ben5049/Keyboard/README.md

# Keyboard

## V3

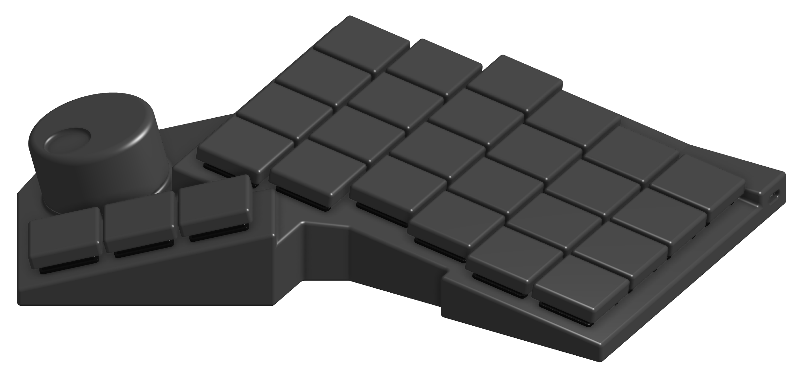
[picture p1: Documentation/Images/keyboard-v3-right.png]
right


Features:
- Wireless
    - 900mAh battery
    - Bluetooth (nRF52)
    - ZMK
- 4 Port USB hub
- BLDC Knob for haptic feedback
- Kailh Choc V1 switches

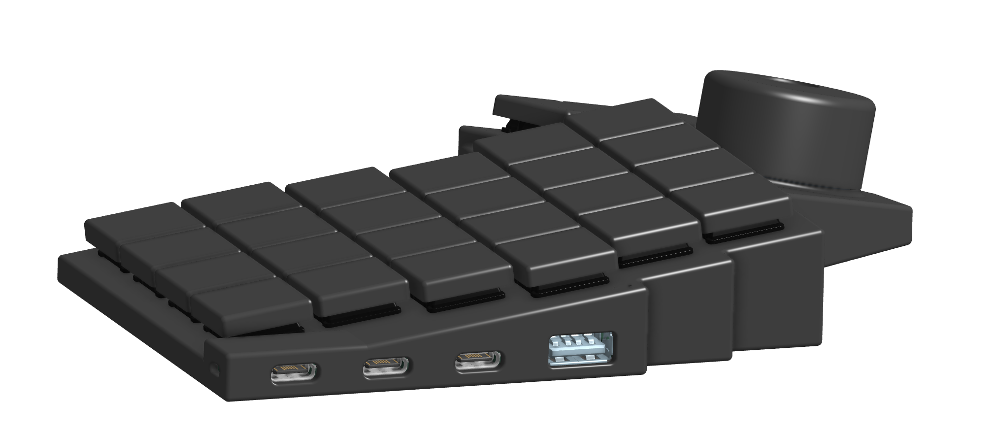
[picture p2: Documentation/Images/keyboard-v3-usb-ports.png]
usb
