ben5049/Keyboard/Documentation/Images/back.png

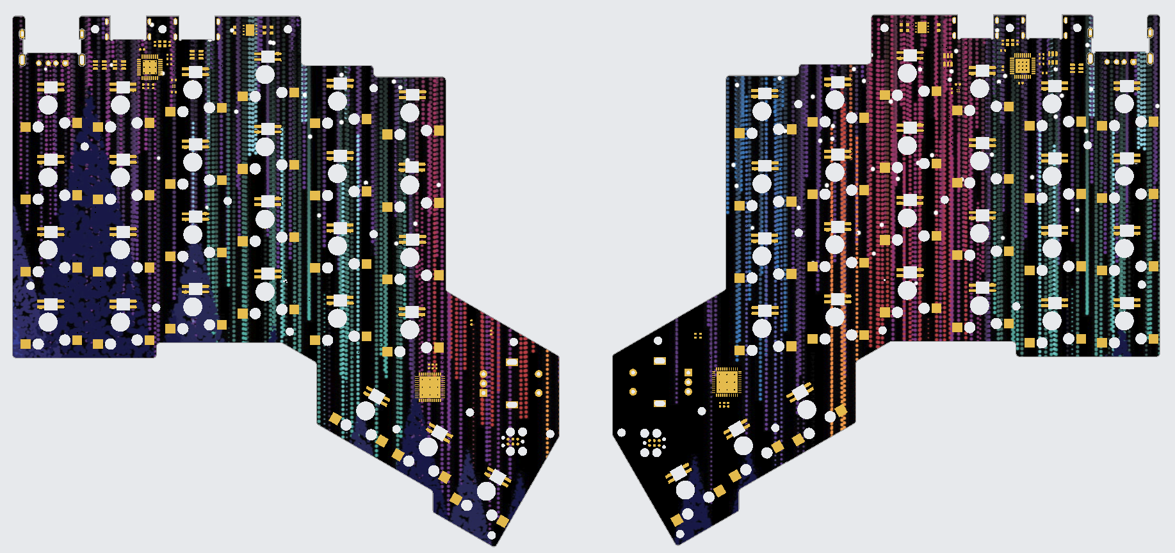
Documentation/Images/back.png
