ben5049/Keyboard/Documentation/Images/left.png

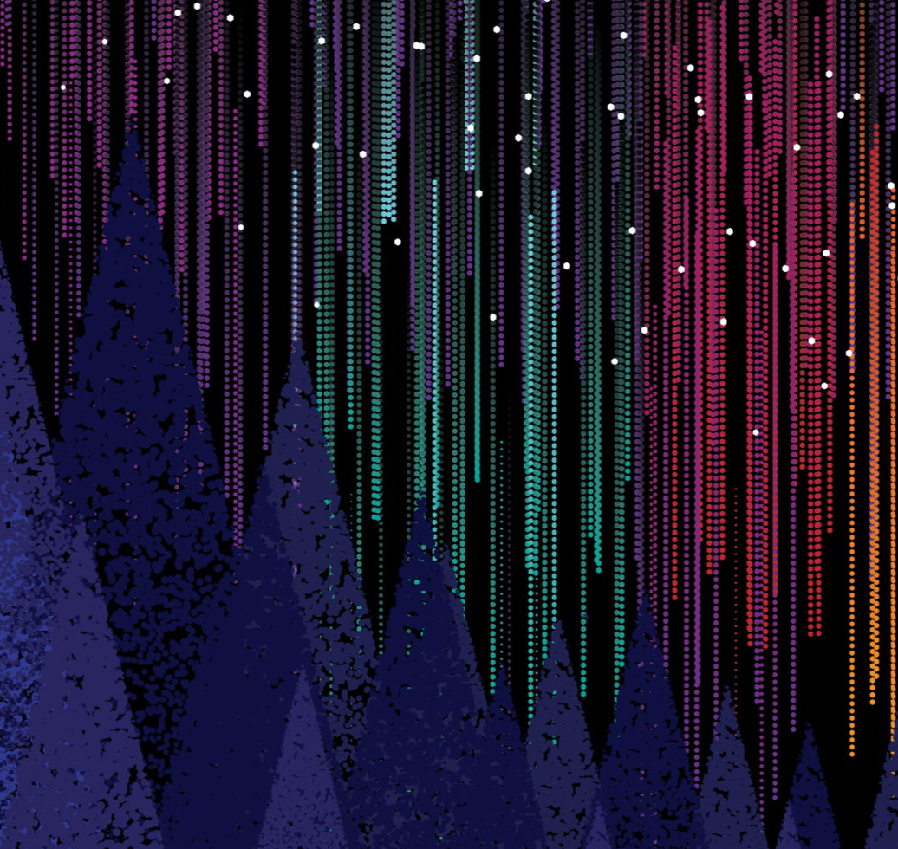
Documentation/Images/left.png
