ben5049/Keyboard/Documentation/Images/Low profile gateron hot swap socket.png

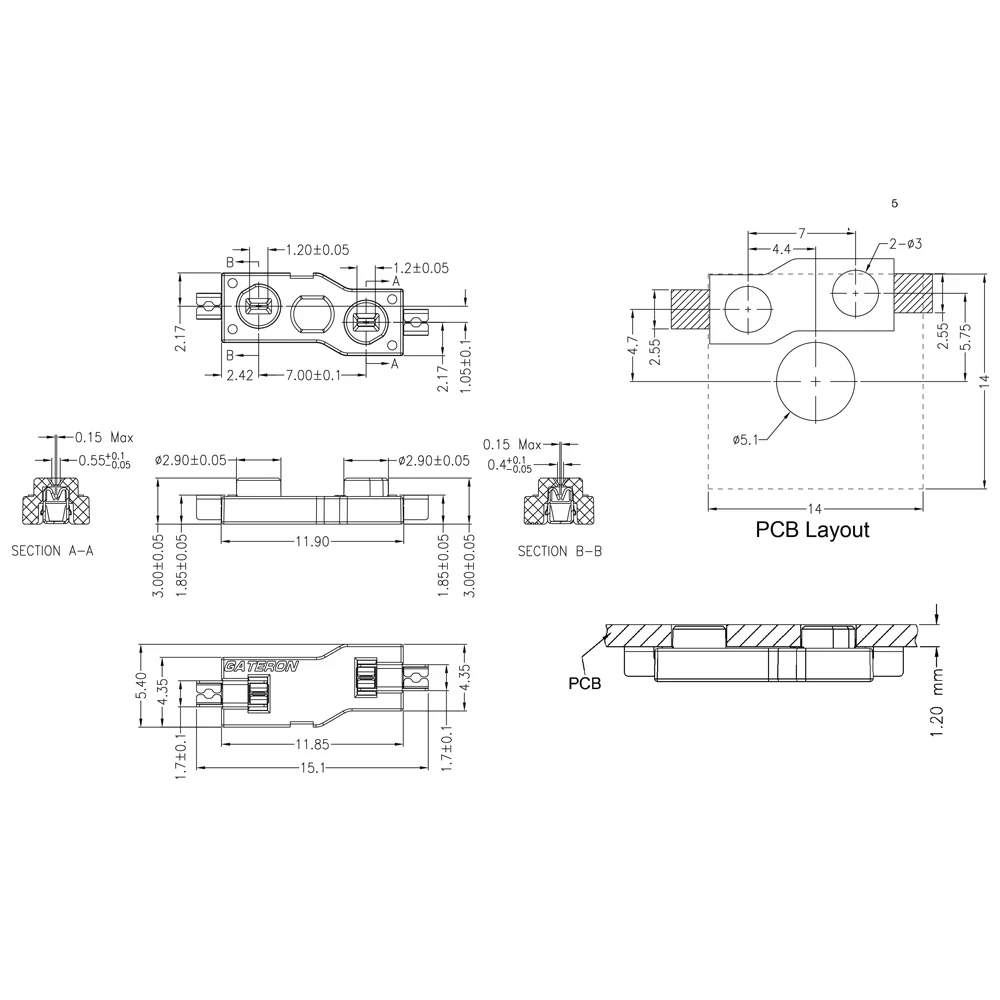
Documentation/Images/Low profile gateron hot swap socket.png
