ben5049/Keyboard/Documentation/Images/right.png

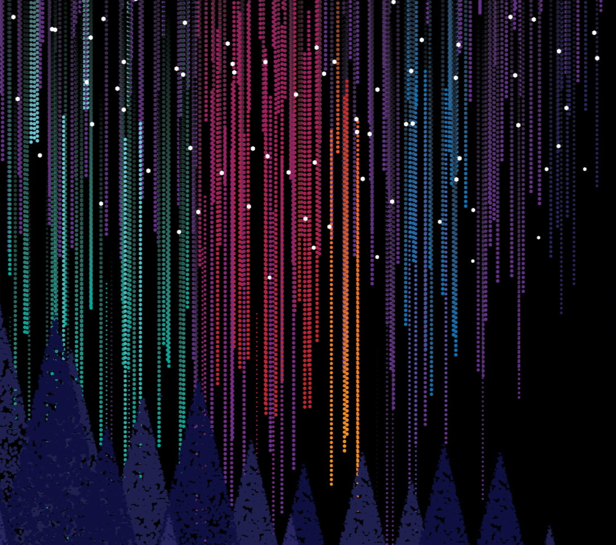
Documentation/Images/right.png
