ben5049/Keyboard/Documentation/Images/wallpaperflare.com_wallpaper.png

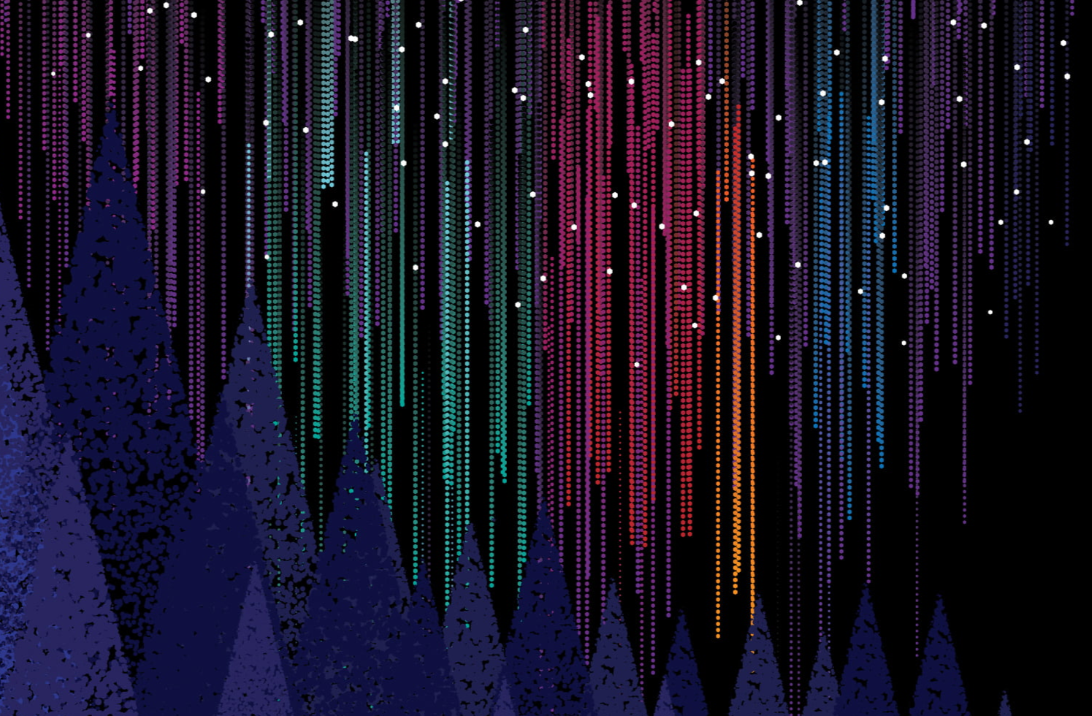
Documentation/Images/wallpaperflare.com_wallpaper.png
