ben5049/Keyboard/Documentation/Images/WIP render.png

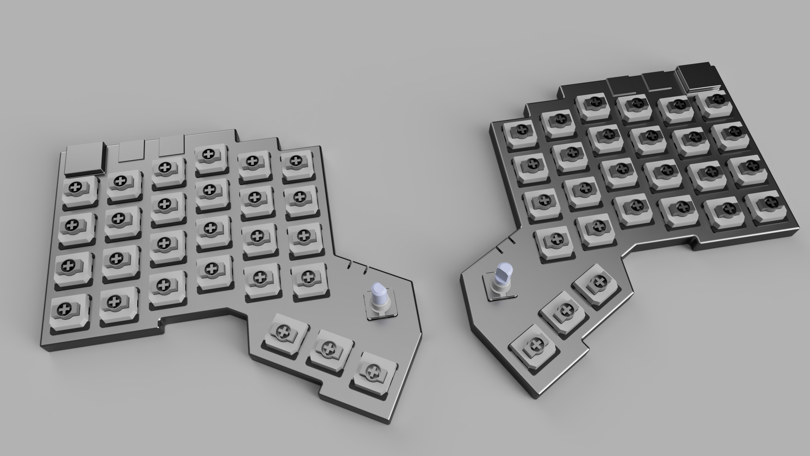
Documentation/Images/WIP render.png
