ben5049/Keyboard/Documentation/BOM.xlsx

Sheet: Overall
 | Unit cost | Quantity bought | Quantity needed | Shipping | Total cost | Single unit cost | Link
Left board | 3.71 | 5 | 1 | 29.61 | 48.16 | 9.63 | https://jlcpcb.com/user-center/orderDetails/?batchNum=W202405140523158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
Right board | 5.04 | 5 | 1 | 29.94 | 55.12 | 11.02 | https://jlcpcb.com/user-center/orderDetails/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,3
Knob | 3.90 | 2 | 2 | 2.99 | 10.79 | 10.79 | https://thepihut.com/products/solid-machined-metal-knob-1-diameter
Cable | 15.92 | 1 | 1 | 12.79 | 28.71 | 28.71 | https://www.bhphotovideo.com/c/product/1734345-REG/kondor_blue_kb_usbc_cra_bk_coiled_usb_c_right_angle.html
Switches | 0.28 | 110 | 54 | 4.76 | 35.76 | 17.55 | https://www.keychron.uk/products/low-profile-gateron-mechanical-switch-set?variant=43373223706794
Keycaps | 27.61 | 1 | 1 | 0.00 | 27.61 | 27.61 | https://www.amazon.co.uk/Womier-Keyboard-Switches-Mechanical-Backlight/dp/B0BVYV67QS
Hot-swap sockets | 0.08 | 70 | 54 | 3.82 | 9.65 | 7.44
Electronic components |  |  |  |  | 66.03 | 51.82
 |  |  |  |  | 0.00
 |  |  |  |  | 0.00
 |  |  |  |  | 0.00
 |  |  |  |  | 0.00
 |  |  |  |  | 281.8288 | 164.59

Sheet: Electronics
 |  | Unit cost | Quantity bought | Quantity needed | Total cost | Single unit cost | Link
SK6812-E | Neopixel | 0.24 | 60 | 54 | 14.16 | 12.74 | https://www.mouser.co.uk/ProductDetail/Adafruit/4960?qs=pBJMDPsKWf1Q%252BqeEoLnQjA%3D%3D
GSB12J21C1EU | USB A | 0.61 | 3 | 2 | 1.82 | 1.22 | https://www.mouser.co.uk/ProductDetail/Amphenol-Commercial-Products/GSB12J21C1EU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
USB4510-03-1-A | USB C | 0.64 | 5 | 4 | 3.20 | 2.56 | https://www.mouser.co.uk/ProductDetail/GCT/USB4510-03-1-A?qs=7D1LtPJG0i3iod3O3OZ7LA%3D%3D
USBLC6-4SC6 | ESD Protection | 0.31 | 7 | 6 | 2.18 | 1.87 | https://www.mouser.co.uk/ProductDetail/STMicroelectronics/USBLC6-4SC6?qs=k9dH%2Fx4GHJCNdehb8zInZg%3D%3D
M24256X-FCU6T/VF | EEPROM | 0.42 | 3 | 2 | 1.25 | 0.83 | https://www.mouser.co.uk/ProductDetail/STMicroelectronics/M24256X-FCU6T-VF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
LM1117LD-3.3_NOPB | Regulator | 1.20 | 3 | 2 | 3.60 | 2.40 | https://www.mouser.co.uk/ProductDetail/Texas-Instruments/LM1117LD-3.3-NOPB?qs=X1J7HmVL2ZGwq0CPAkvTtg%3D%3D
STM32G0C1CEU6 | MCU | 4.88 | 2 | 2 | 9.76 | 9.76 | https://www.mouser.co.uk/ProductDetail/STMicroelectronics/STM32G0C1CEU6?qs=CiayqK2gdcIQOTKCTdXSKw%3D%3D
USB2533-1080AEN | USB Hub | 3.56 | 2 | 2 | 7.12 | 7.12 | https://www.mouser.co.uk/ProductDetail/Microchip-Technology/USB2533-1080AEN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
CX2016SA24000D0HLLG3 | USB Crystal | 0.26 | 3 | 2 | 0.77 | 0.51 | https://www.mouser.co.uk/ProductDetail/KYOCERA-AVX/CX2016SA24000D0HLLG3?qs=Imq1NPwxi75jFZJ74DHKZA%3D%3D
CRGP0402F12K | 12k Resistor | 0.01 | 100 | 2 | 1.50 | 0.03 | https://www.mouser.co.uk/ProductDetail/TE-Connectivity-Holsworthy/CRGP0402F12K
MCASU105SCG100DFNA01 | 10pF Capacitor | 0.01 | 100 | 4 | 1.50 | 0.06 | https://www.mouser.co.uk/ProductDetail/TAIYO-YUDEN/MCASU105SCG100DFNA01
RIC11-31S15K7-TH | Encoder Long | 2.04 | 2 | 0 | 4.08 | 0.00 | https://www.mouser.co.uk/ProductDetail/CUI-Devices/RIC11-31S15K7-TH?qs=HoCaDK9Nz5dozMKAx6eaHw%3D%3D
RIC11-31S10K2-GSMT | Encoder Short | 2.04 | 2 | 2 | 4.08 | 4.08 | https://www.mouser.co.uk/ProductDetail/CUI-Devices/RIC11-31S15K7-TH?qs=HoCaDK9Nz5dozMKAx6eaHw%3D%3D
 |  |  |  | Total | 55.02 | 43.19
 |  |  |  | With VAT | 66.03 | 51.82
