ben5049/Keyboard/CAD/keyboard-v3/debug-cover.step

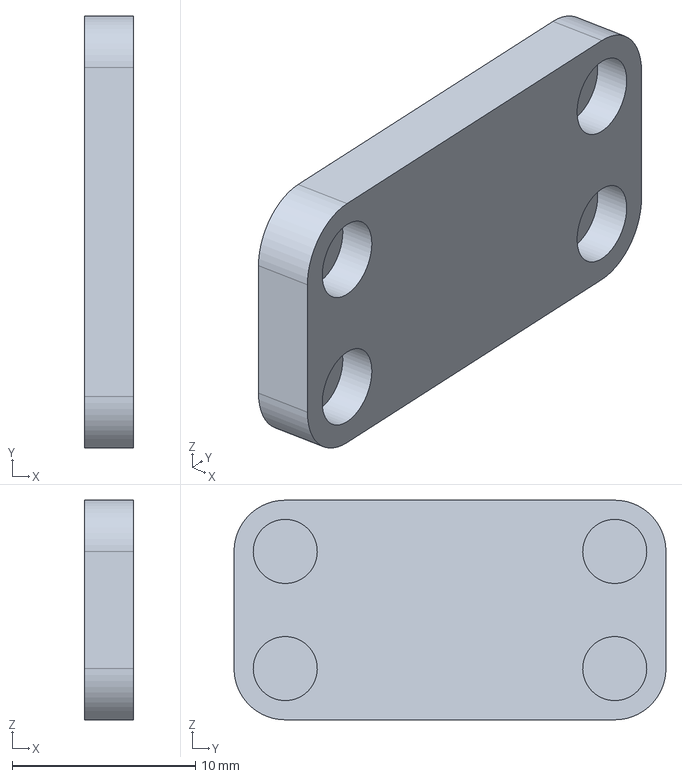
[picture p9: CAD file, 2026-03-02]
CAD/keyboard-v3/debug-cover.step
2.70 x 23.6 x 12.0 mm
