ben5049/Keyboard/PCBs/keyboard-v3/debug-breakout/debug-breakout.step

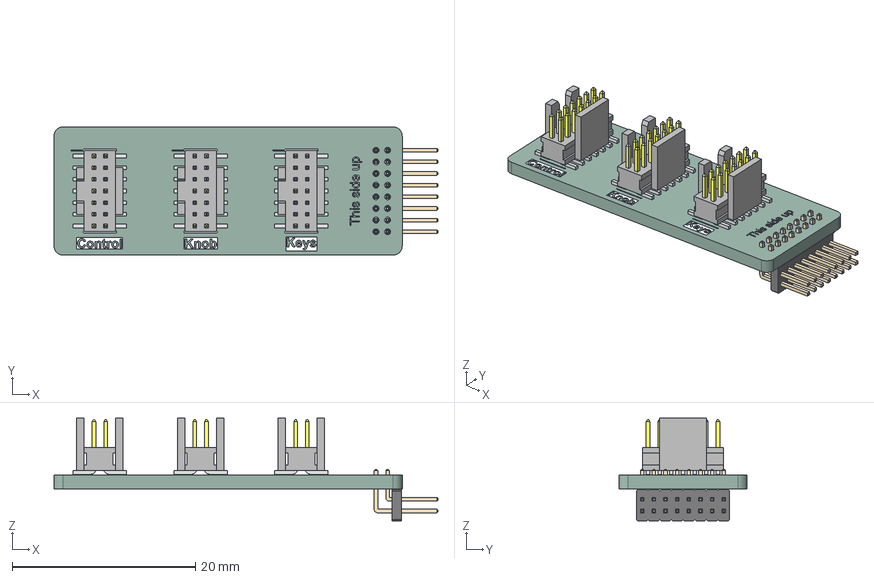
[picture p10: CAD file, 2026-03-02]
PCBs/keyboard-v3/debug-breakout/debug-breakout.step
41.9 x 14.0 x 11.2 mm
FTSH-107-01-L-DV-K_pins2 x 3
FTSH-107-01-L-DV-K_pins1 x 3
FTSH-107-01-L-DV-K_body x 3
PinHeader_2x08_P1.27mm_Horizontal
debug-breakout_silkscreen x 2
debug-breakout_PCB
