ben5049/Keyboard/PCBs/keyboard-v3/drawings/key-fpc-outline.dxf

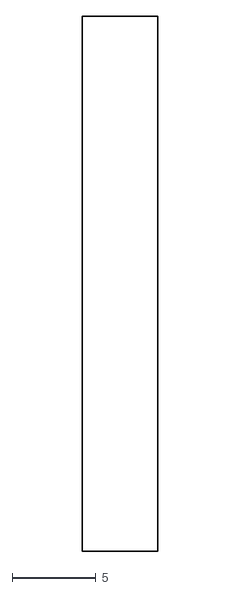
[picture p11: CAD file, 2026-02-13]
PCBs/keyboard-v3/drawings/key-fpc-outline.dxf
4.50 x 32.0
