ben5049/Keyboard/PCBs/keyboard-v3/left-control-board/left-control-board.step

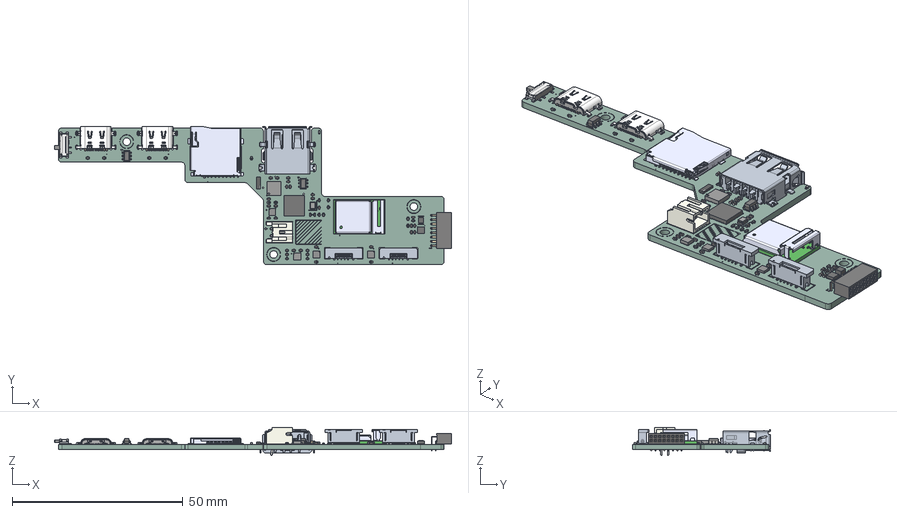
[picture p12: CAD file, 2026-03-02]
PCBs/keyboard-v3/left-control-board/left-control-board.step
116.2 x 40.5 x 8.25 mm
C_0402_1005Metric x 29
PinSocket_2x08_P1.27mm_Horizontal
R_0402_1005Metric x 19
L_Wurth_WE-MAPI_1610
LED_0402_1005Metric
PIN1_AREA
ThermalPin x 2
PinsArrayLR x 2
EMIF06-MSD02N16
Crystal_SMD_2016-4Pin_2.0x1.6mm
NCP380HMU05AATBG x 3
NINA-B302-00B
USB4510 x 2
MSD-1-A
BODY-SON
PIN1-ID
SOT-23-6 x 2
GSB12J21C1EU
PCM12SMTBR
PinsArrayTB
JST_PH_S2B-PH-K_1x02_P2.00mm_Horizontal
left-control-board_silkscreen x 2
left-control-board_PCB
