ben5049/Keyboard/PCBs/keyboard-v3/left-key-board/left-key-board.step

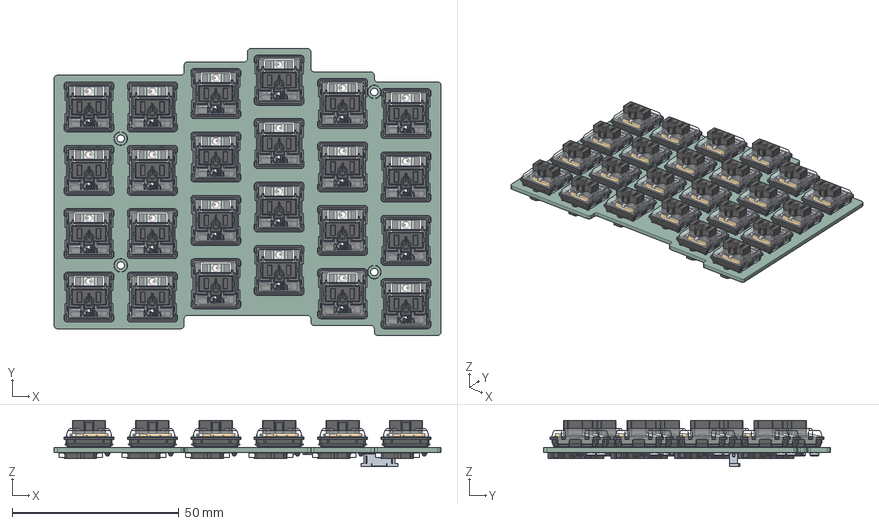
[picture p13: CAD file, 2026-03-02]
PCBs/keyboard-v3/left-key-board/left-key-board.step
116.0 x 86.0 x 13.9 mm
bottom_stabilizer x 24
contact x 24
pin1 x 24
pin2 x 24
top_stabilizer x 24
stabilizer x 24
stem_stabilizer x 24
shrunken_spring x 24
choc_body x 24
contact_a1 x 24
contact_a2 x 24
contact_b x 24
contact_a003 x 24
contact_a004 x 24
contact_b001 x 24
C_0402_1005Metric x 13
R_0402_1005Metric x 5
sk6812mini-e x 24
Pins
ThermalPin
PinsArrayLR
PinsArrayTB
left-key-board_silkscreen x 2
left-key-board_PCB
