ben5049/Keyboard/PCBs/keyboard-v3/left-knob-board/left-knob-board.step

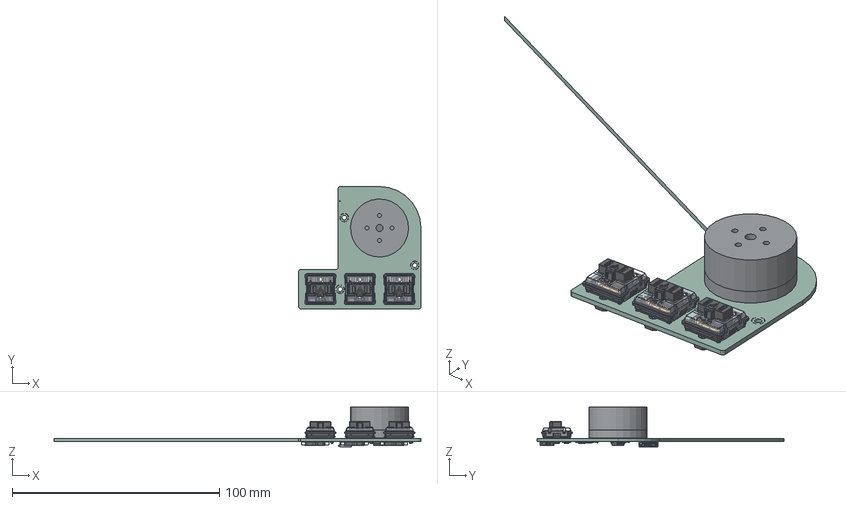
[picture p14: CAD file, 2026-03-02]
PCBs/keyboard-v3/left-knob-board/left-knob-board.step
177.0 x 119.0 x 19.2 mm
bottom_stabilizer x 3
contact x 3
pin1 x 3
pin2 x 3
top_stabilizer x 3
stabilizer x 3
stem_stabilizer x 3
shrunken_spring x 3
choc_body x 3
contact_a1 x 3
contact_a2 x 3
contact_b x 3
contact_a003 x 3
contact_a004 x 3
contact_b001 x 3
Rotor
Stator
C_0402_1005Metric x 12
R_0402_1005Metric x 8
ThermalPin x 2
PinsArrayLR x 2
PinsArrayTB x 2
F31L_L
F31L_R
sk6812mini-e x 3
Pins x 3
C_0603_1608Metric
SOIC-8_3.9x4.9mm_P1.27mm
left-knob-board_silkscreen x 2
left-knob-board_PCB
