ben5049/Keyboard/PCBs/keyboard-v3/right-control-board/right-control-board.step

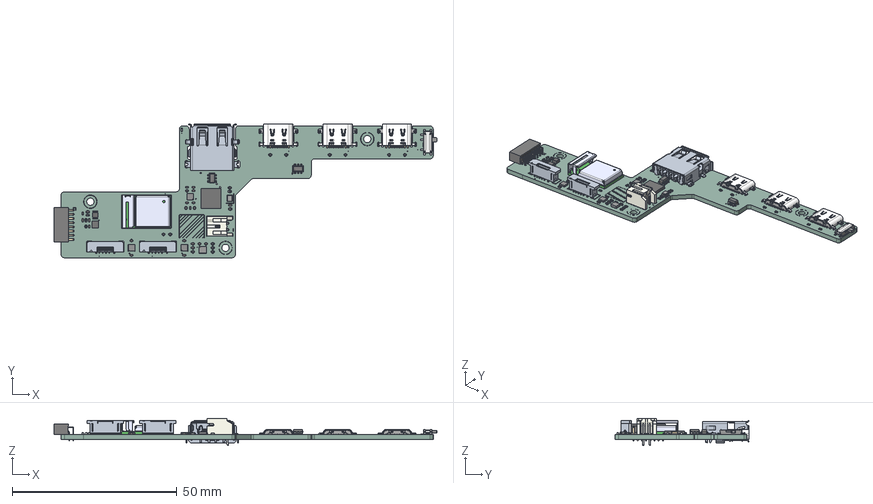
[picture p15: CAD file, 2026-03-02]
PCBs/keyboard-v3/right-control-board/right-control-board.step
116.1 x 40.5 x 8.25 mm
C_0402_1005Metric x 20
PinSocket_2x08_P1.27mm_Horizontal
R_0402_1005Metric x 21
L_Wurth_WE-MAPI_1610
USB4510 x 3
LED_0402_1005Metric
PIN1_AREA
ThermalPin
PinsArrayLR
Crystal_SMD_2016-4Pin_2.0x1.6mm
NCP380HMU05AATBG x 3
NINA-B302-00B
BODY-SON
PIN1-ID
SOT-23-6 x 2
GSB12J21C1EU
PCM12SMTBR
JST_PH_S2B-PH-K_1x02_P2.00mm_Horizontal
right-control-board_silkscreen x 2
right-control-board_PCB
