ben5049/Keyboard/PCBs/keyboard-v3/right-key-board/right-key-board.step

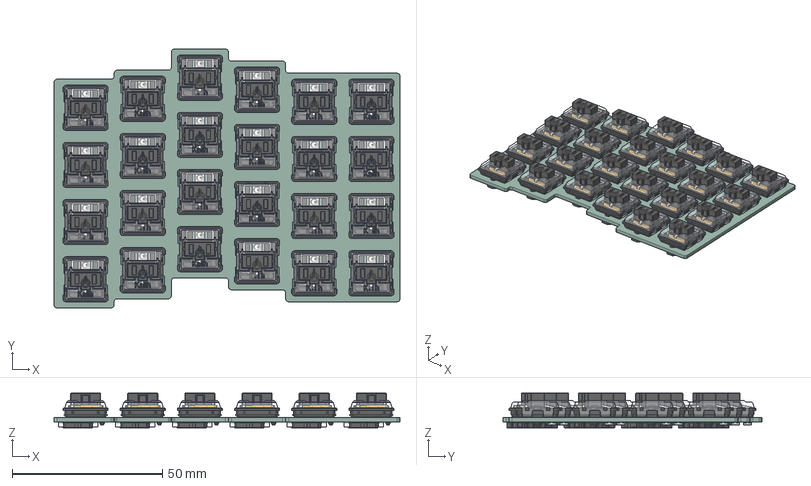
[picture p16: CAD file, 2026-02-08]
PCBs/keyboard-v3/right-key-board/right-key-board.step
115.0 x 86.0 x 11.5 mm
bottom_stabilizer x 24
contact x 24
pin1 x 24
pin2 x 24
top_stabilizer x 24
stabilizer x 24
stem_stabilizer x 24
shrunken_spring x 24
choc_body x 24
contact_a1 x 24
contact_a2 x 24
contact_b x 24
contact_a003 x 24
contact_a004 x 24
contact_b001 x 24
sk6812mini-e x 24
right-key-board_PCB
