ben5049/Keyboard/CAD/keyboard-v3/knob.step

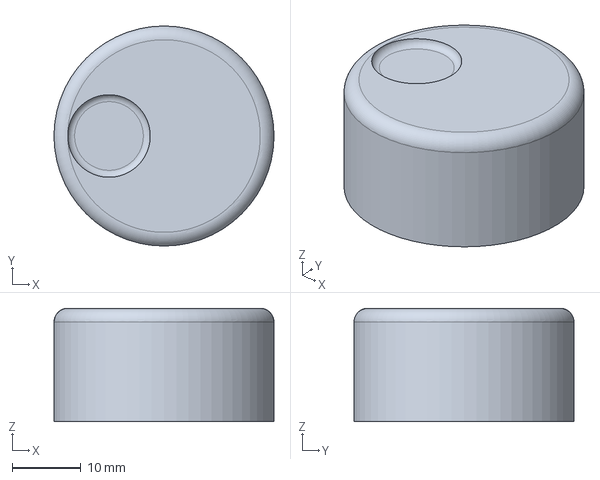
[picture p18: CAD file, 2026-03-02]
CAD/keyboard-v3/knob.step
32.0 x 32.0 x 16.5 mm
