ben5049/Keyboard/PCBs/keyboard-v3/drawings/knob-fpc-mask.dxf

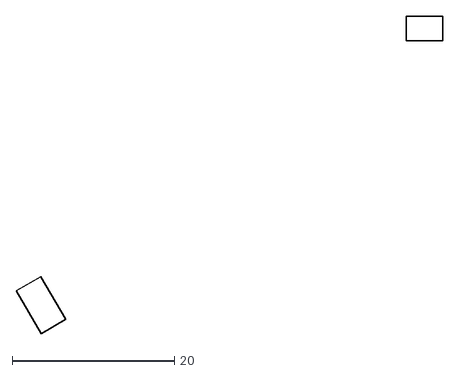
[picture p19: CAD file, 2026-02-13]
PCBs/keyboard-v3/drawings/knob-fpc-mask.dxf
52.5 x 39.1
