ben5049/Keyboard/CAD/keyboard-v3/left-base.step

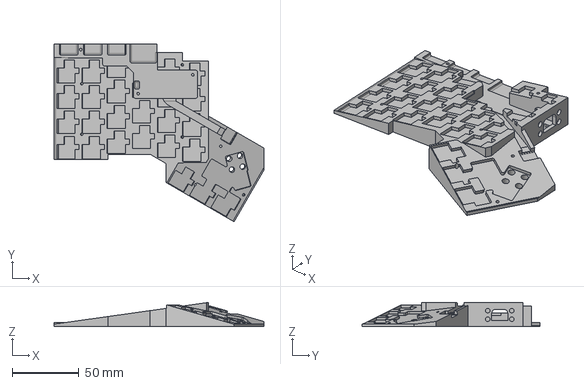
[picture p20: CAD file, 2026-03-02]
CAD/keyboard-v3/left-base.step
157.3 x 133.0 x 18.1 mm
