ben5049/Keyboard/PCBs/keyboard-v3/drawings/knob-fpc-stiffener.dxf

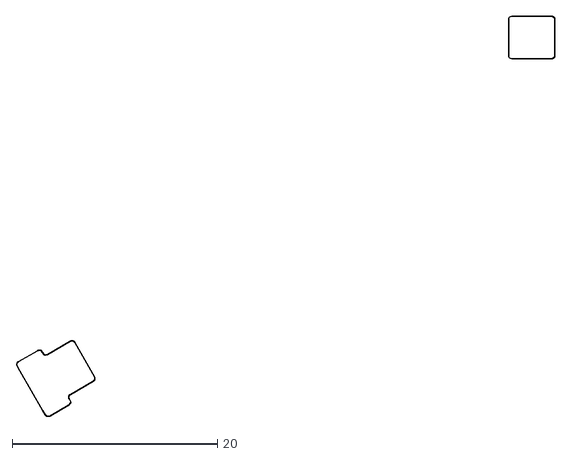
[picture p21: CAD file, 2026-02-13]
PCBs/keyboard-v3/drawings/knob-fpc-stiffener.dxf
52.5 x 39.0
