ben5049/Keyboard/PCBs/keyboard-v3/drawings/knob-fpc-traces.dxf

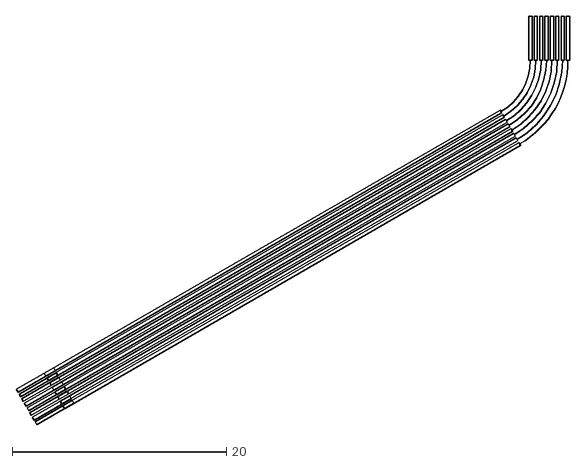
[picture p22: CAD file, 2026-02-13]
PCBs/keyboard-v3/drawings/knob-fpc-traces.dxf
51.6 x 38.1
