ben5049/Keyboard/CAD/keyboard-v3/left-case.step

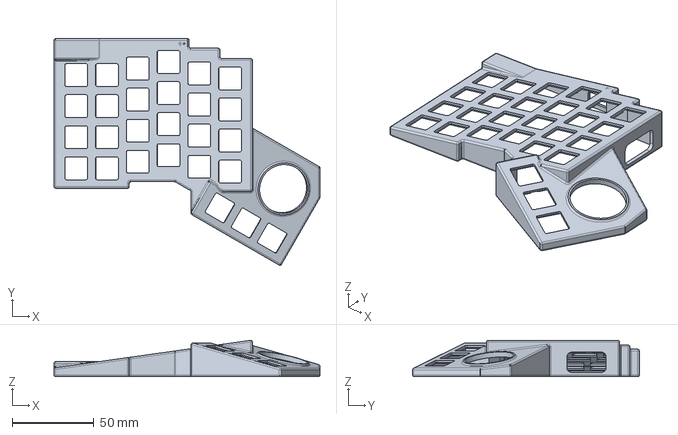
[picture p23: CAD file, 2026-03-02]
CAD/keyboard-v3/left-case.step
162.7 x 138.6 x 22.2 mm
