ben5049/Keyboard/PCBs/keyboard-v3/drawings/right-control-board-layout.dxf

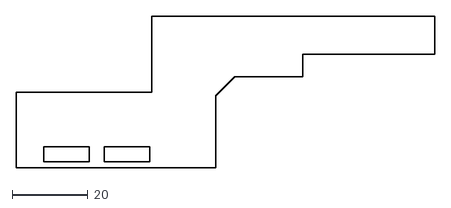
[picture p24: CAD file, 2026-02-12]
PCBs/keyboard-v3/drawings/right-control-board-layout.dxf
110.9 x 40.0
