ben5049/Keyboard/PCBs/keyboard-v3/drawings/knob-fpc-outline.dxf

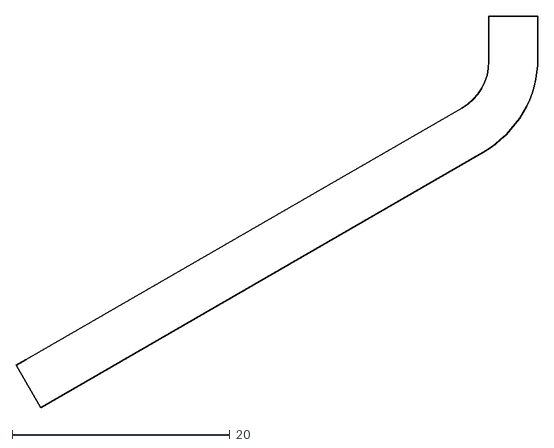
[picture p25: CAD file, 2026-02-12]
PCBs/keyboard-v3/drawings/knob-fpc-outline.dxf
48.0 x 36.0
