ben5049/Keyboard/CAD/keyboard-v3/right-battery-cover.step

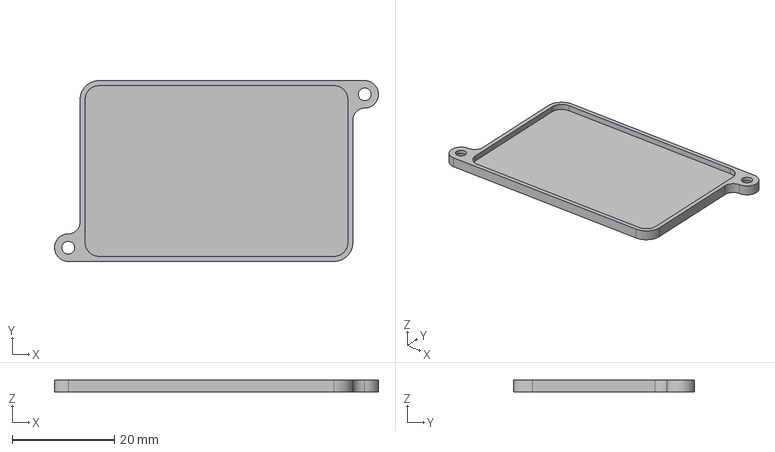
[picture p26: CAD file, 2026-03-02]
CAD/keyboard-v3/right-battery-cover.step
63.4 x 35.4 x 2.30 mm
