ben5049/Keyboard/PCBs/keyboard-v3/drawings/right-knob-board-outline.dxf

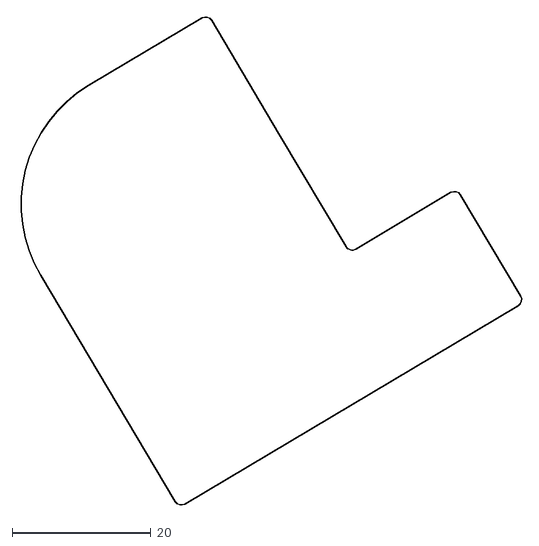
[picture p27: CAD file, 2026-02-11]
PCBs/keyboard-v3/drawings/right-knob-board-outline.dxf
73.1 x 70.7
