ben5049/Keyboard/PCBs/keyboard-v3/drawings/right-control-board-outline.dxf

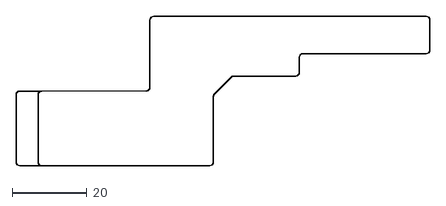
[picture p28: CAD file, 2026-02-11]
PCBs/keyboard-v3/drawings/right-control-board-outline.dxf
110.9 x 40.0
