ben5049/Keyboard/PCBs/keyboard-v3/drawings/right-key-board-outline.dxf

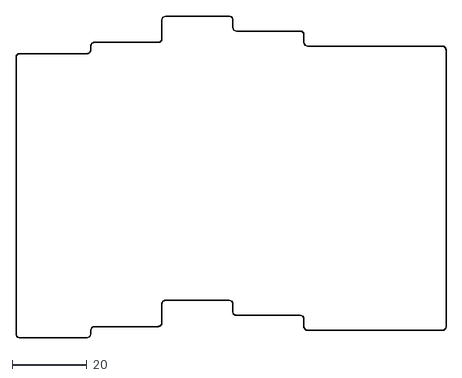
[picture p29: CAD file, 2026-02-10]
PCBs/keyboard-v3/drawings/right-key-board-outline.dxf
115.0 x 86.0
