ben5049/Keyboard/PCBs/keyboard-v3/drawings/right-key-board-layout.dxf

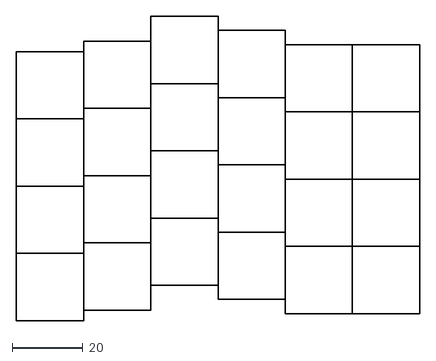
[picture p30: CAD file, 2026-02-10]
PCBs/keyboard-v3/drawings/right-key-board-layout.dxf
114.0 x 86.0
