ben5049/Keyboard/PCBs/keyboard-v3/drawings/right-key-board-components.dxf

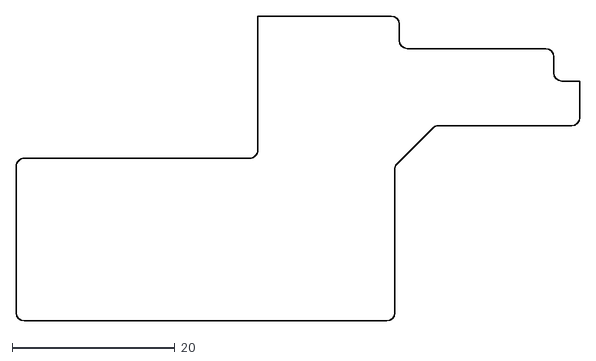
[picture p31: CAD file, 2026-02-10]
PCBs/keyboard-v3/drawings/right-key-board-components.dxf
69.3 x 37.5
