ben5049/Keyboard/PCBs/keyboard-v3/drawings/right-knob-board-layout.dxf

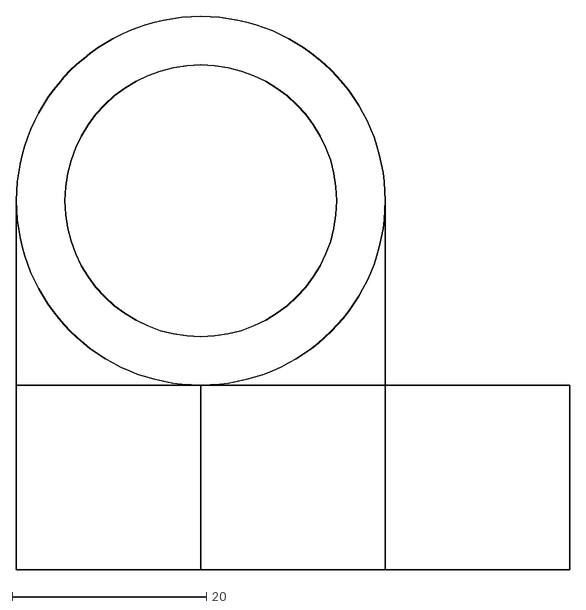
[picture p32: CAD file, 2026-02-08]
PCBs/keyboard-v3/drawings/right-knob-board-layout.dxf
57.0 x 57.0
