ben5049/Keyboard/(list of files, cad)

Other CAD files:
CAD/keyboard-v3/right-base.step
CAD/keyboard-v3/right-case.step
CAD/keyboard-v3/left-battery-cover.step
CAD/keyboard-v1/LED Cover x8.stl
CAD/keyboard-v1/LED Cover.stl
CAD/keyboard-v1/Left bottom no holes.stl
CAD/keyboard-v1/Left bottom.stl
CAD/keyboard-v1/Left frame.stl
CAD/keyboard-v1/Right bottom no holes.stl
CAD/keyboard-v1/Right bottom.stl
CAD/keyboard-v1/Right frame.stl
CAD/keyboard-v1/whole assembly.f3z
CAD/keyboard-v1/whole assembly.step
