ben5049/Keyboard/PCBs/keyboard-v3/left-control-board/left-control-board.pdf

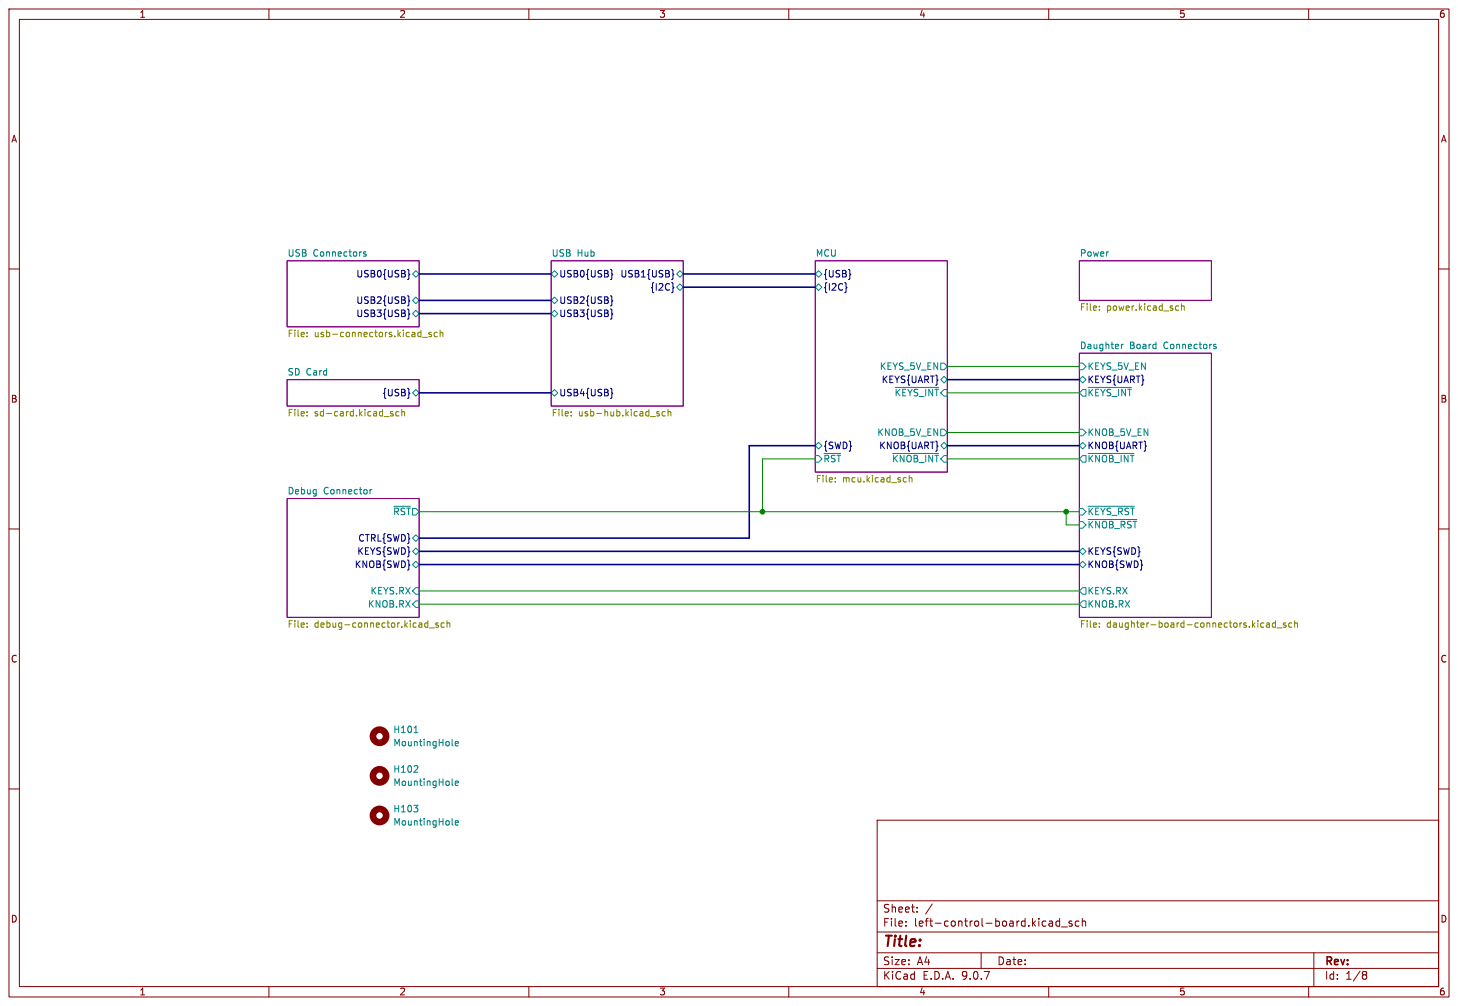
[picture p33: page 1]

USB2{USB} USB Hub File: usb-hub.kicad_sch H101 MountingHole H102 MountingHole H103 MountingHole

KNOB.RX Daughter Board Connectors File: daughter-board-connectors.kicad_sch Power File: power.kicad_sch
~{KNOB_RST} KEYS_5V_EN
KEYS{UART}
~{KEYS_INT} KNOB_5V_EN
~{KNOB_INT} KEYS.RX

USB3{USB} USB Connectors File: usb-connectors.kicad_sch

File: mcu.kicad_sch USB0{USB} USB1{USB}

KNOB.RX Debug Connector File: debug-connector.kicad_sch

Id: 1/8 Title: File: left-control-board.kicad_sch Sheet: / CTRL{SWD}
KEYS{SWD}
KNOB{SWD}

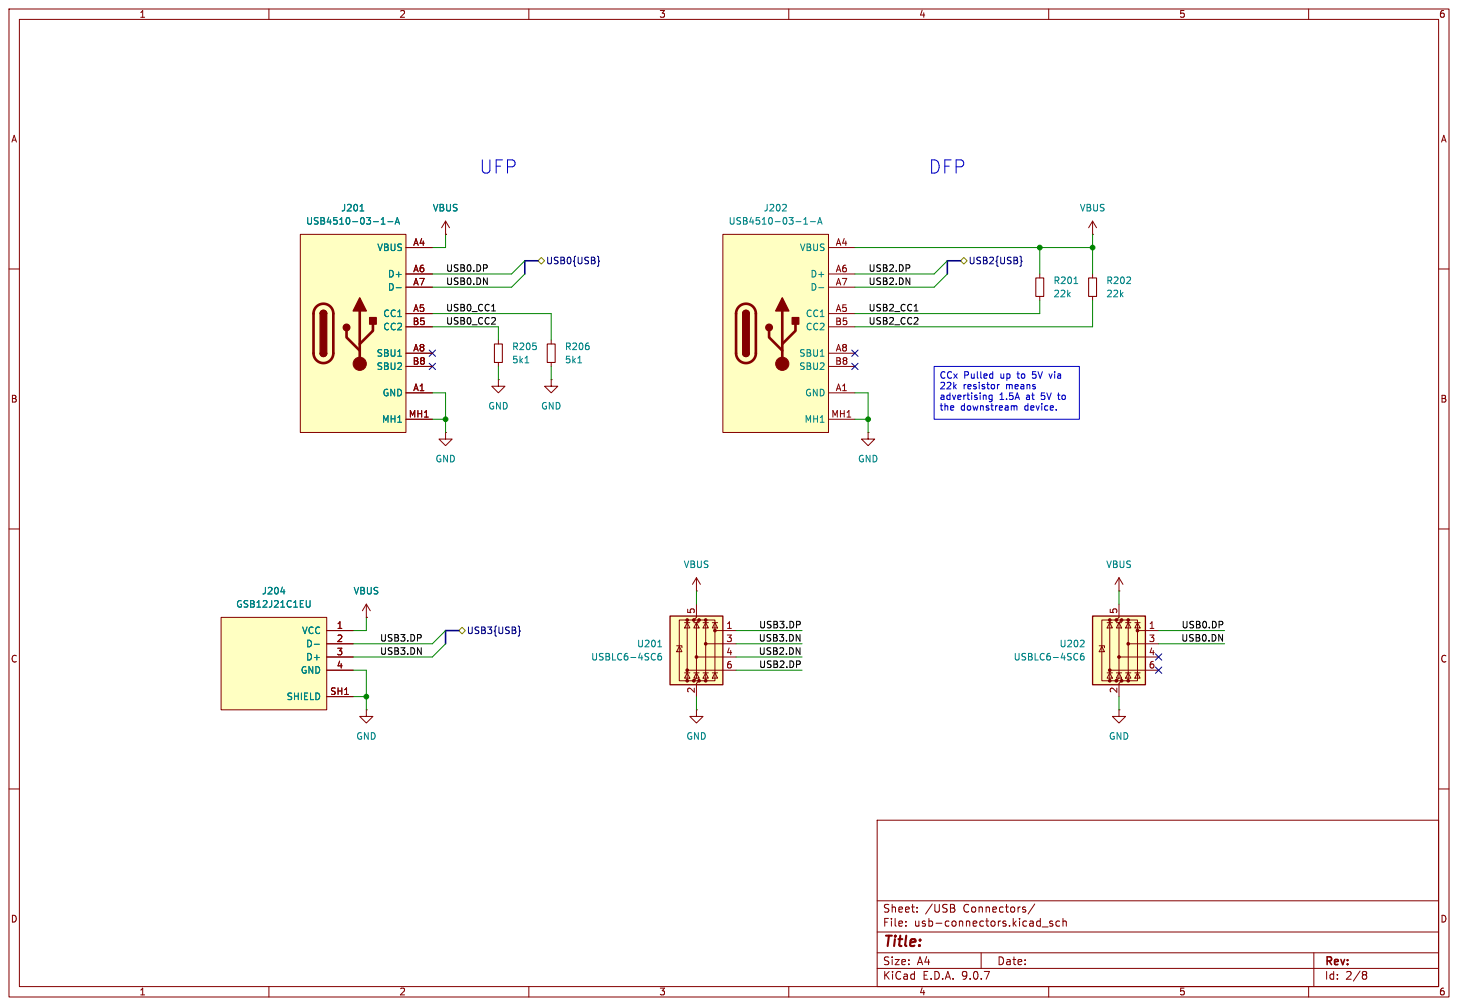
[picture p34: page 2]

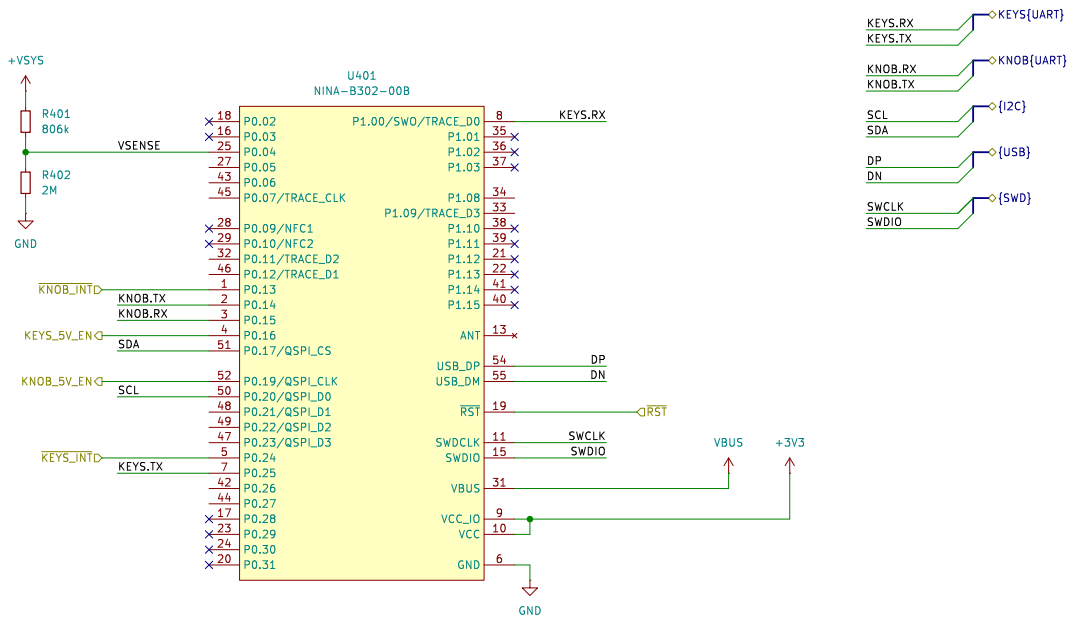
[picture p35: page 3]

Id: 4/8 Title: File: mcu.kicad_sch Sheet: /MCU/

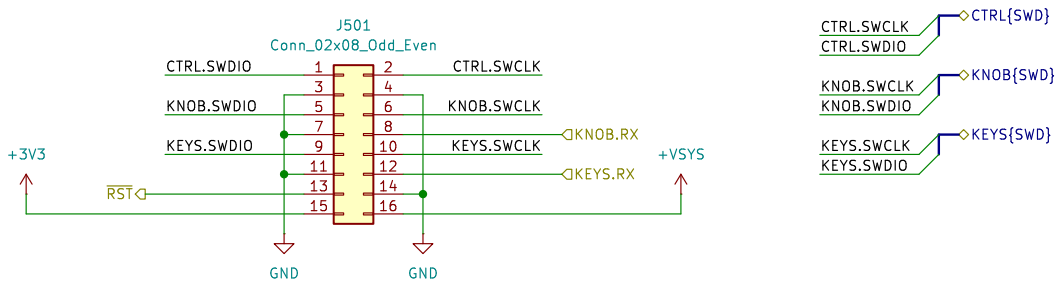
[picture p36: page 4]

5 7 | J501 Conn_02x08_Odd_Even GND | 6 8

CTRL.SWCLK

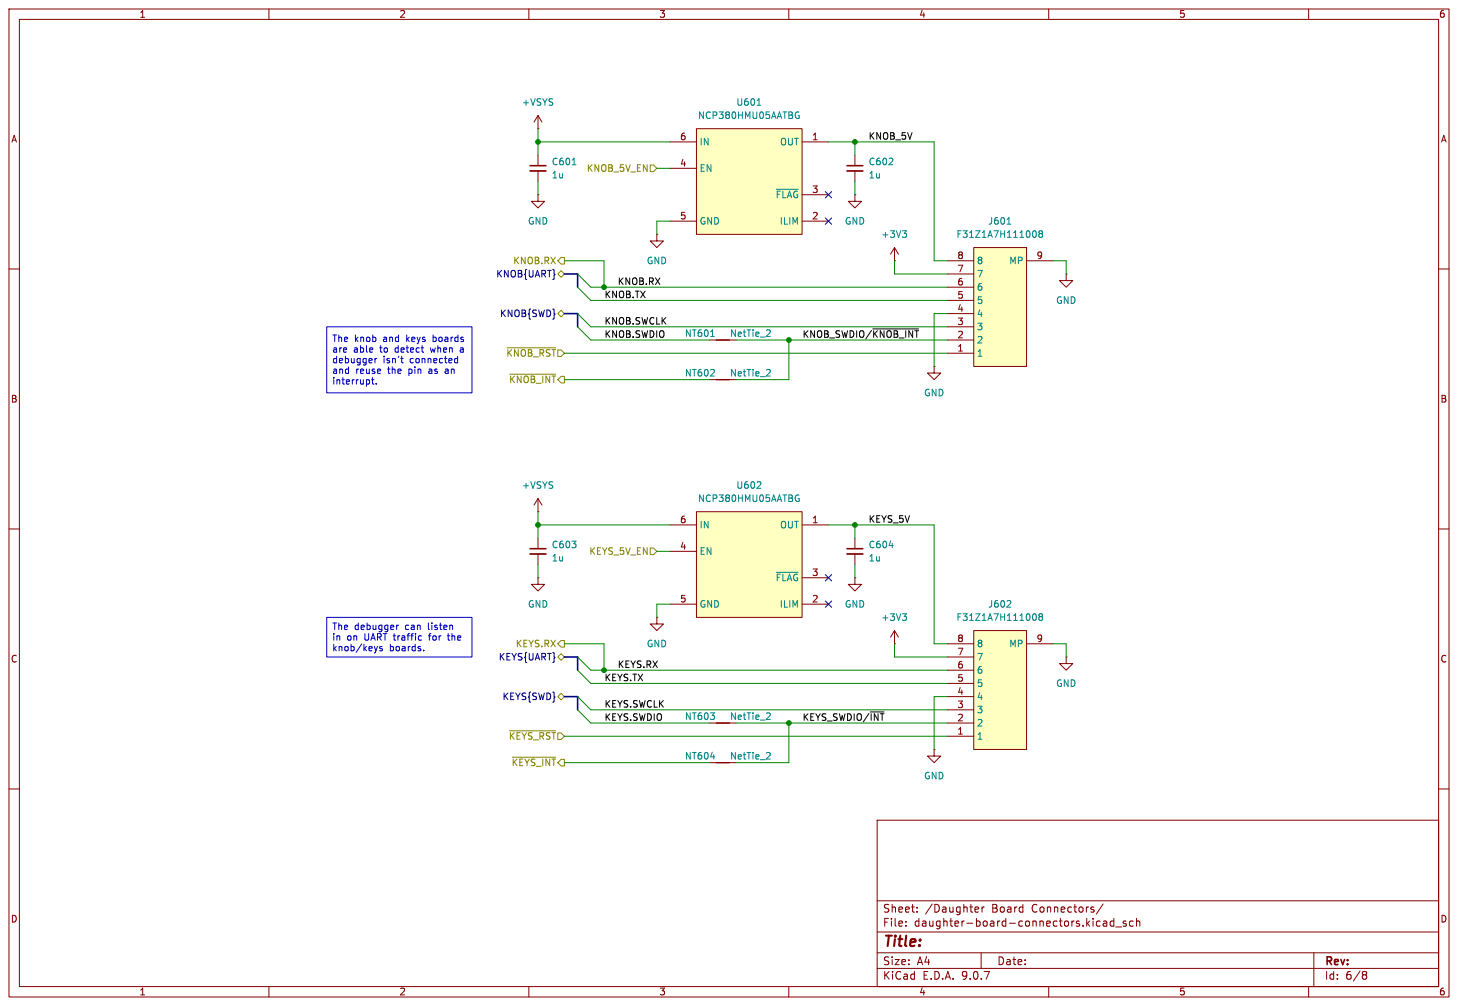
[picture p37: page 5]

interrupt. The debugger can listen

debugger isn't connected
and reuse the pin as an

KEYS{UART} KEYS.RX

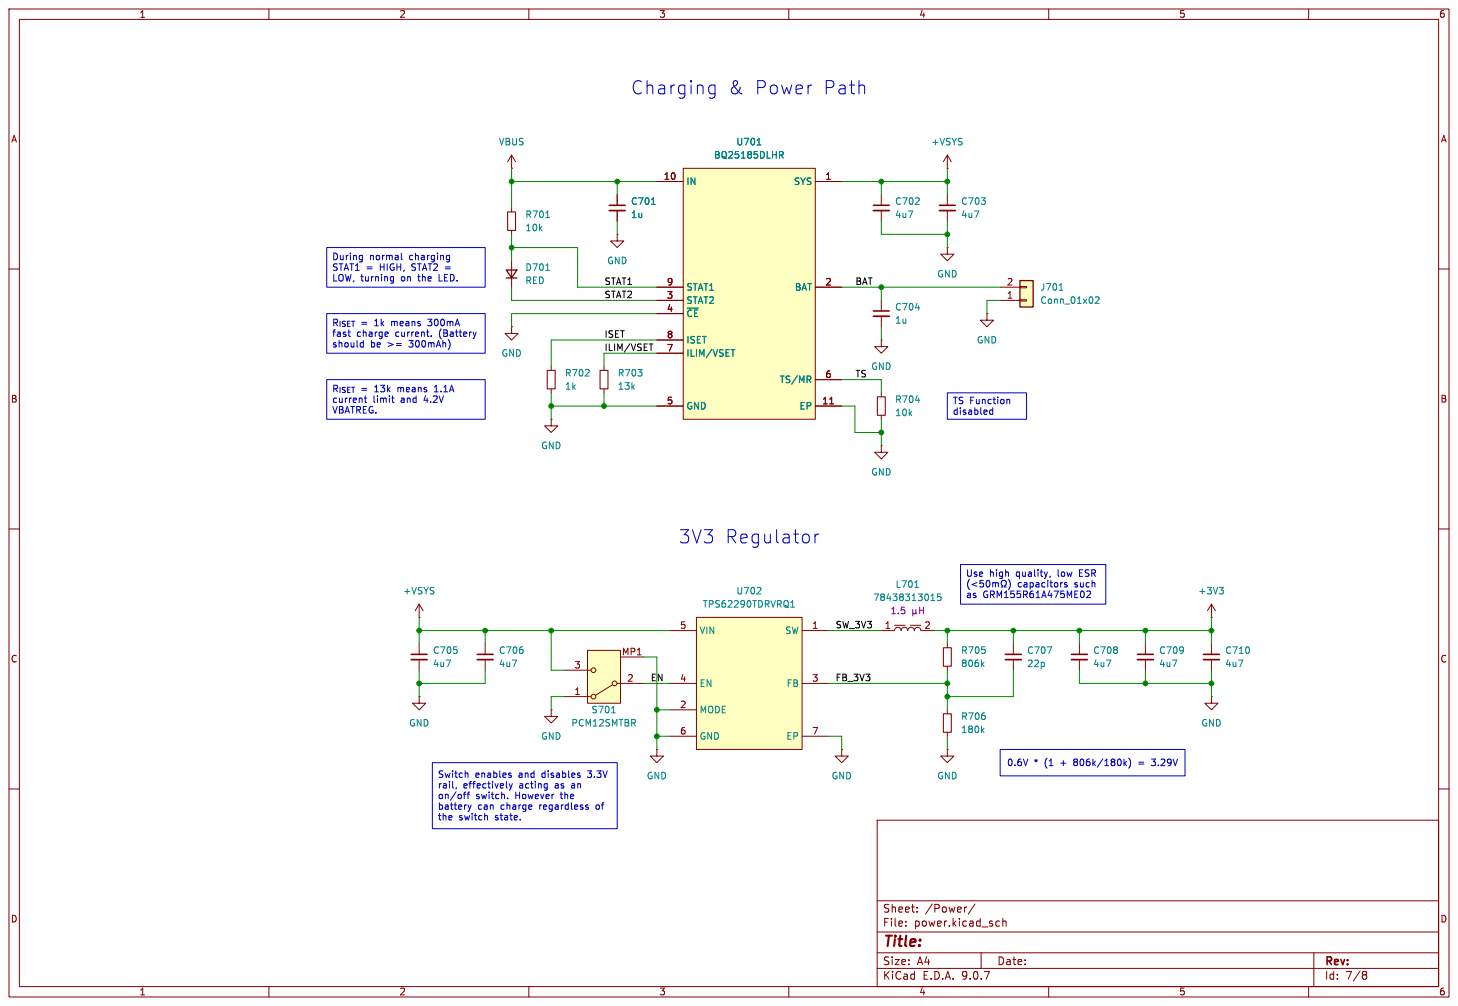
[picture p38: page 6]

During normal charging STAT1 = HIGH, STAT2 =

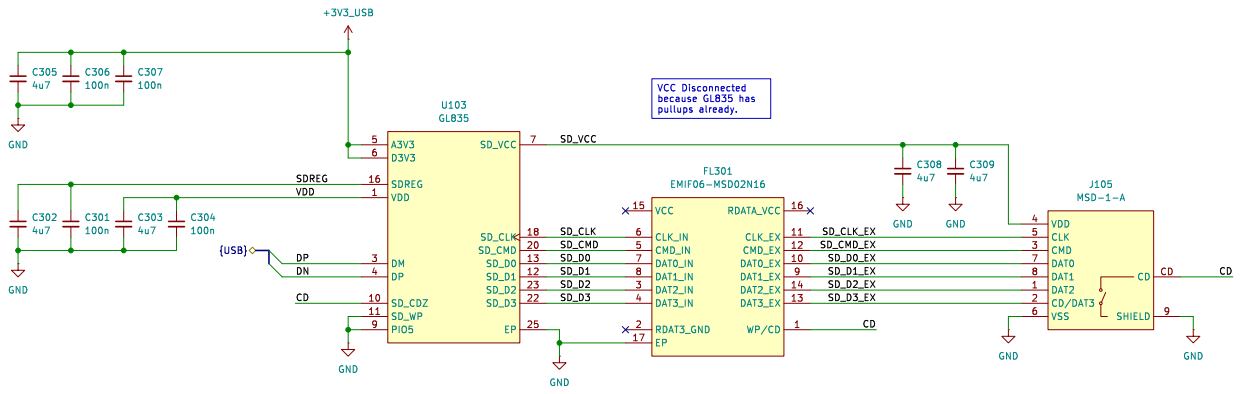
[picture p39: page 7]

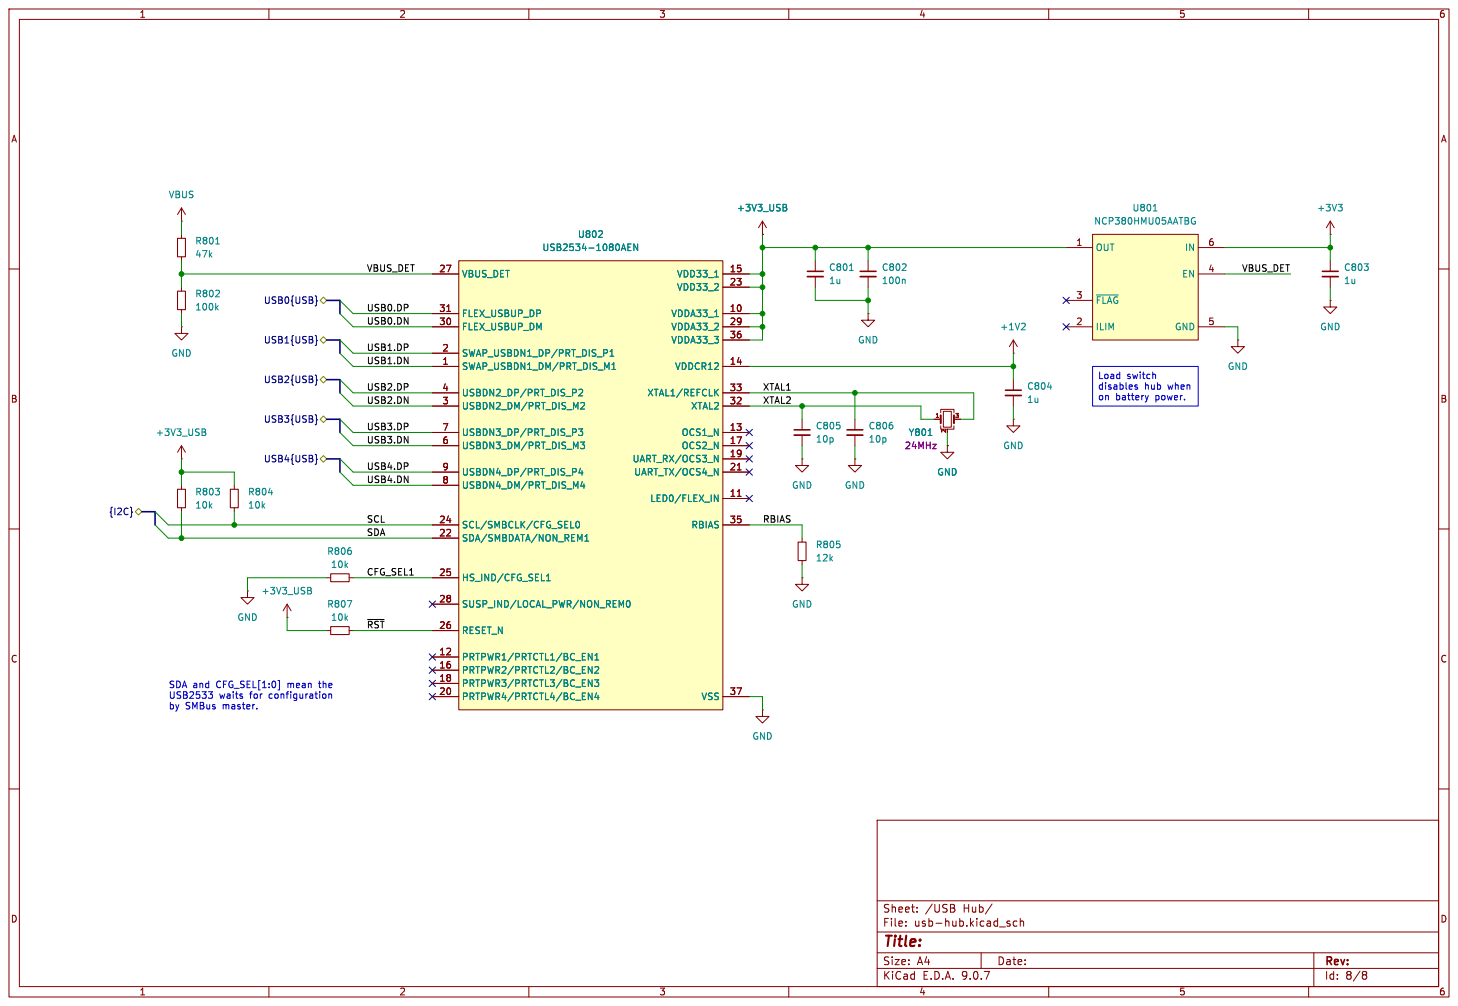
[picture p40: page 8]

on battery power. SDA and CFG_SEL[1:0] mean the USB2533 waits for configuration
