ben5049/Keyboard/PCBs/keyboard-v3/left-key-board/left-key-board.pdf

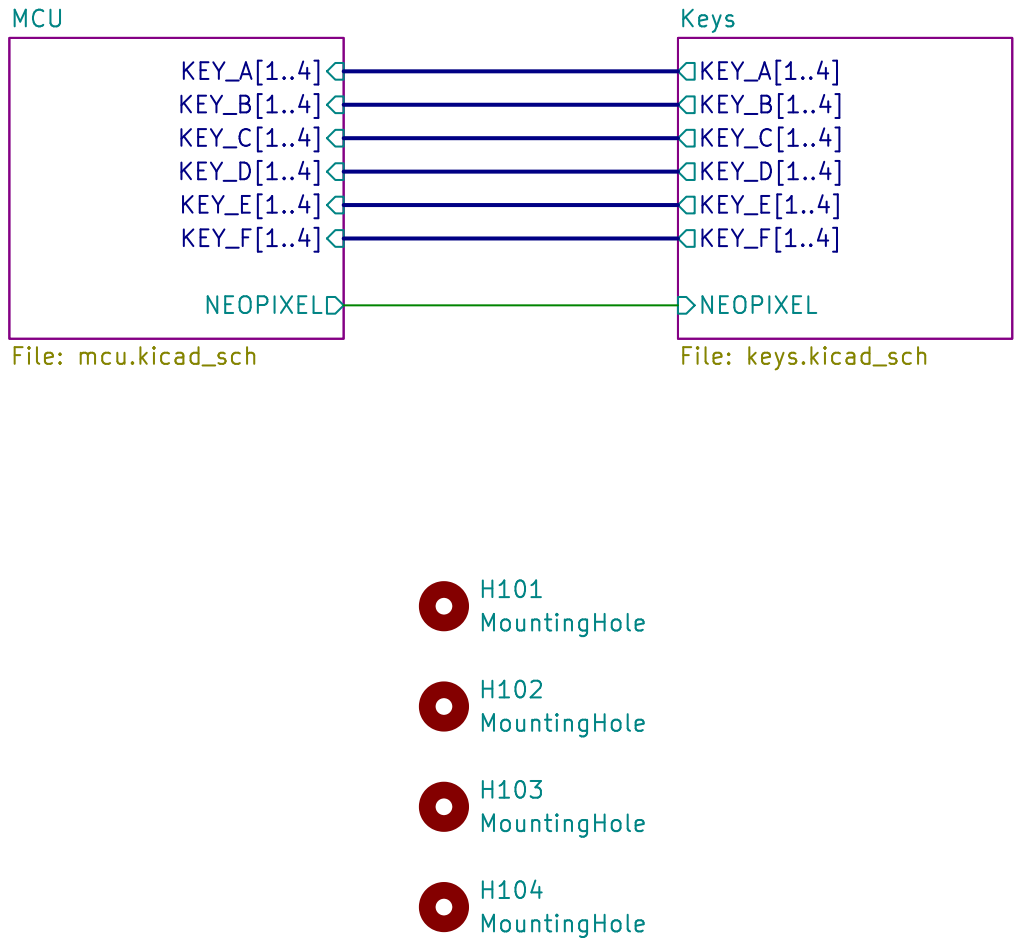
[picture p41: page 1]

Keys File: keys.kicad_sch H101 MountingHole H104 MountingHole H102 MountingHole H103 MountingHole

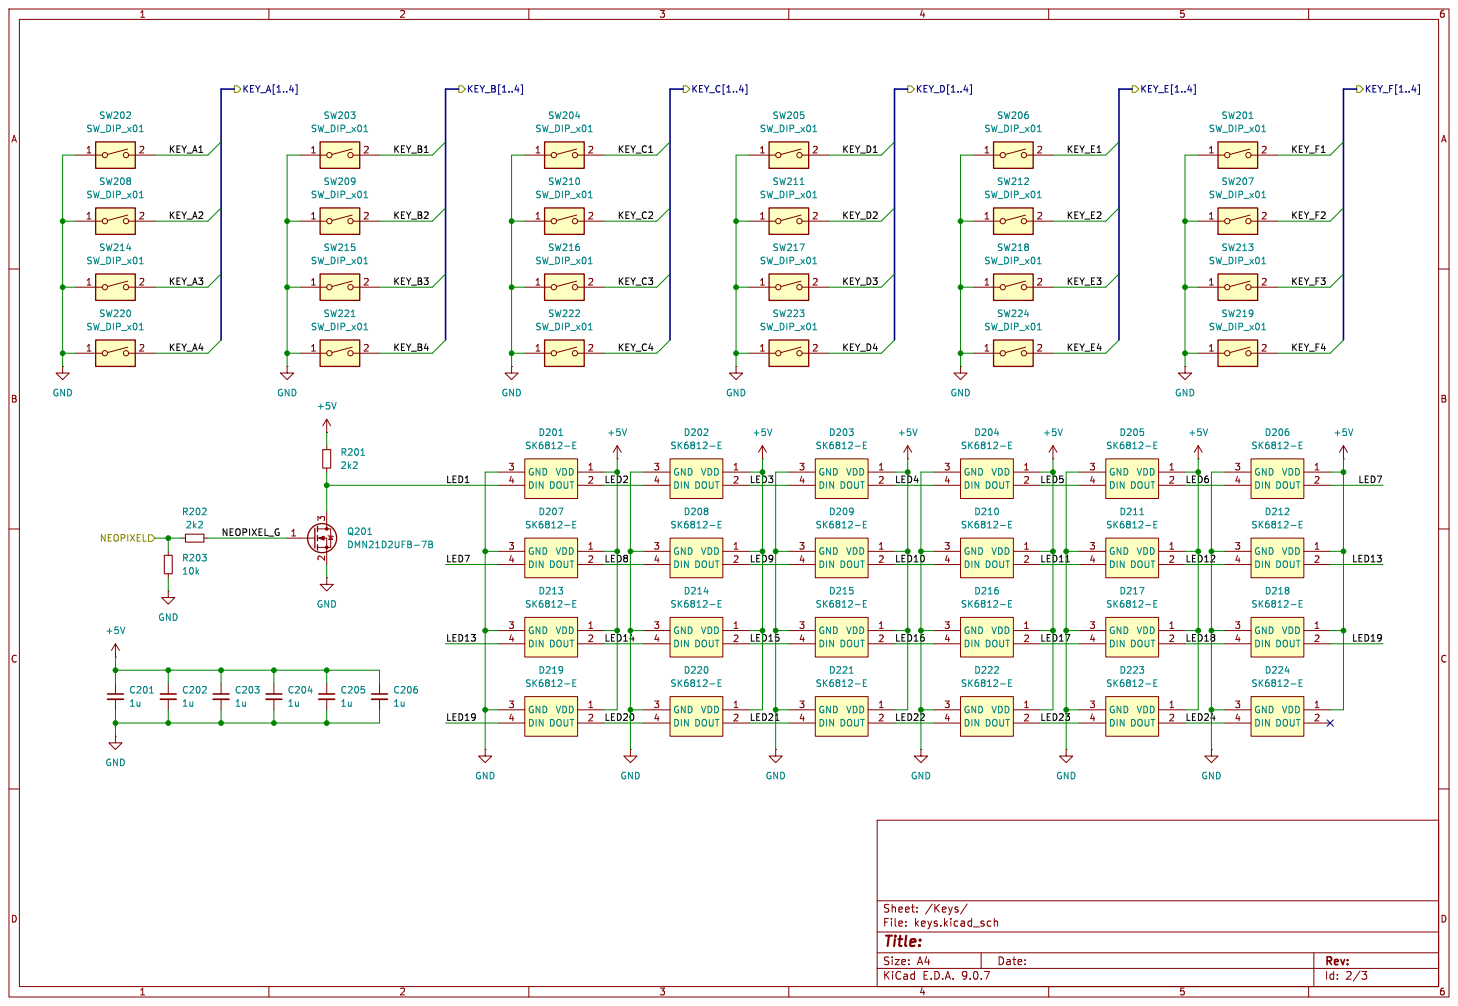
[picture p42: page 2]

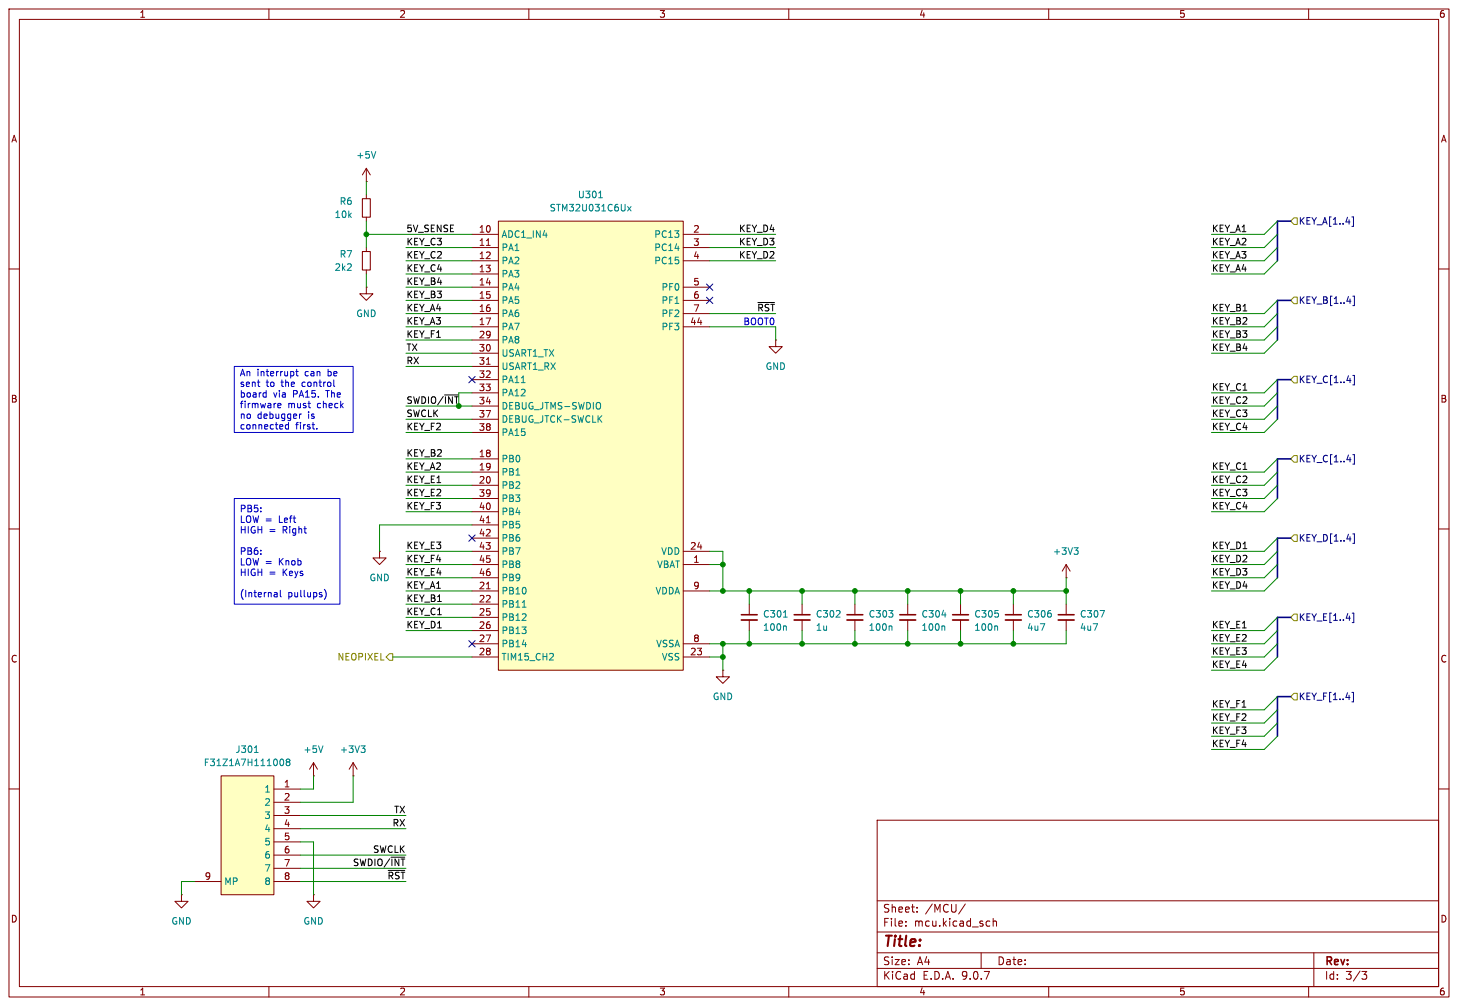
[picture p43: page 3]

sent to the control board via PA15. The

PB5: LOW = Left HIGH = Right PB6: LOW = Knob HIGH = Keys
