ben5049/Keyboard/PCBs/keyboard-v3/left-knob-board/left-knob-board.pdf

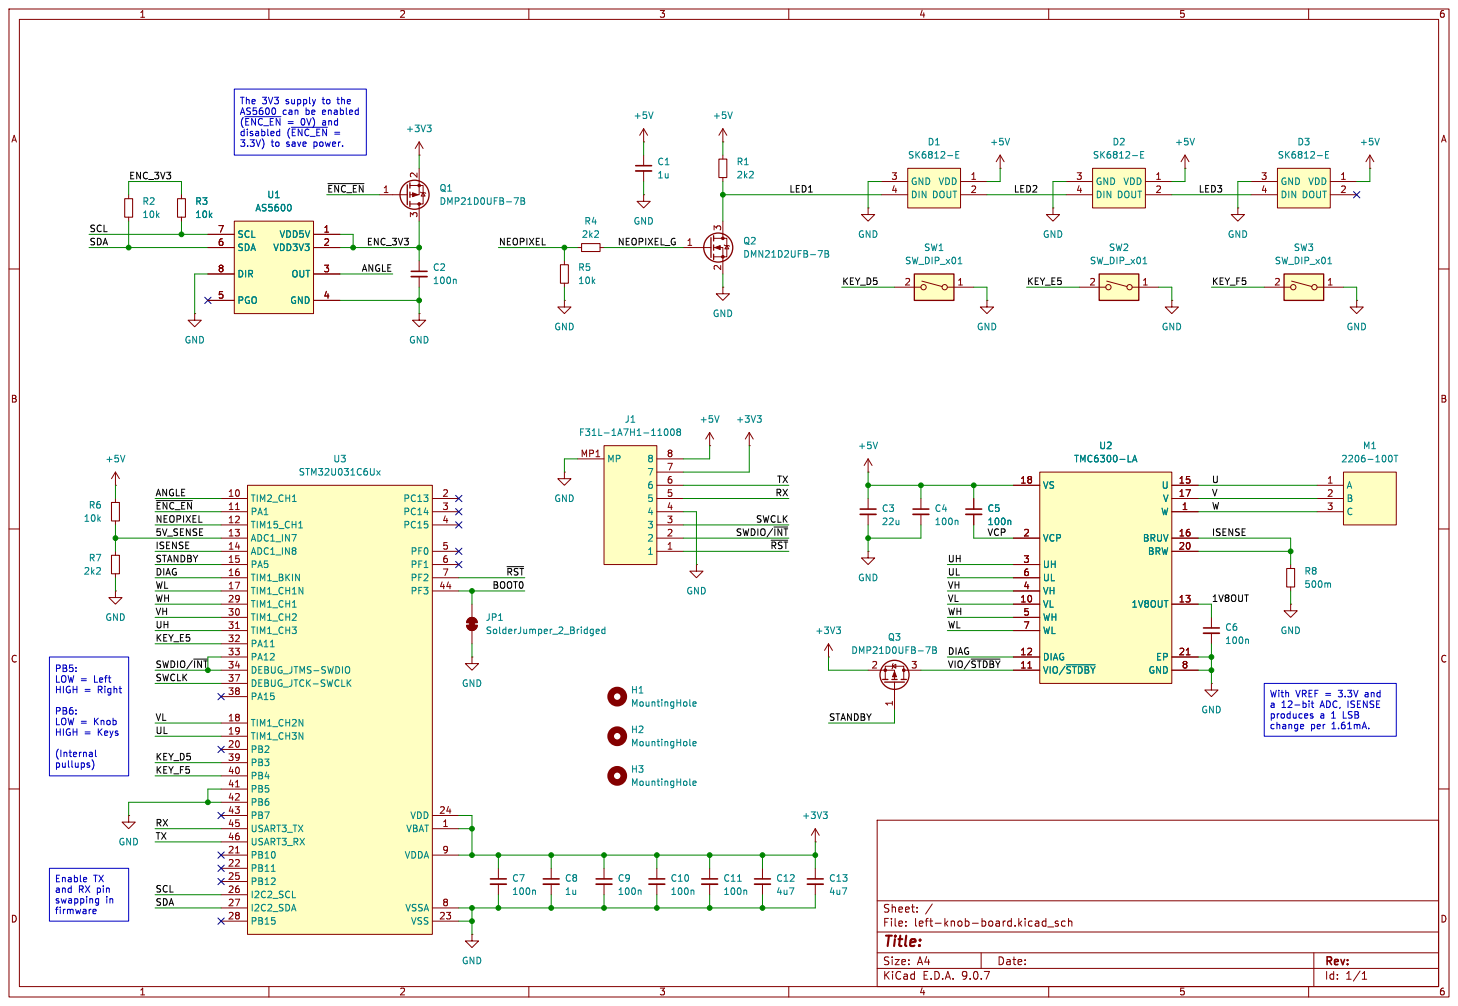
[picture p44: page 1]

1u +5V GND GND
+3V3 GND
3.3V) to save power. PB5: LOW = Left HIGH = Right PB6: LOW = Knob HIGH = Keys

The 3V3 supply to the AS5600 can be enabled

1V8OUT ANGLE WL STANDBY DIAG

5V_SENSE
~{RST} KEY_F5 KEY_D5 SWDIO/~{INT} UH
