ben5049/Keyboard/PCBs/keyboard-v3/right-control-board/right-control-board.pdf

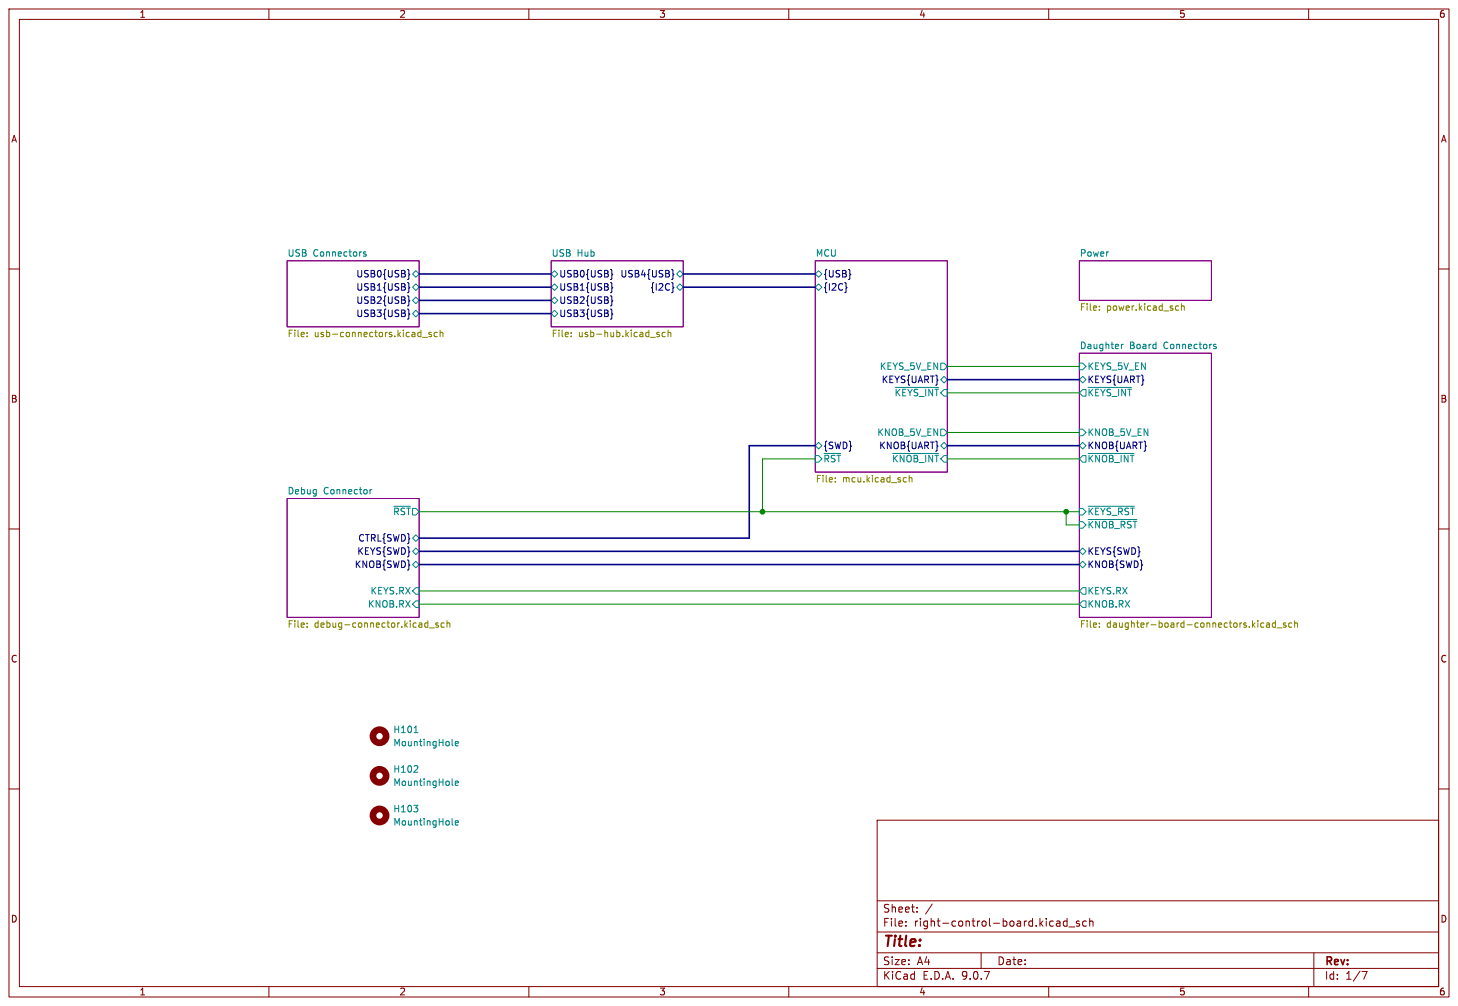
[picture p45: page 1]

{I2C} USB Hub File: usb-hub.kicad_sch USB0{USB}

KNOB.RX Daughter Board Connectors File: daughter-board-connectors.kicad_sch
~{KNOB_RST} KEYS_5V_EN
KEYS{UART}
~{KEYS_INT} KNOB_5V_EN
~{KNOB_INT} KEYS.RX

File: mcu.kicad_sch CTRL{SWD}

KNOB.RX Debug Connector File: debug-connector.kicad_sch

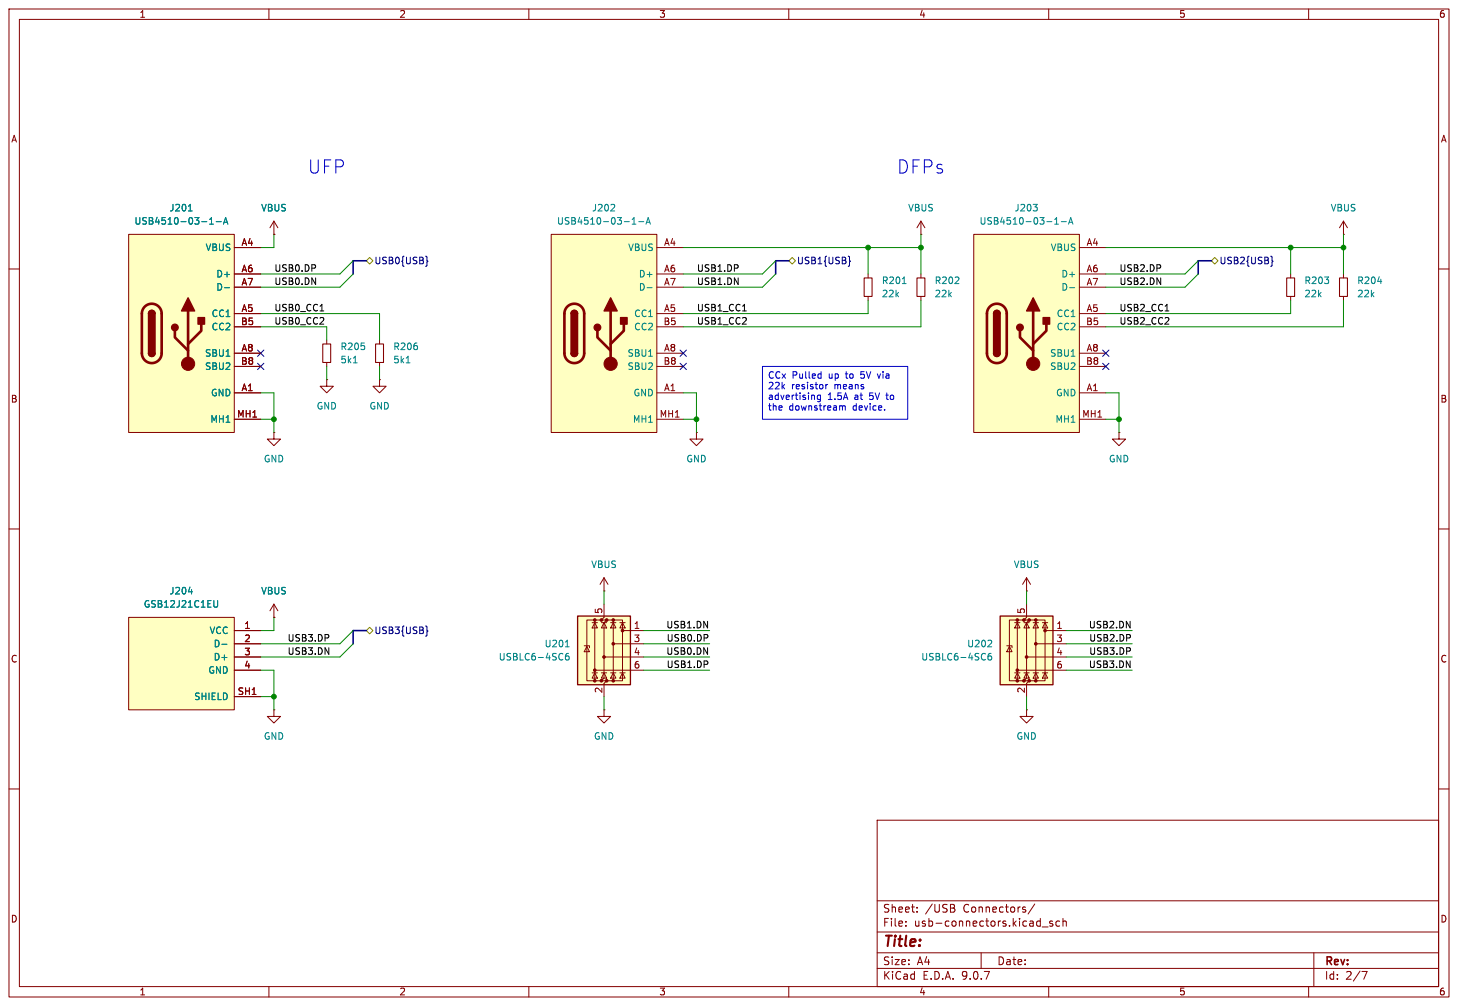
[picture p46: page 2]

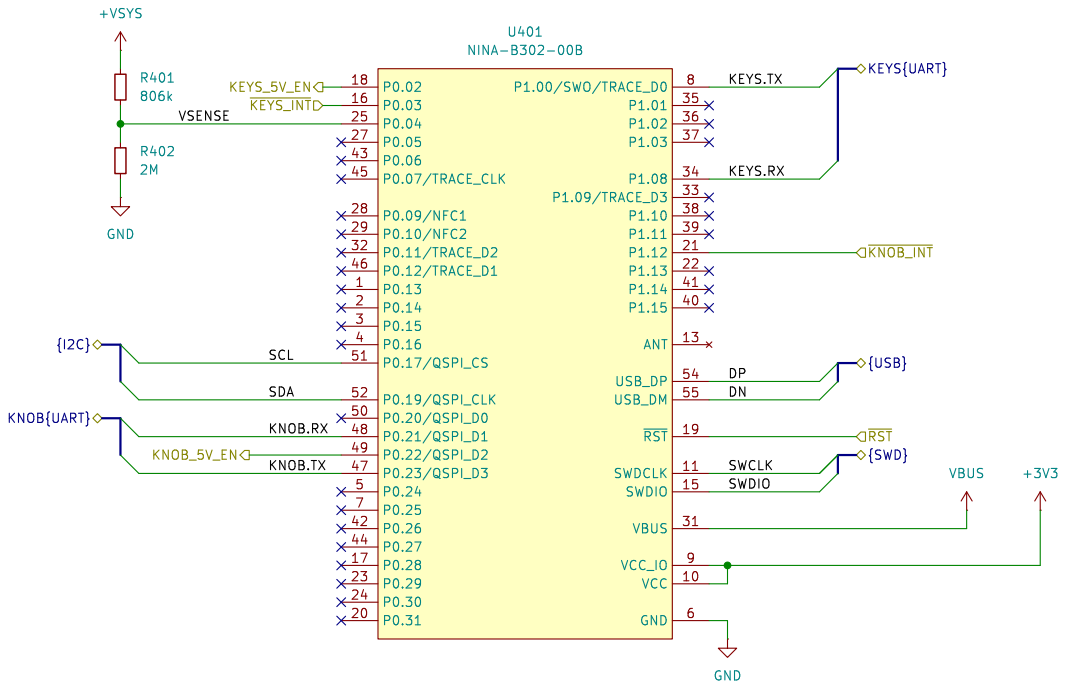
[picture p47: page 3]

Id: 4/7 Title: File: mcu.kicad_sch Sheet: /MCU/


5 7 | J501 Conn_02x08_Odd_Even GND | 6 8

CTRL.SWCLK

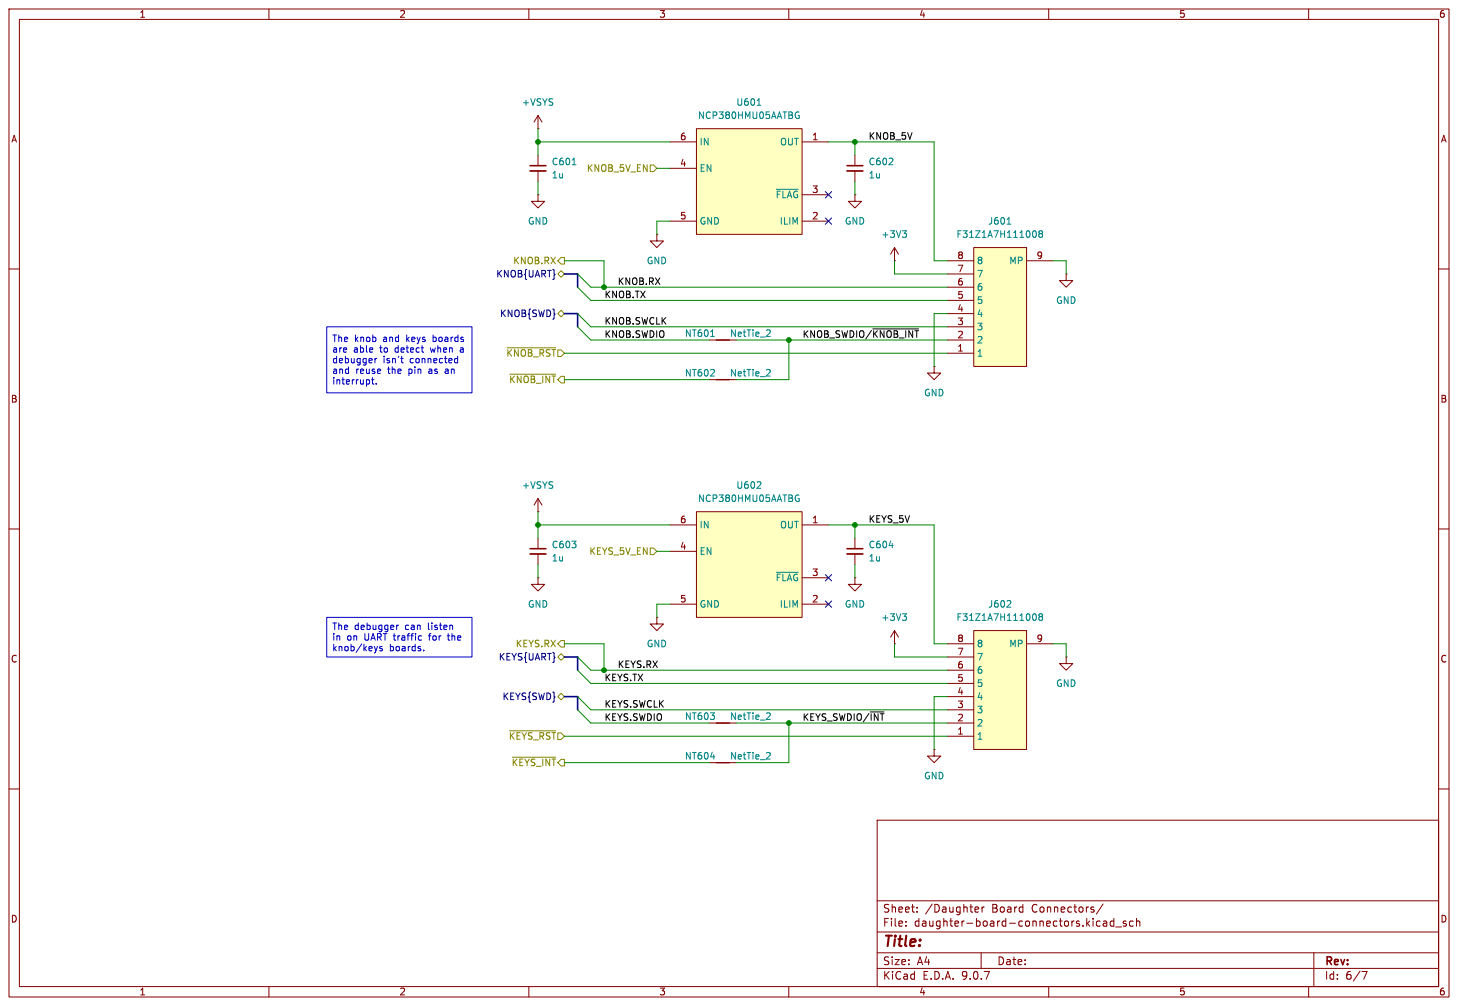
[picture p48: page 5]

interrupt. The debugger can listen

debugger isn't connected
and reuse the pin as an

KEYS{UART} KEYS.RX

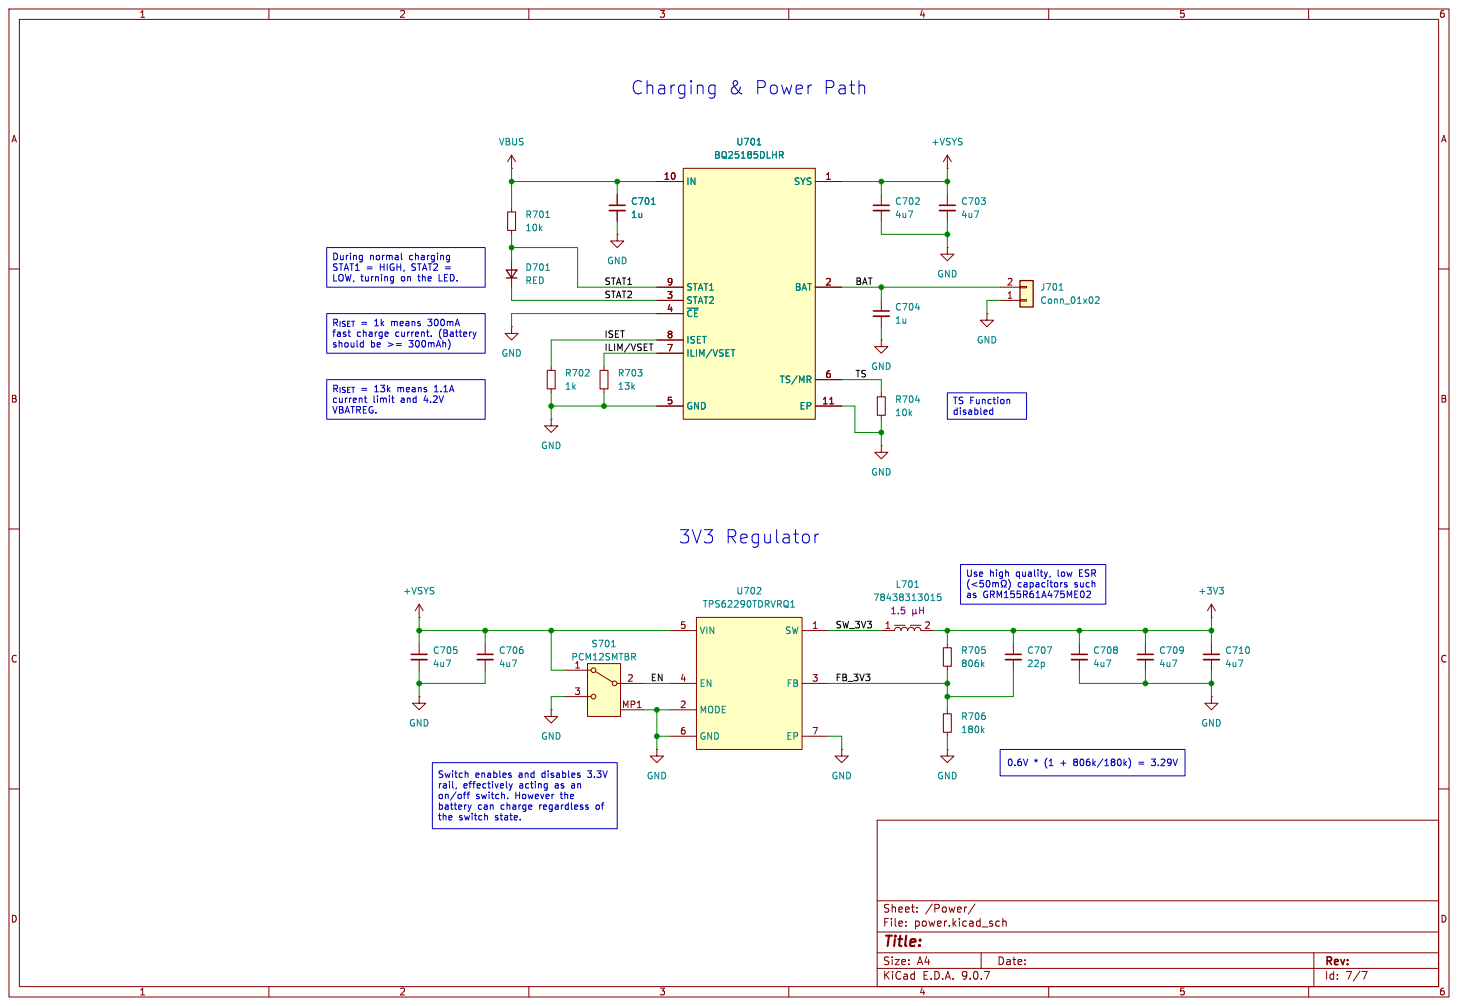
[picture p49: page 6]

During normal charging STAT1 = HIGH, STAT2 =

Id: 7/7 Title: File: power.kicad_sch Sheet: /Power/ GND

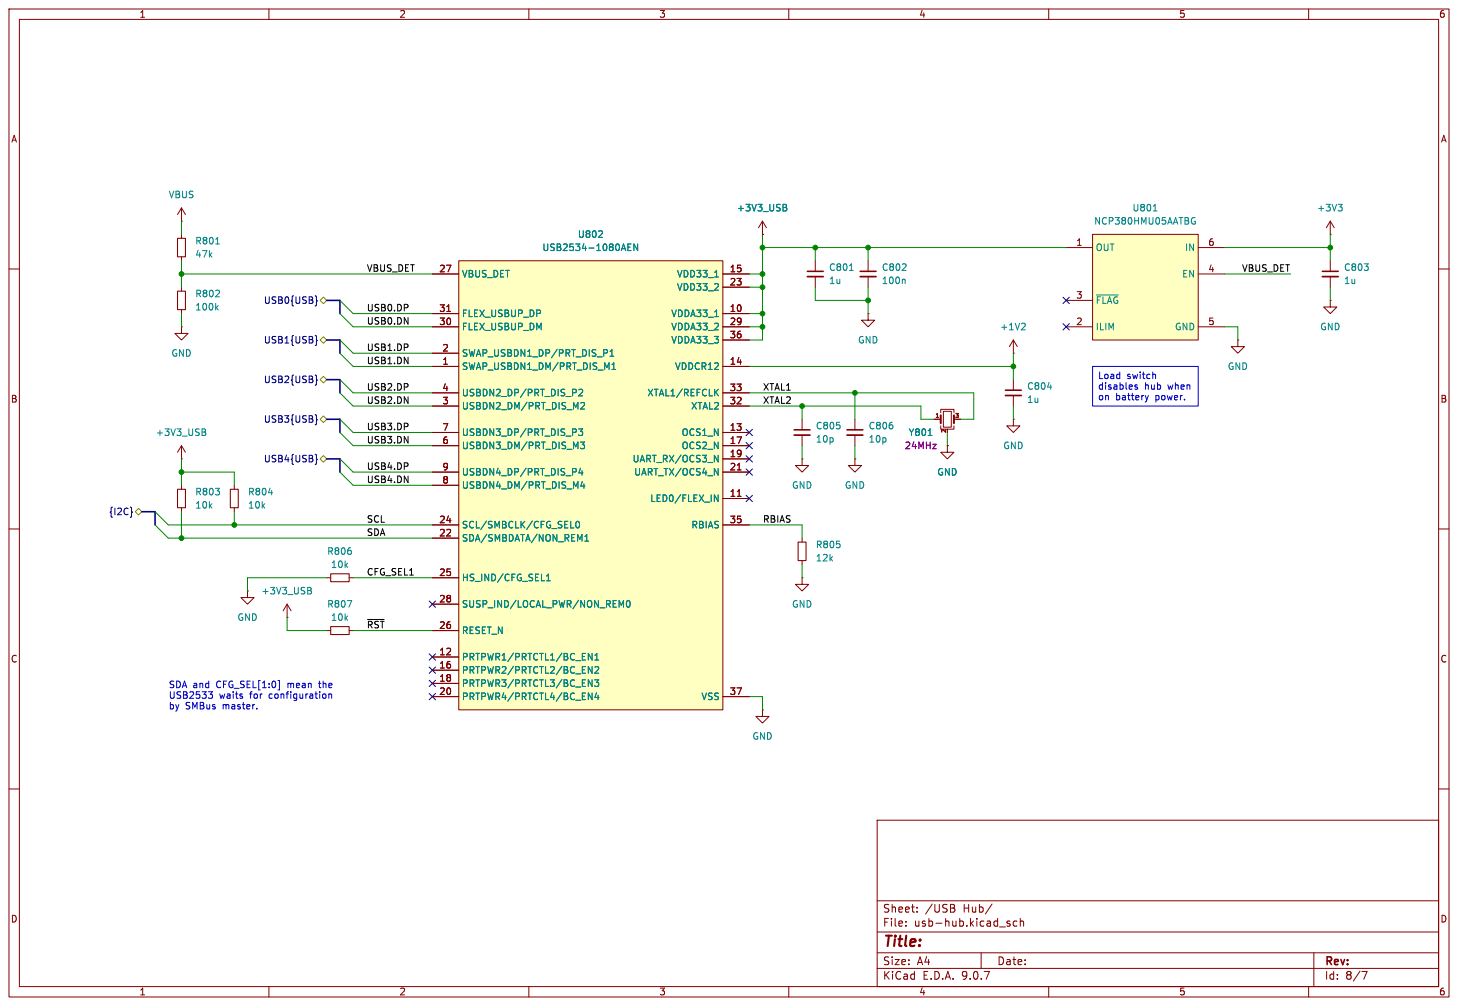
[picture p50: page 7]

on battery power. SDA and CFG_SEL[1:0] mean the USB2533 waits for configuration
