ben5049/Keyboard/PCBs/keyboard-v3/right-key-board/right-key-board.pdf

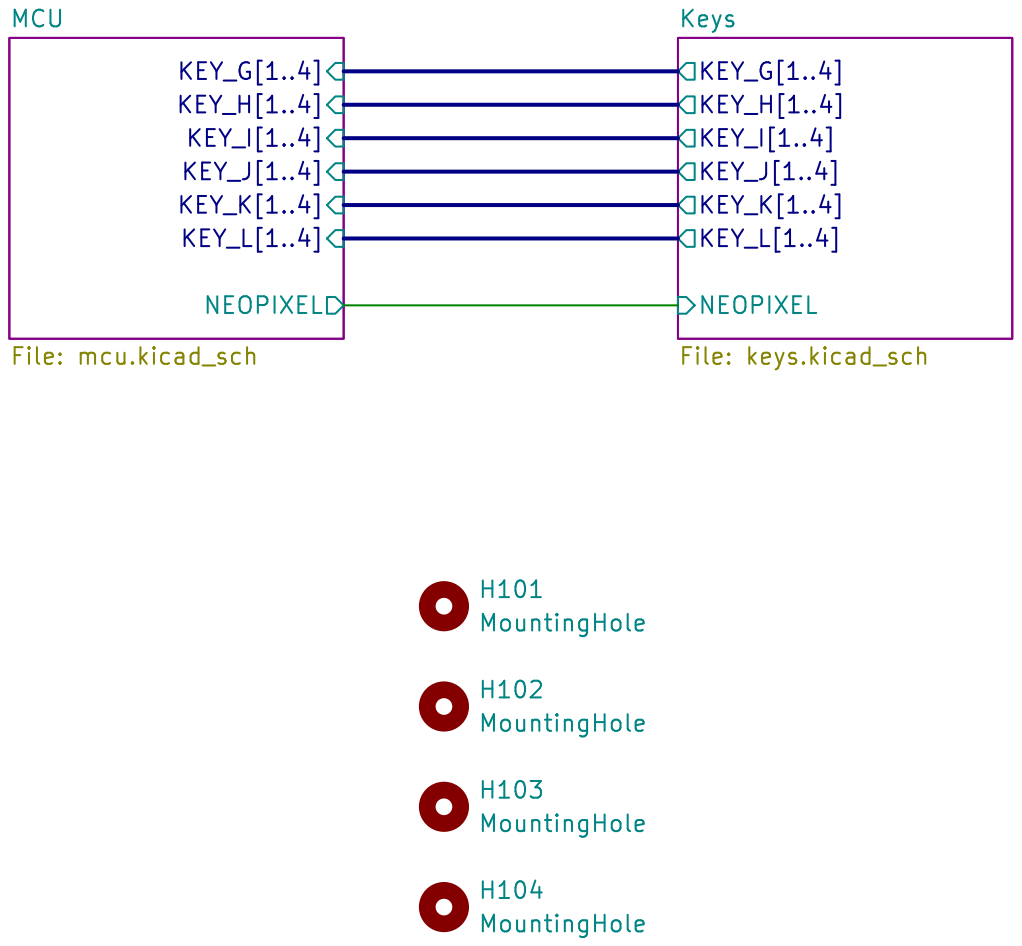
[picture p51: page 1]

KEY_L[1..4] NEOPIXEL Keys File: keys.kicad_sch H101 MountingHole H104 MountingHole H102 MountingHole H103 MountingHole

Id: 1/3 Title: File: right-key-board.kicad_sch Sheet: /

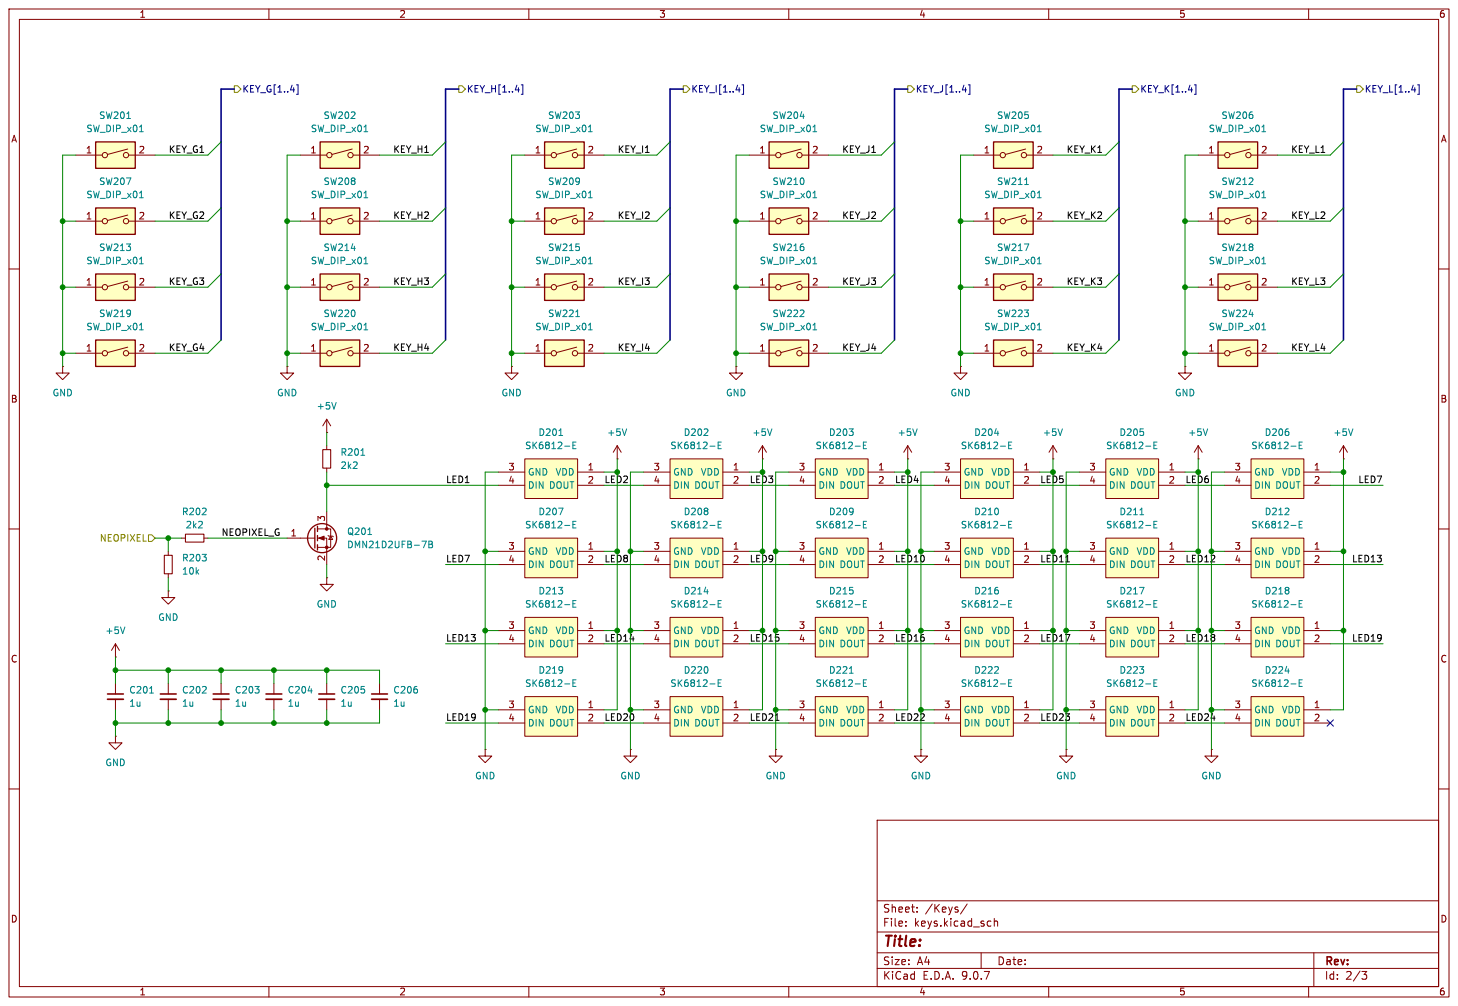
[picture p52: page 2]

Id: 2/3 Title: File: keys.kicad_sch Sheet: /Keys/

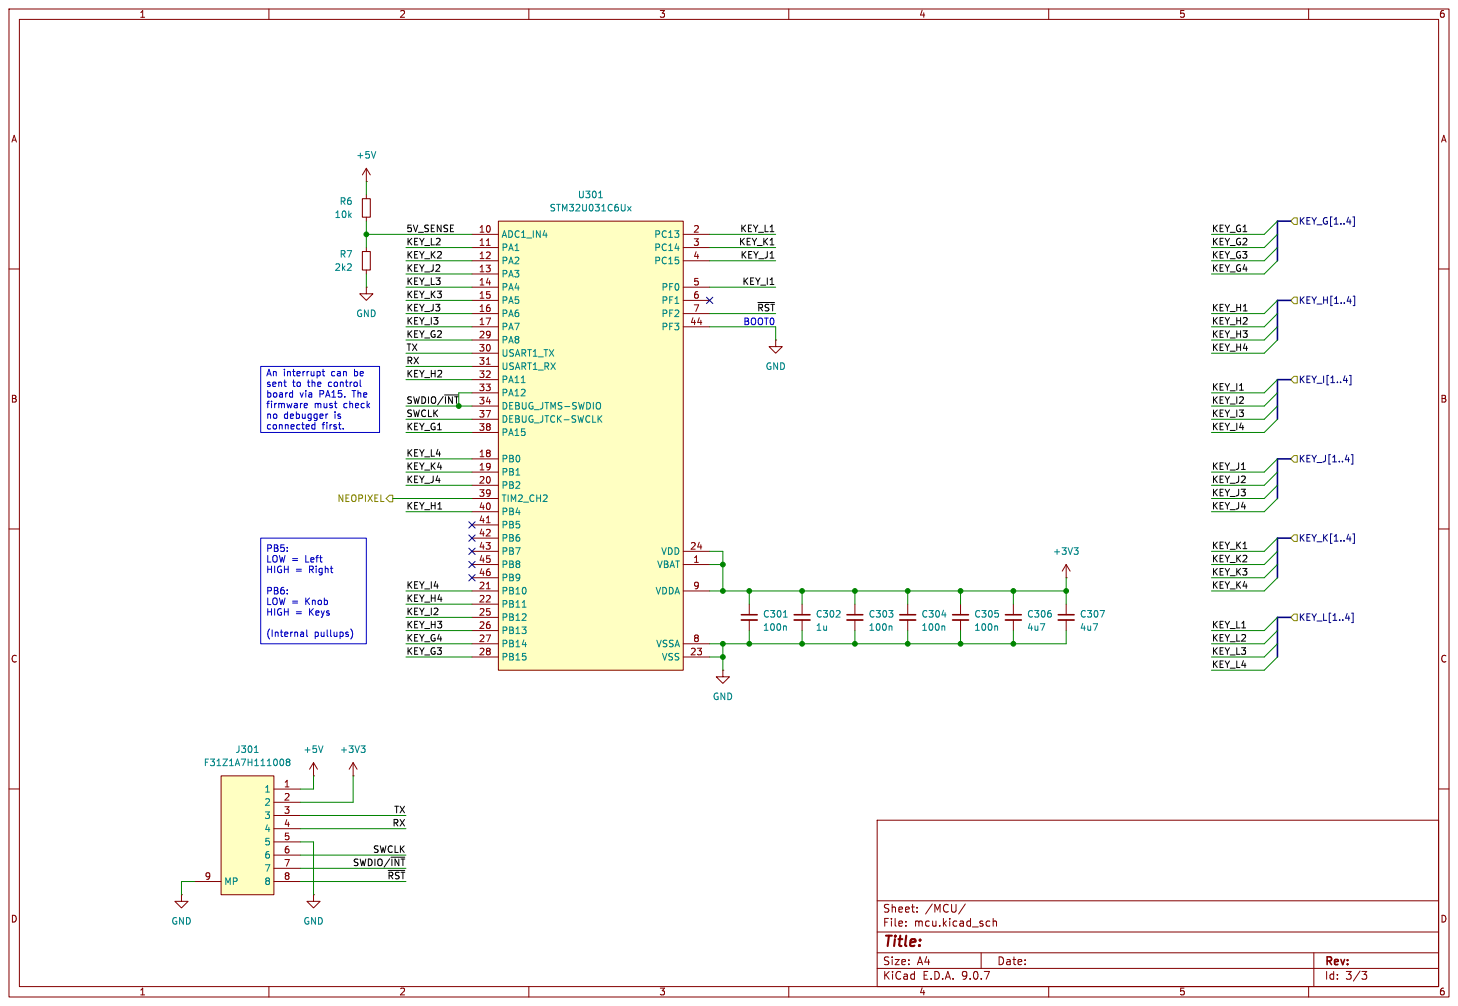
[picture p53: page 3]

sent to the control board via PA15. The

Id: 3/3 Title: File: mcu.kicad_sch Sheet: /MCU/ GND
