ben5049/Keyboard/PCBs/keyboard-v3/right-knob-board/right-knob-board.pdf

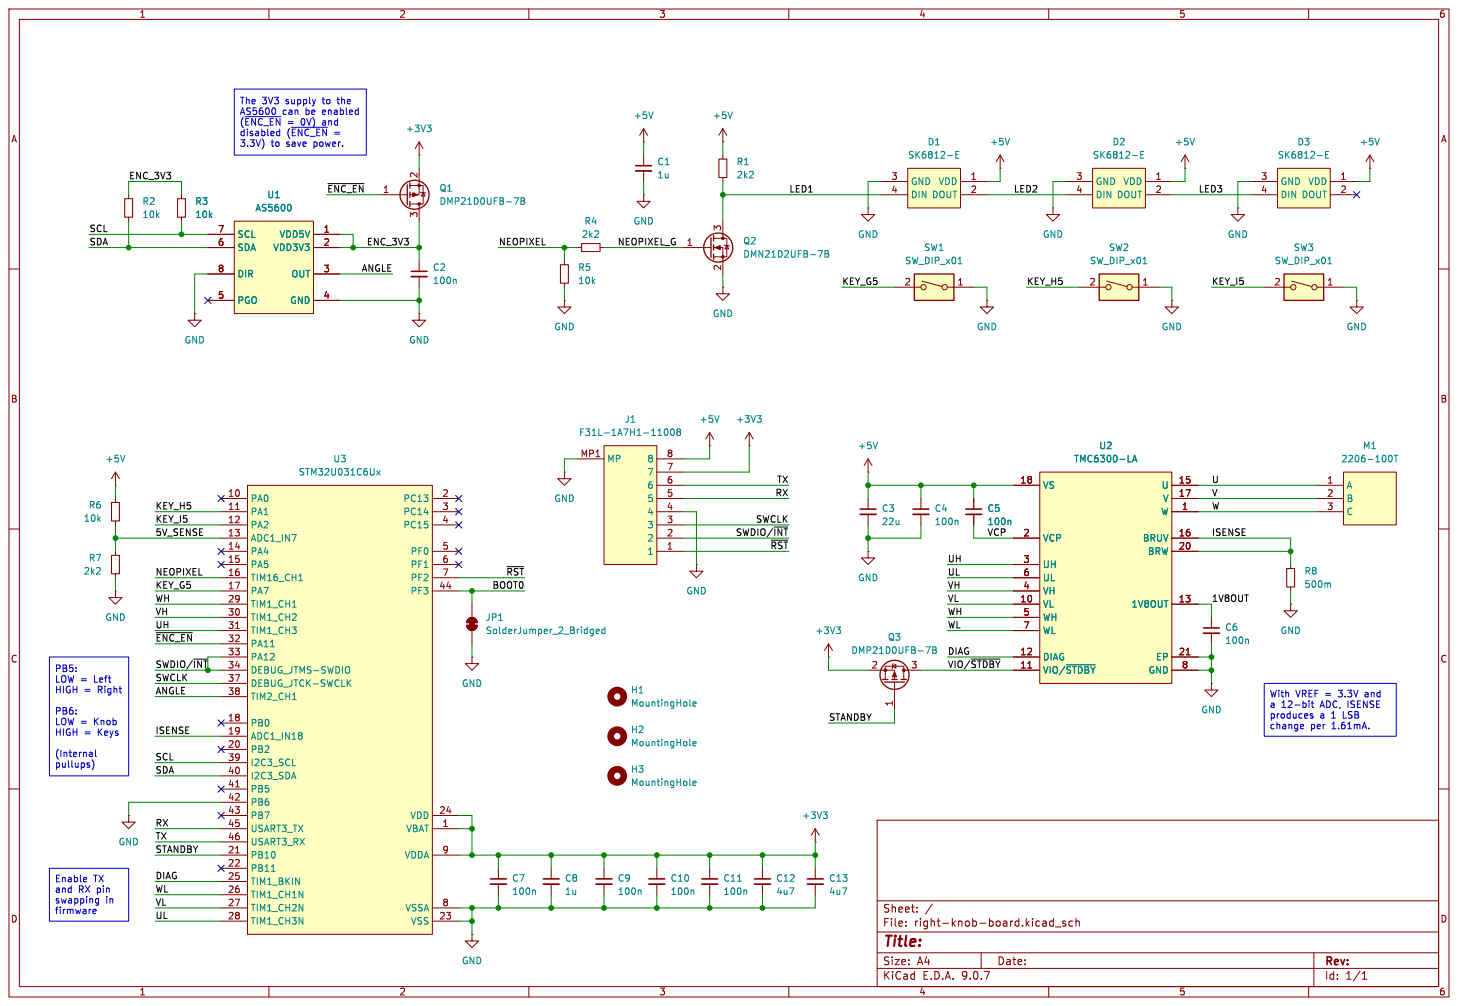
[picture p54: page 1]

3.3V) to save power. PB5: LOW = Left HIGH = Right PB6: LOW = Knob HIGH = Keys

The 3V3 supply to the AS5600 can be enabled

3 2 Q2 DMN21D2UFB-7B GND GND 3 DIN 4 VDD 1 DOUT 2 D1 SK6812-E GND
LED1 RX

ISENSE WL VIO/~{STDBY} VCP

Id: 1/1 Title: File: right-knob-board.kicad_sch Sheet: / 1

change per 1.61mA. Enable TX
