ben5049/Keyboard/PCBs/keyboard-v3/debug-breakout/debug-breakout.pdf

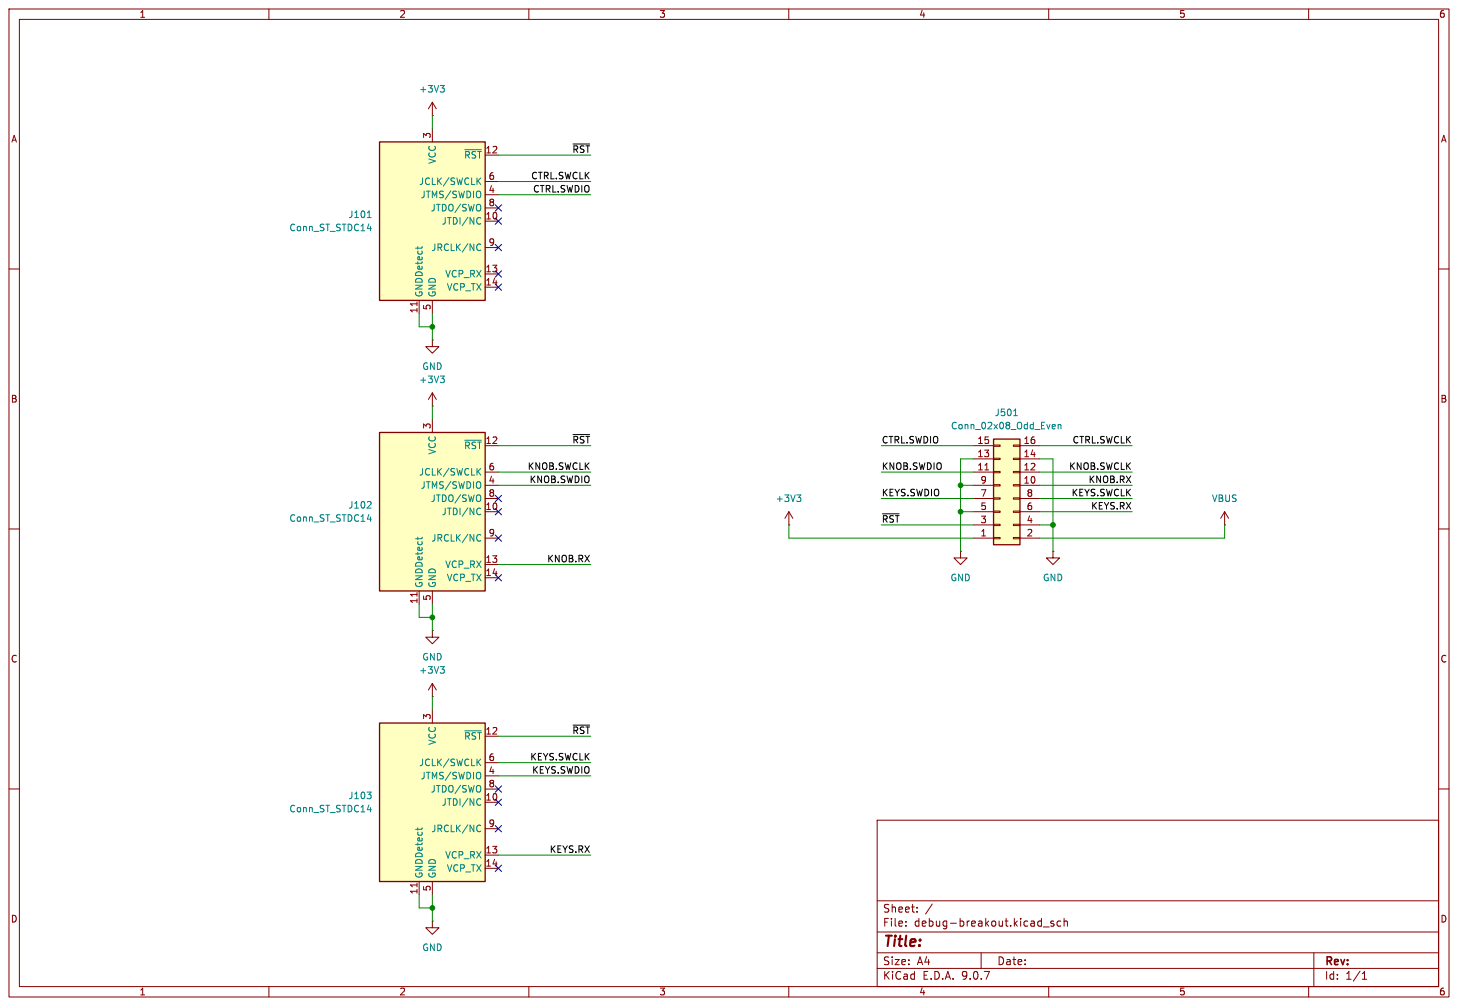
[picture p55: page 1]

KEYS.RX CTRL.SWDIO
