ben5049/Keyboard/PCBs/keyboard-v1/left_board/left_board.pdf

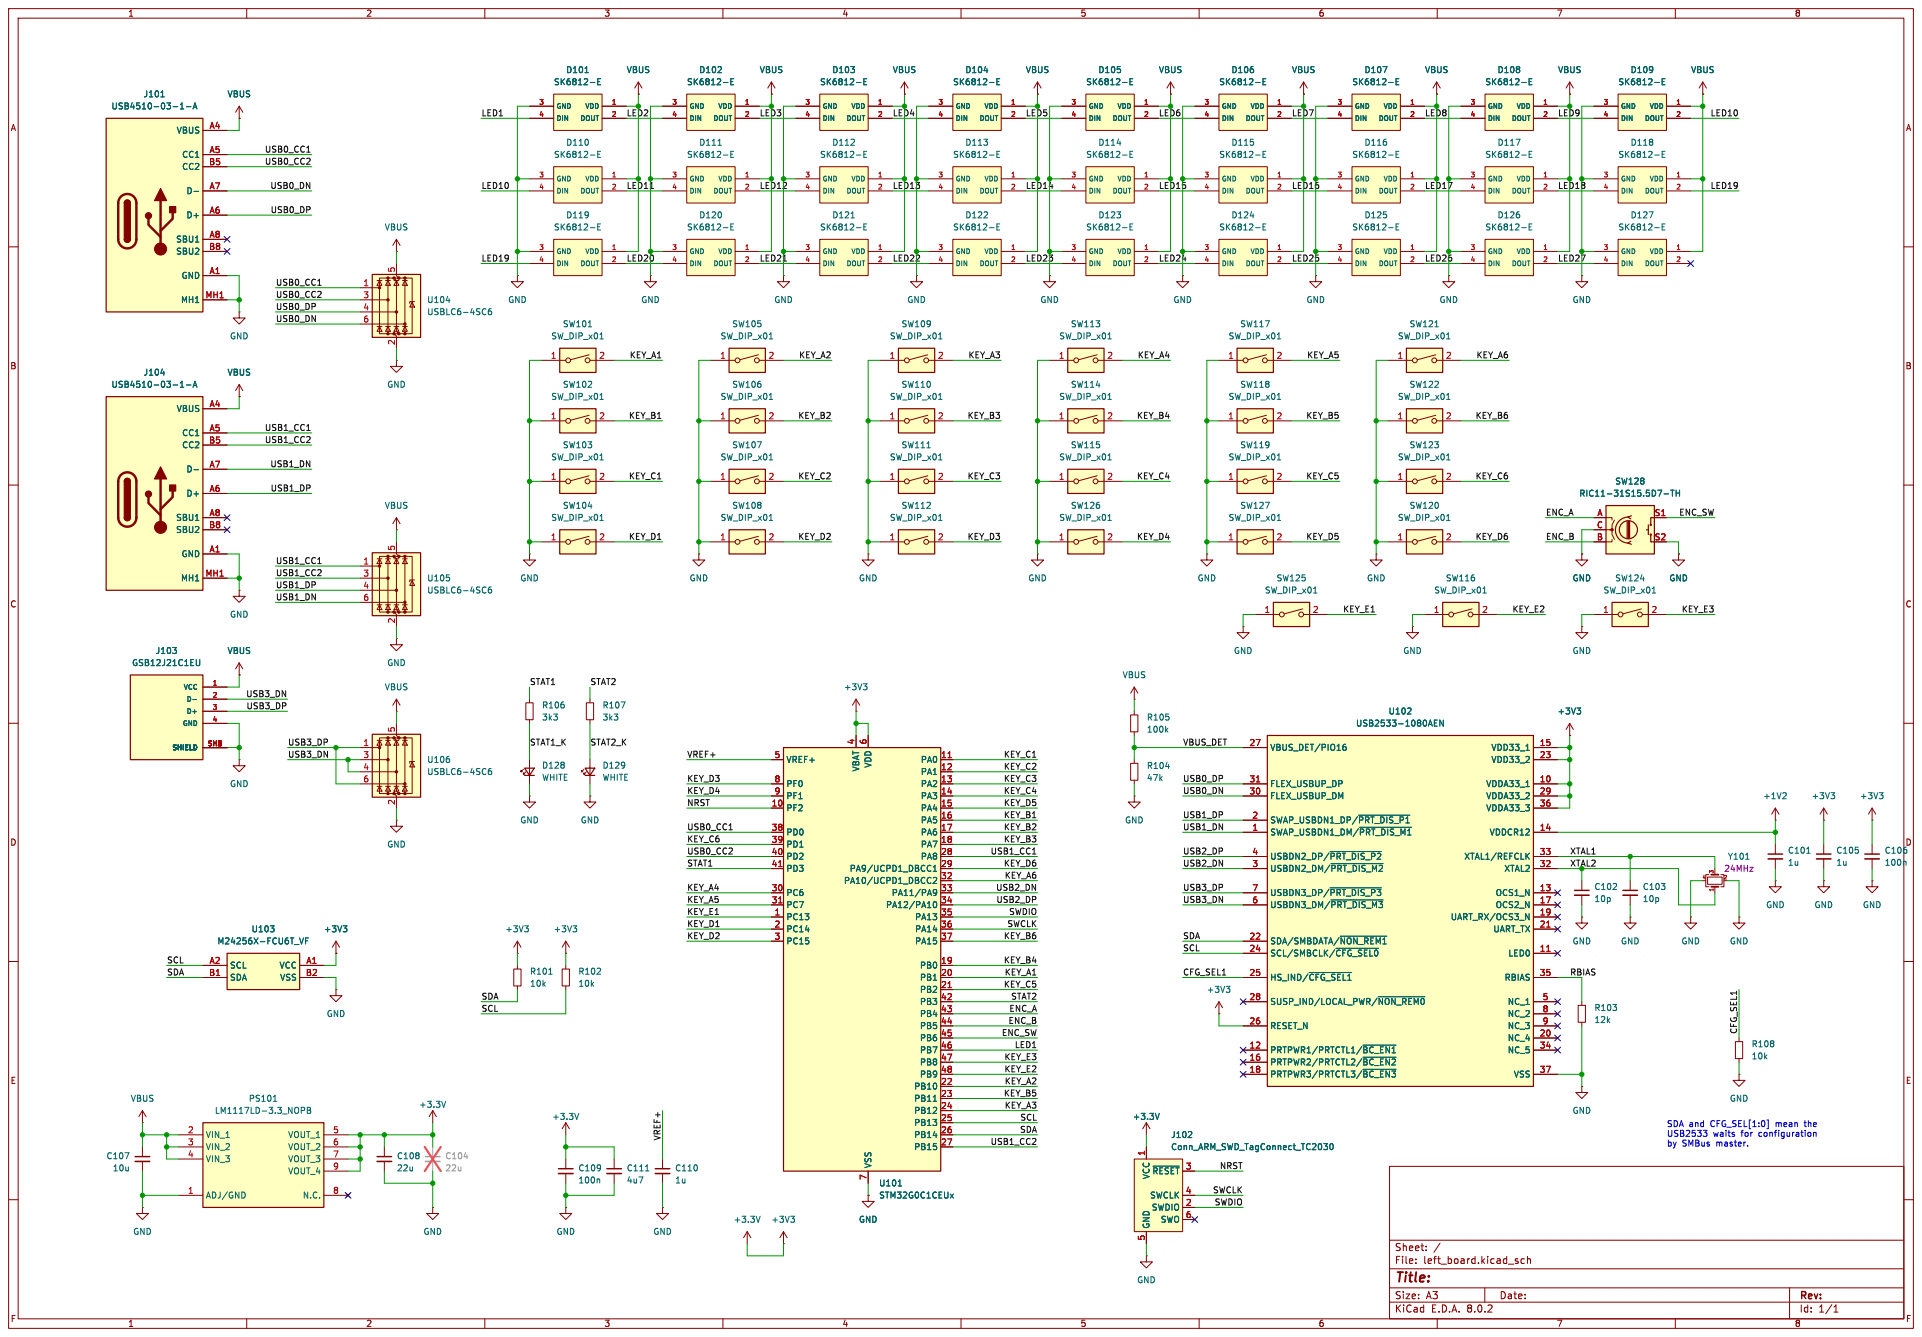
[picture p56: page 1]

SDA and CFG_SEL[1:0] mean the USB2533 waits for configuration

by SMBus master. Add LEDs on leftover pins

1 SWDIO 2 ~{RESET}3 SWCLK 4 GND
