ben5049/Keyboard/PCBs/keyboard-v1/right_board/right_board.pdf

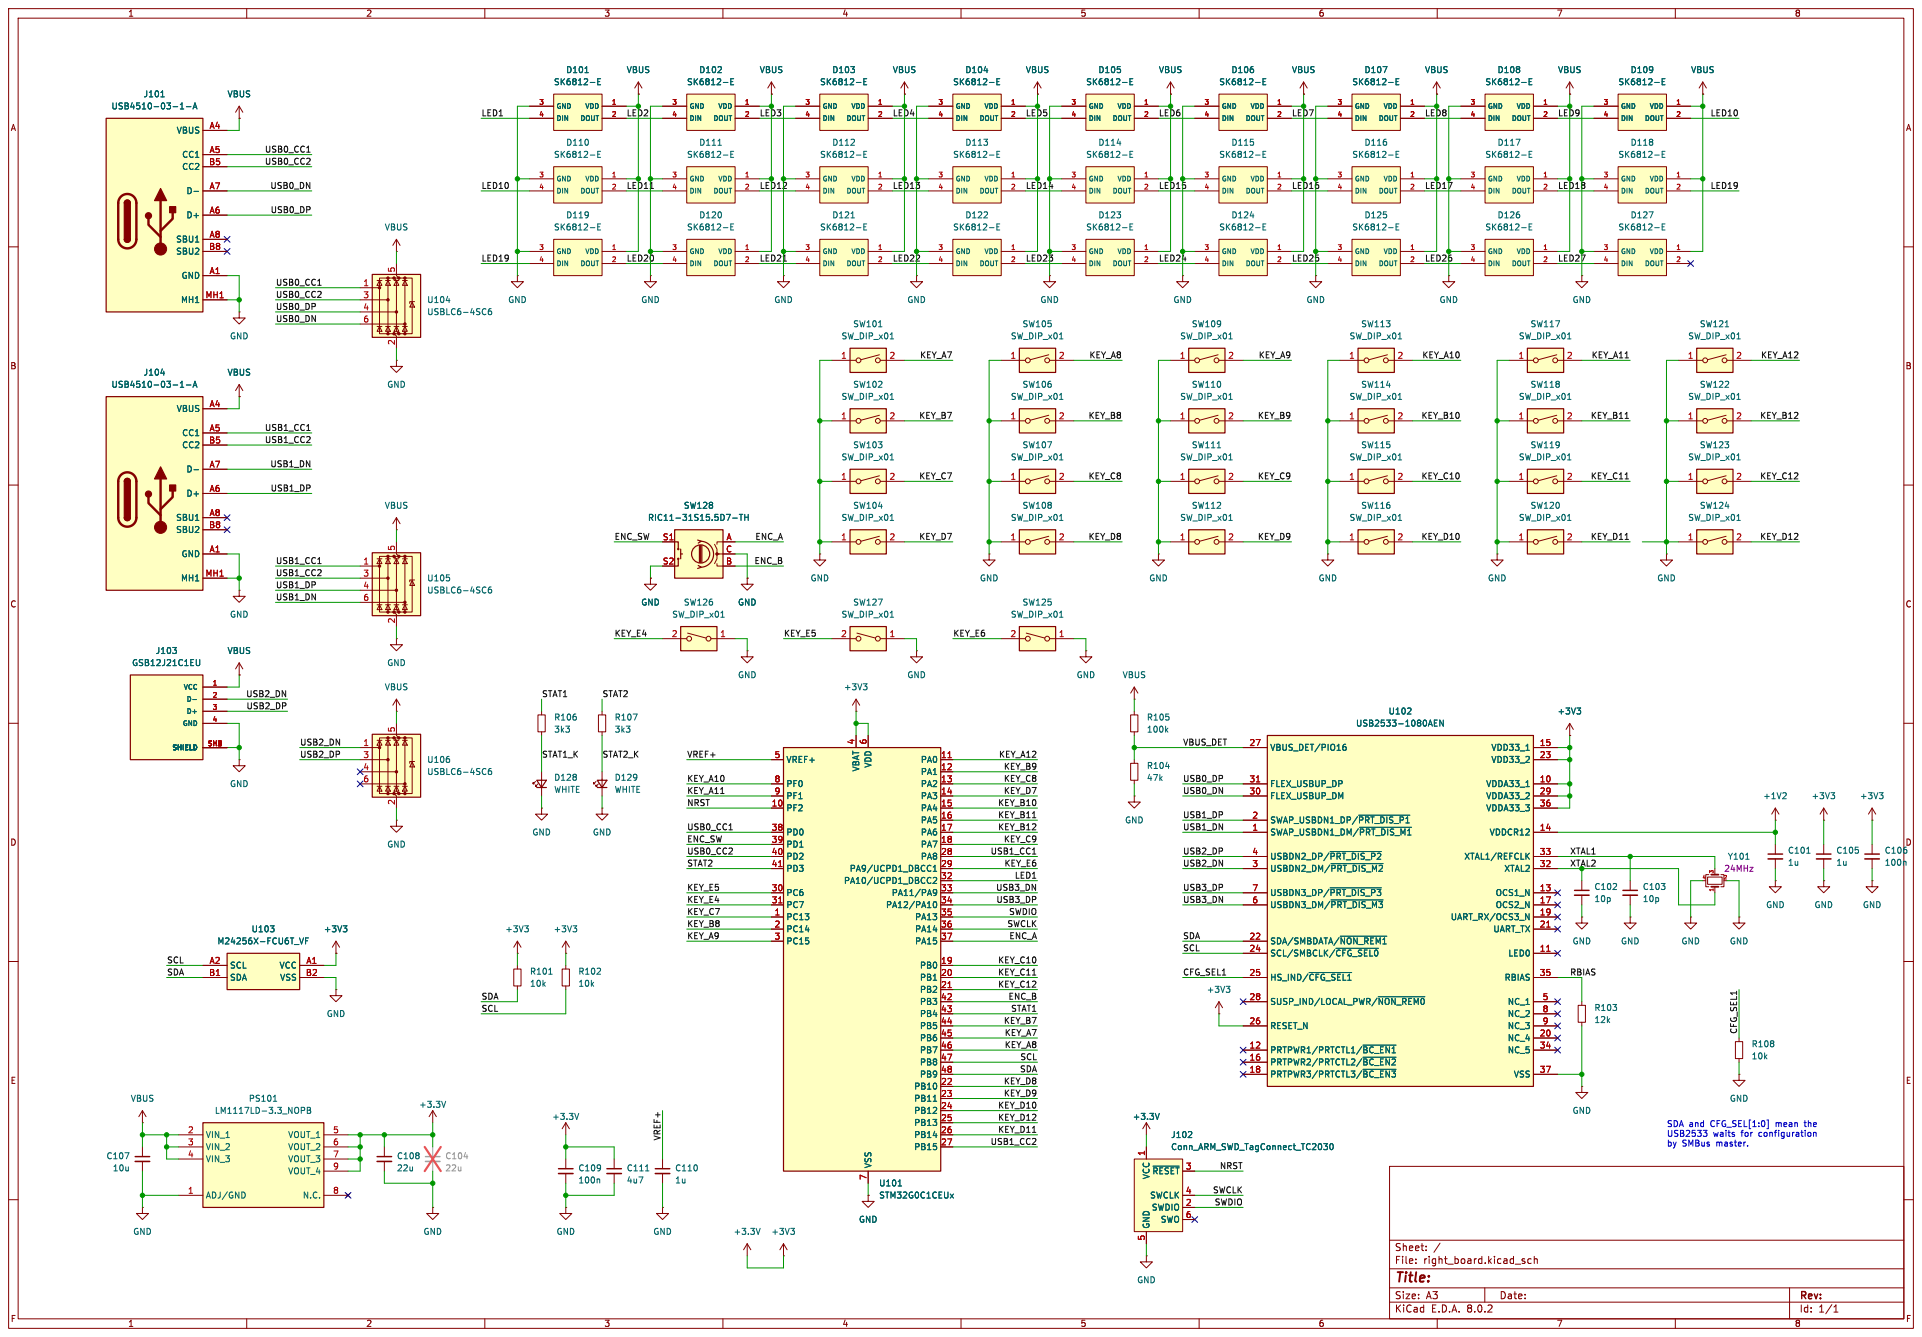
[picture p57: page 1]

VBUS
D128 WHITE GND GND GND

by SMBus master. Add LEDs on leftover pins

1 SWDIO 2 ~{RESET}3 SWCLK 4 GND

Id: 1/1 Title: File: right_board.kicad_sch Sheet: /
