ben5049/Keyboard/PCBs/keyboard-v3/left-control-board/left-control-board.kicad_pcb

## KiCad design PCBs/keyboard-v3/left-control-board/left-control-board.kicad_pcb (2026-03-15)

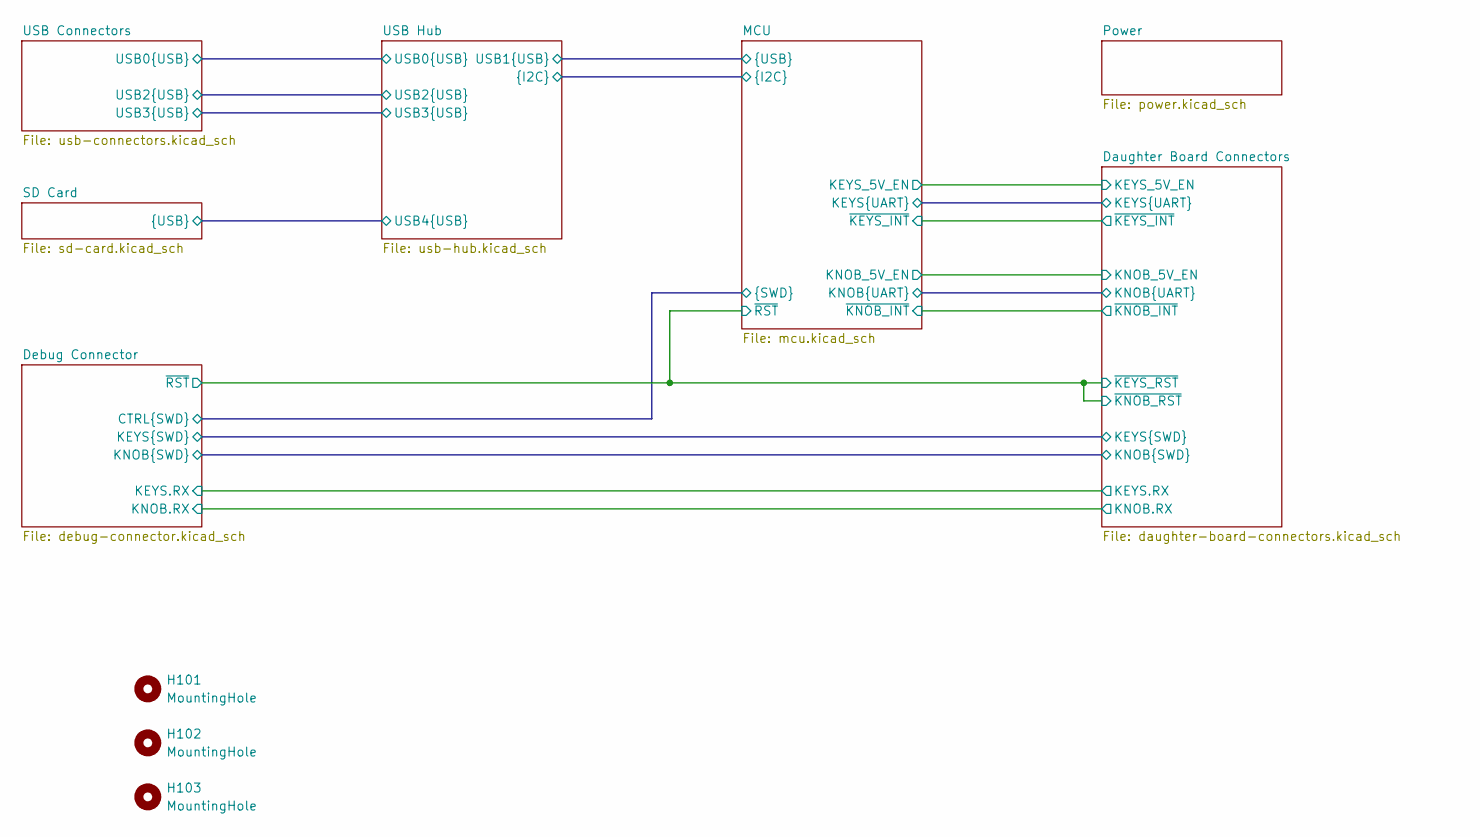
[picture p58: schematic left-control-board.kicad_sch]

Parts:
H101, H102, H103: MountingHole; MountingHole_2.2mm_M2

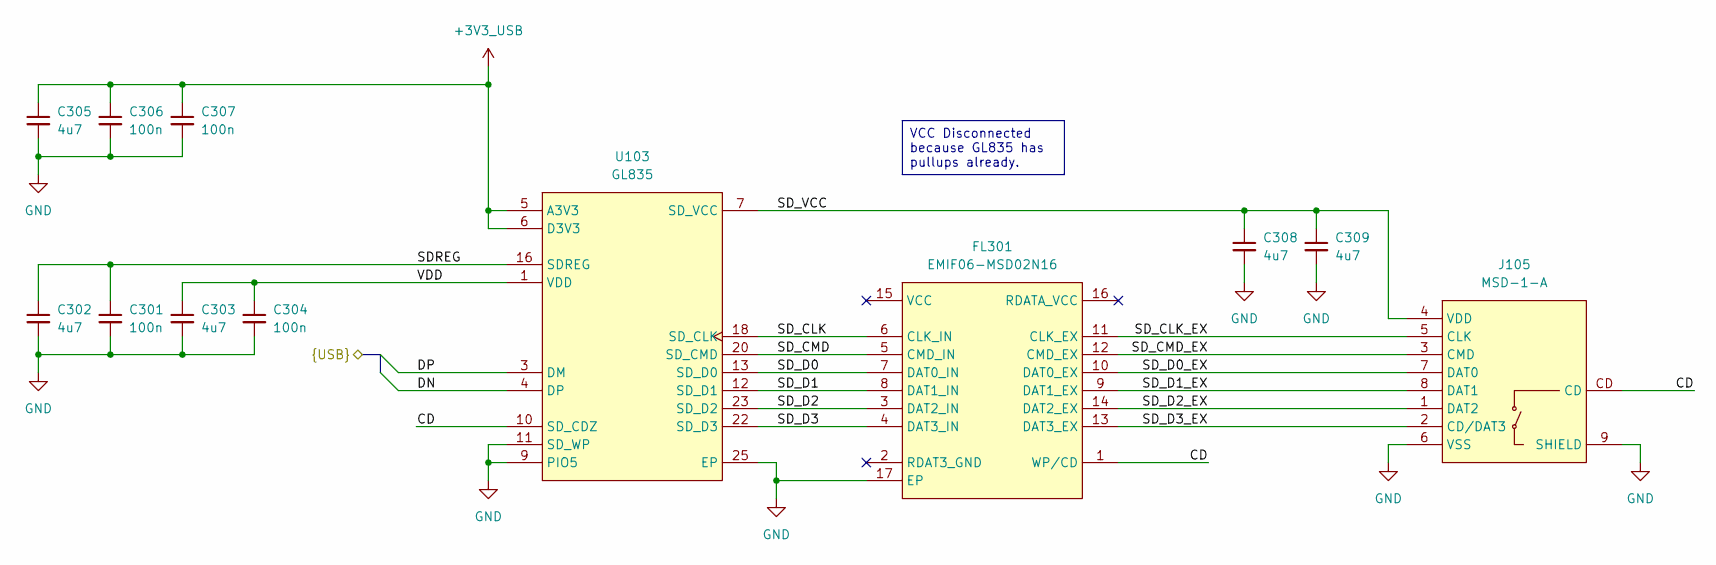
[picture p59: schematic sd-card.kicad_sch]

Parts:
C301, C304, C306, C307: 100n; C_0402
C302, C303, C305, C308, C309: 4u7; C_0402
FL301: EMIF06-MSD02N16; EMIF06MSD02N16
J105: MSD-1-A; MSD1A
U103: GL835; QFN50P400X400X100-25N-D

Connections:
+3V3_USB: C305.1, C306.1, C307.1, U103.5 (A3V3), U103.6 (D3V3); also elsewhere on the board
/SD Card/CD: FL301.1 (WP/CD), J105.CD, U103.10 (SD_CDZ)
/SD Card/DN: U103.4 (DP); also elsewhere on the board
/SD Card/DP: U103.3 (DM); also elsewhere on the board
/SD Card/SDREG: C301.1, C302.1, U103.16 (SDREG)
/SD Card/SD_CLK: FL301.6 (CLK_IN), U103.18 (SD_CLK)
/SD Card/SD_CLK_EX: FL301.11 (CLK_EX), J105.5 (CLK)
/SD Card/SD_CMD: FL301.5 (CMD_IN), U103.20 (SD_CMD)
/SD Card/SD_CMD_EX: FL301.12 (CMD_EX), J105.3 (CMD)
/SD Card/SD_D0: FL301.7 (DAT0_IN), U103.13 (SD_D0)
/SD Card/SD_D0_EX: FL301.10 (DAT0_EX), J105.7 (DAT0)
/SD Card/SD_D1: FL301.8 (DAT1_IN), U103.12 (SD_D1)
/SD Card/SD_D1_EX: FL301.9 (DAT1_EX), J105.8 (DAT1)
/SD Card/SD_D2: FL301.3 (DAT2_IN), U103.23 (SD_D2)
/SD Card/SD_D2_EX: FL301.14 (DAT2_EX), J105.1 (DAT2)
/SD Card/SD_D3: FL301.4 (DAT3_IN), U103.22 (SD_D3)
/SD Card/SD_D3_EX: FL301.13 (DAT3_EX), J105.2 (CD/DAT3)
/SD Card/SD_VCC: C308.1, C309.1, J105.4 (VDD), U103.7 (SD_VCC)
/SD Card/VDD: C303.1, C304.1, U103.1 (VDD)
GND: C301.2, C302.2, C303.2, C304.2, C305.2, C306.2, C307.2, C308.2, C309.2, FL301.17 (EP), J105.6 (VSS), J105.9 (SHIELD), J105.10 (SHIELD), J105.11 (SHIELD), J105.12 (SHIELD), U103.9 (PIO5), U103.11 (SD_WP), U103.25 (EP); also elsewhere on the board

Notes on the sheet:
VCC Disconnected because GL835 has pullups already.

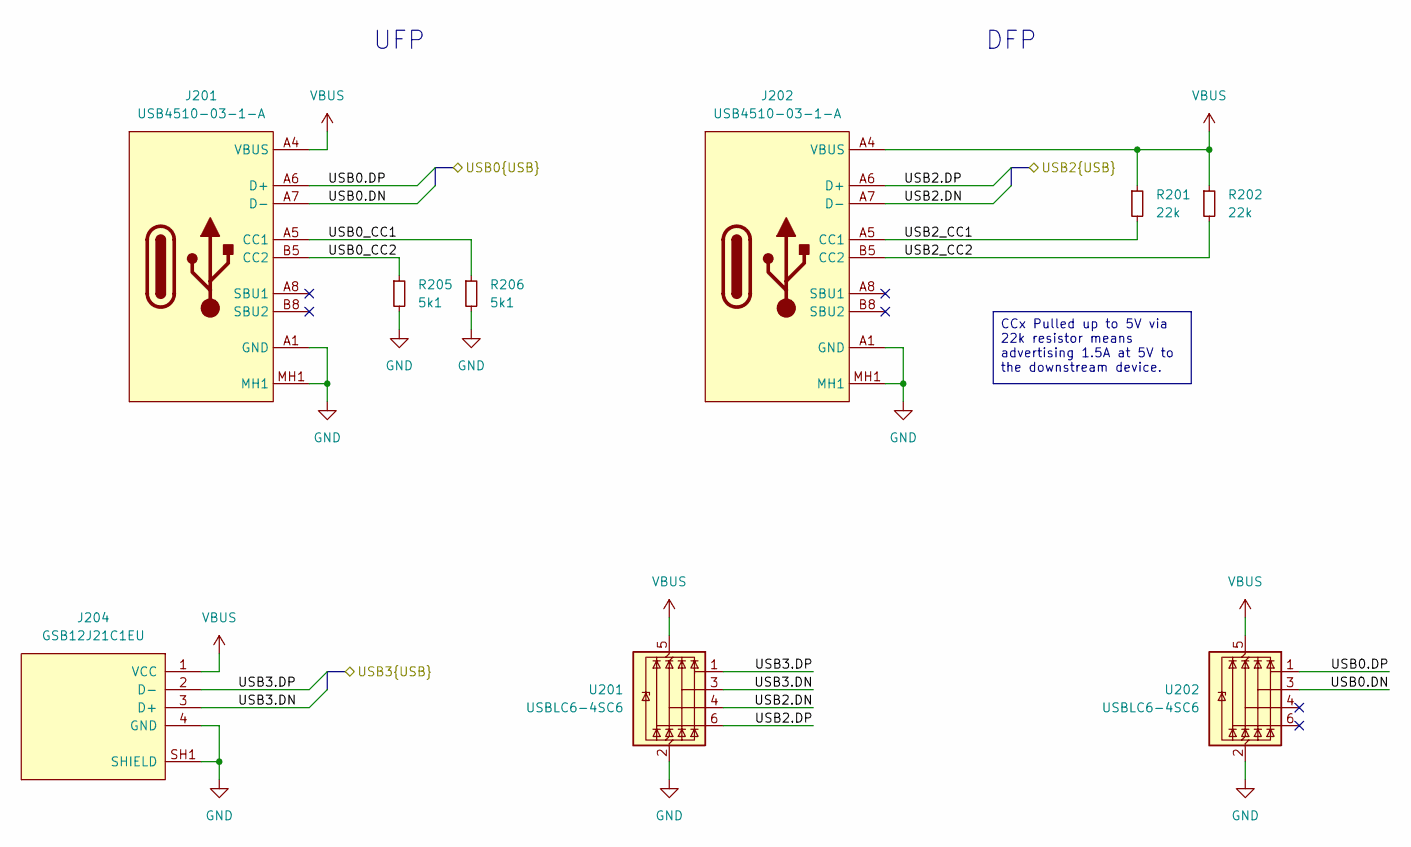
[picture p60: schematic usb-connectors.kicad_sch]

Parts:
J201, J202: USB4510-03-1-A; USB4510031A; Mouser Part Number 640-USB4510031A
J204: GSB12J21C1EU
R201, R202: 22k; R_0402
R205, R206: 5k1; R_0402
U201, U202: USBLC6-4SC6; SOT-23-6

Connections:
/USB Connectors/USB0.DN: J201.A7 (D-), J201.B7 (D-), U202.3 (I/O2); also elsewhere on the board
/USB Connectors/USB0.DP: J201.A6 (D+), J201.B6 (D+), U202.1 (I/O1); also elsewhere on the board
/USB Connectors/USB0_CC1: J201.A5 (CC1), R206.1
/USB Connectors/USB0_CC2: J201.B5 (CC2), R205.1
/USB Connectors/USB2.DN: J202.A7 (D-), J202.B7 (D-), U201.4 (I/O3); also elsewhere on the board
/USB Connectors/USB2.DP: J202.A6 (D+), J202.B6 (D+), U201.6 (I/O4); also elsewhere on the board
/USB Connectors/USB2_CC1: J202.A5 (CC1), R201.2
/USB Connectors/USB2_CC2: J202.B5 (CC2), R202.2
/USB Connectors/USB3.DN: J204.3 (D+), U201.3 (I/O2); also elsewhere on the board
/USB Connectors/USB3.DP: J204.2 (D-), U201.1 (I/O1); also elsewhere on the board
GND: J201.A1 (GND), J201.A12 (GND), J201.MH1, J201.MH2, J201.MH3, J201.MH4, J202.A1 (GND), J202.A12 (GND), J202.MH1, J202.MH2, J202.MH3, J202.MH4, J204.4 (GND), J204.SH1 (SHIELD), J204.SH2 (SHIELD), J204.SH3 (SHIELD), J204.SH4 (SHIELD), R205.2, R206.2, U201.2 (GND), U202.2 (GND); also elsewhere on the board
VBUS: J201.A4 (VBUS), J201.A9 (VBUS), J202.A4 (VBUS), J202.A9 (VBUS), J204.1 (VCC), R201.1, R202.1, U201.5 (VBUS), U202.5 (VBUS); also elsewhere on the board

Notes on the sheet:
UFP
DFP
CCx Pulled up to 5V via 22k resistor means advertising 1.5A at 5V to the downstream device.

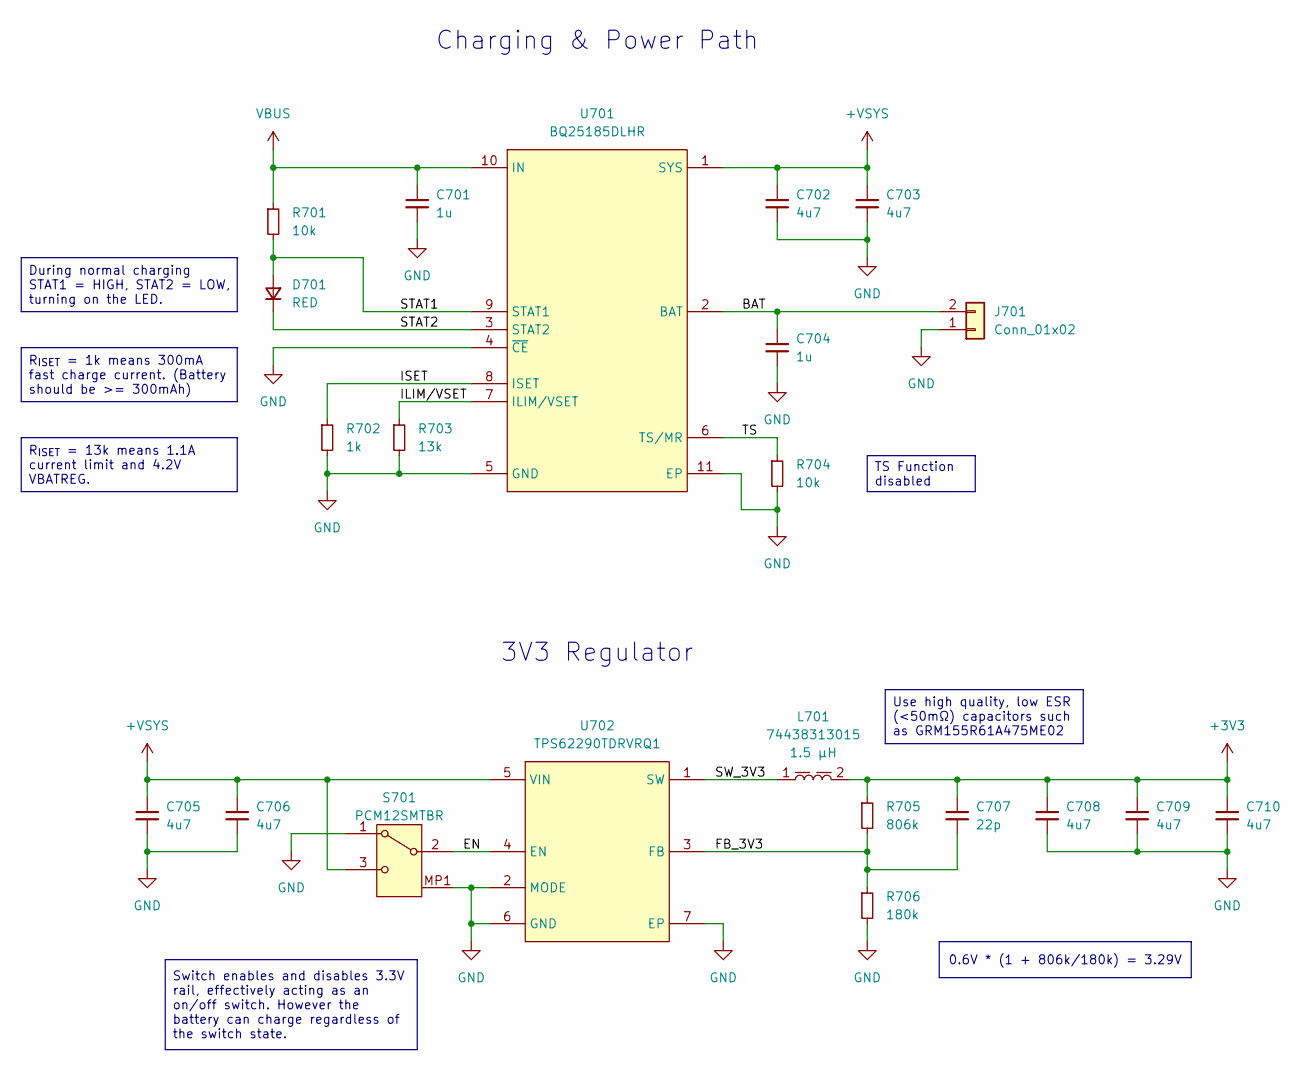
[picture p61: schematic power.kicad_sch]

Parts:
C701, C704: 1u; C_0402
C702, C703, C705, C706, C708, C709, C710: 4u7; C_0402
C707: 22p; C_0402
D701: RED; LED_0402
J701: Conn_01x02; JST_PH_S2B-PH-K_1x02_P2.00mm_Horizontal
L701: 74438313015; L_Wurth_WE-MAPI-1610; Part Number 74438313015
R701, R704: 10k; R_0402
R702: 1k; R_0402
R703: 13k; R_0402
R705: 806k; R_0402
R706: 180k; R_0402
S701: PCM12SMTBR
U701: BQ25185DLHR; SON40P220X200X80-11N
U702: TPS62290TDRVRQ1; SON65P200X200X80-7N; Mouser Part Number 595-TPS62290TDRVRQ1

Connections:
+3V3: C707.1, C708.1, C709.1, C710.1, L701.2, R705.1; also elsewhere on the board
+VSYS: C702.1, C703.1, C705.1, C706.1, S701.3 (NO), U701.1 (SYS), U702.5 (VIN); also elsewhere on the board
/Power/BAT: C704.1, J701.2, U701.2 (BAT)
/Power/EN: S701.2 (COM), U702.4 (EN)
/Power/FB_3V3: C707.2, R705.2, R706.1, U702.3 (FB)
/Power/ILIM/VSET: R703.1, U701.7 (ILIM/VSET)
/Power/ISET: R702.1, U701.8 (ISET)
/Power/STAT1: D701.2 (A), R701.2, U701.9 (STAT1)
/Power/STAT2: D701.1 (K), U701.3 (STAT2)
/Power/SW_3V3: L701.1, U702.1 (SW)
/Power/TS: R704.1, U701.6 (TS/MR)
GND: C701.2, C702.2, C703.2, C704.2, C705.2, C706.2, C708.2, C709.2, C710.2, J701.1, R702.2, R703.2, R704.2, R706.2, S701.1 (NC), S701.MP1, S701.MP2, S701.MP3, S701.MP4, U701.4 (~CE), U701.5 (GND), U701.11 (EP), U702.2 (MODE), U702.6 (GND), U702.7 (EP); also elsewhere on the board
VBUS: C701.1, R701.1, U701.10 (IN); also elsewhere on the board

Notes on the sheet:
3V3 Regulator
Charging & Power Path
Switch enables and disables 3.3V rail, effectively acting as an on/off switch. However the battery can charge regardless of the switch state.
0.6V * (1 + 806k/180k) = 3.29V
During normal charging STAT1 = HIGH, STAT2 = LOW, turning on the LED.
Use high quality, low ESR (<50mΩ) capacitors such as GRM155R61A475ME02
R_{ISET} = 1k means 300mA fast charge current. (Battery should be >= 300mAh)
R_{ISET} = 13k means 1.1A current limit and 4.2V VBATREG.
TS Function disabled

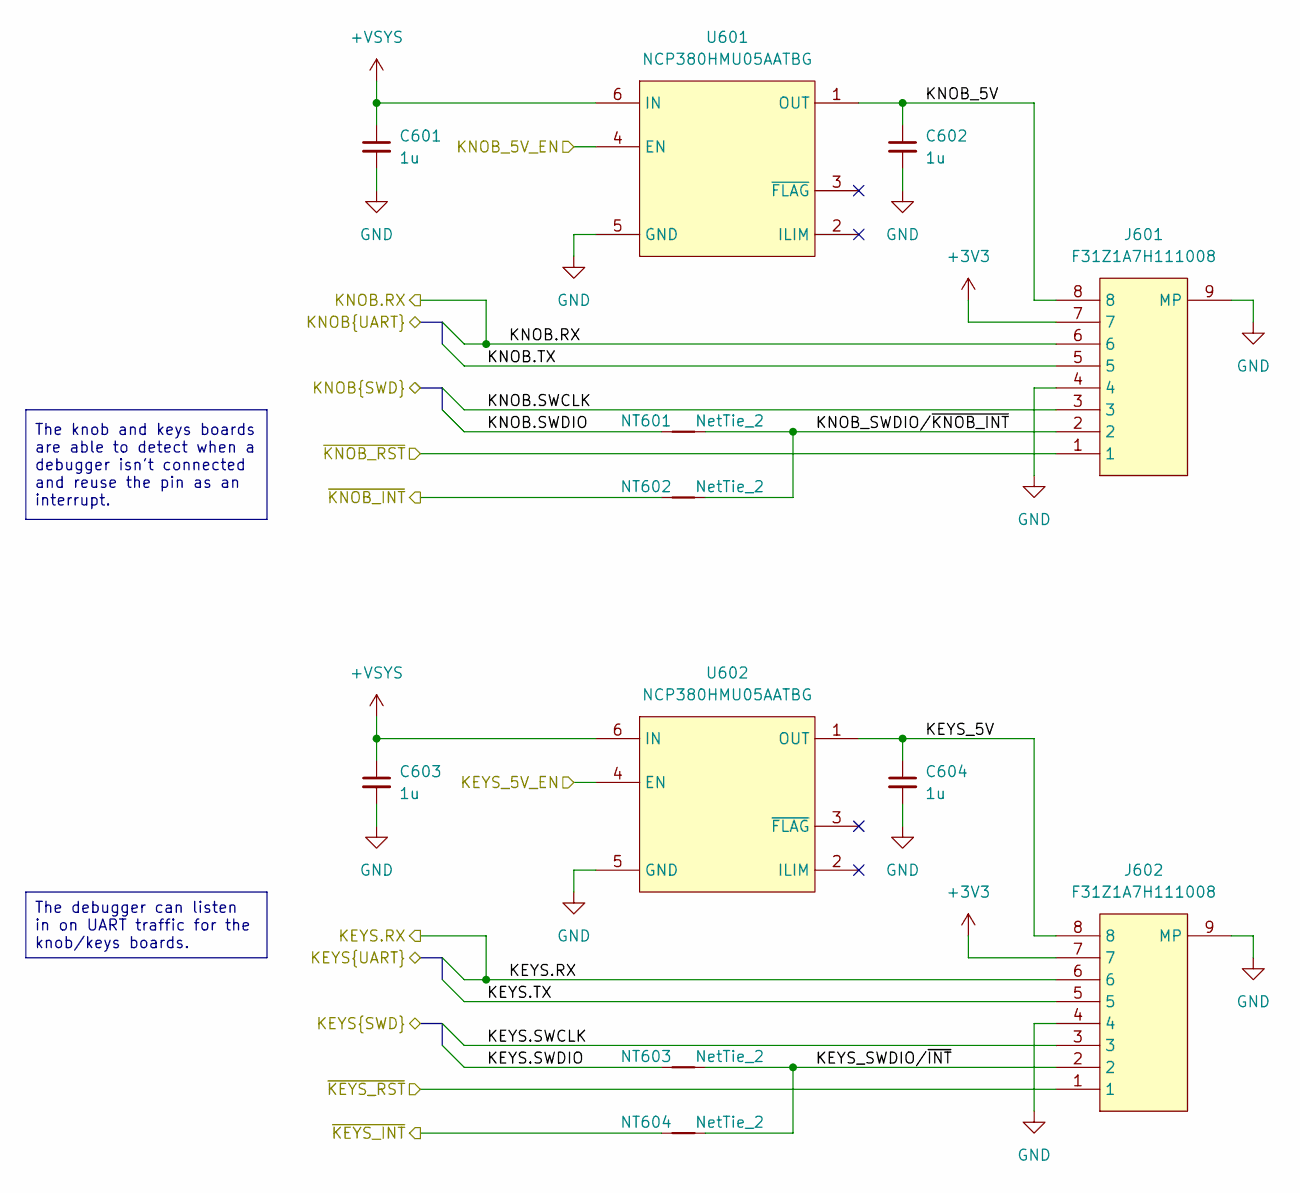
[picture p62: schematic daughter-board-connectors.kicad_sch]

Parts:
C601, C602, C603, C604: 1u; C_0402
J601, J602: F31Z1A7H111008
NT601, NT602, NT603, NT604: NetTie_2; NetTie-2_SMD_Pad0.15mm
U601, U602: NCP380HMU05AATBG; SON65P200X200X55-7N

Connections:
+3V3: J601.7, J602.7; also elsewhere on the board
+VSYS: C601.1, C603.1, U601.6 (IN), U602.6 (IN); also elsewhere on the board
/Daughter Board Connectors/KEYS.RX: J602.6; also elsewhere on the board
/Daughter Board Connectors/KEYS.SWCLK: J602.3; also elsewhere on the board
/Daughter Board Connectors/KEYS.SWDIO: NT603.1; also elsewhere on the board
/Daughter Board Connectors/KEYS.TX: J602.5; also elsewhere on the board
/Daughter Board Connectors/KEYS_5V: C604.1, J602.8, U602.1 (OUT)
/Daughter Board Connectors/KEYS_5V_EN: U602.4 (EN); also elsewhere on the board
/Daughter Board Connectors/KEYS_SWDIO/~INT: J602.2, NT603.2, NT604.2
/Daughter Board Connectors/KNOB.RX: J601.6; also elsewhere on the board
/Daughter Board Connectors/KNOB.SWCLK: J601.3; also elsewhere on the board
/Daughter Board Connectors/KNOB.SWDIO: NT601.1; also elsewhere on the board
/Daughter Board Connectors/KNOB.TX: J601.5; also elsewhere on the board
/Daughter Board Connectors/KNOB_5V: C602.1, J601.8, U601.1 (OUT)
/Daughter Board Connectors/KNOB_5V_EN: U601.4 (EN); also elsewhere on the board
/Daughter Board Connectors/KNOB_SWDIO/~KNOB_INT: J601.2, NT601.2, NT602.2
/Daughter Board Connectors/~KEYS_INT: NT604.1; also elsewhere on the board
/Daughter Board Connectors/~KEYS_RST: J601.1, J602.1; also elsewhere on the board
/Daughter Board Connectors/~KNOB_INT: NT602.1; also elsewhere on the board
GND: C601.2, C602.2, C603.2, C604.2, J601.4, J601.9 (MP), J601.10 (MP), J601.11 (MP), J601.12 (MP), J602.4, J602.9 (MP), J602.10 (MP), J602.11 (MP), J602.12 (MP), U601.5 (GND), U601.7 (GND), U602.5 (GND), U602.7 (GND); also elsewhere on the board

Notes on the sheet:
The debugger can listen in on UART traffic for the knob/keys boards.
The knob and keys boards are able to detect when a debugger isn't connected and reuse the pin as an interrupt.

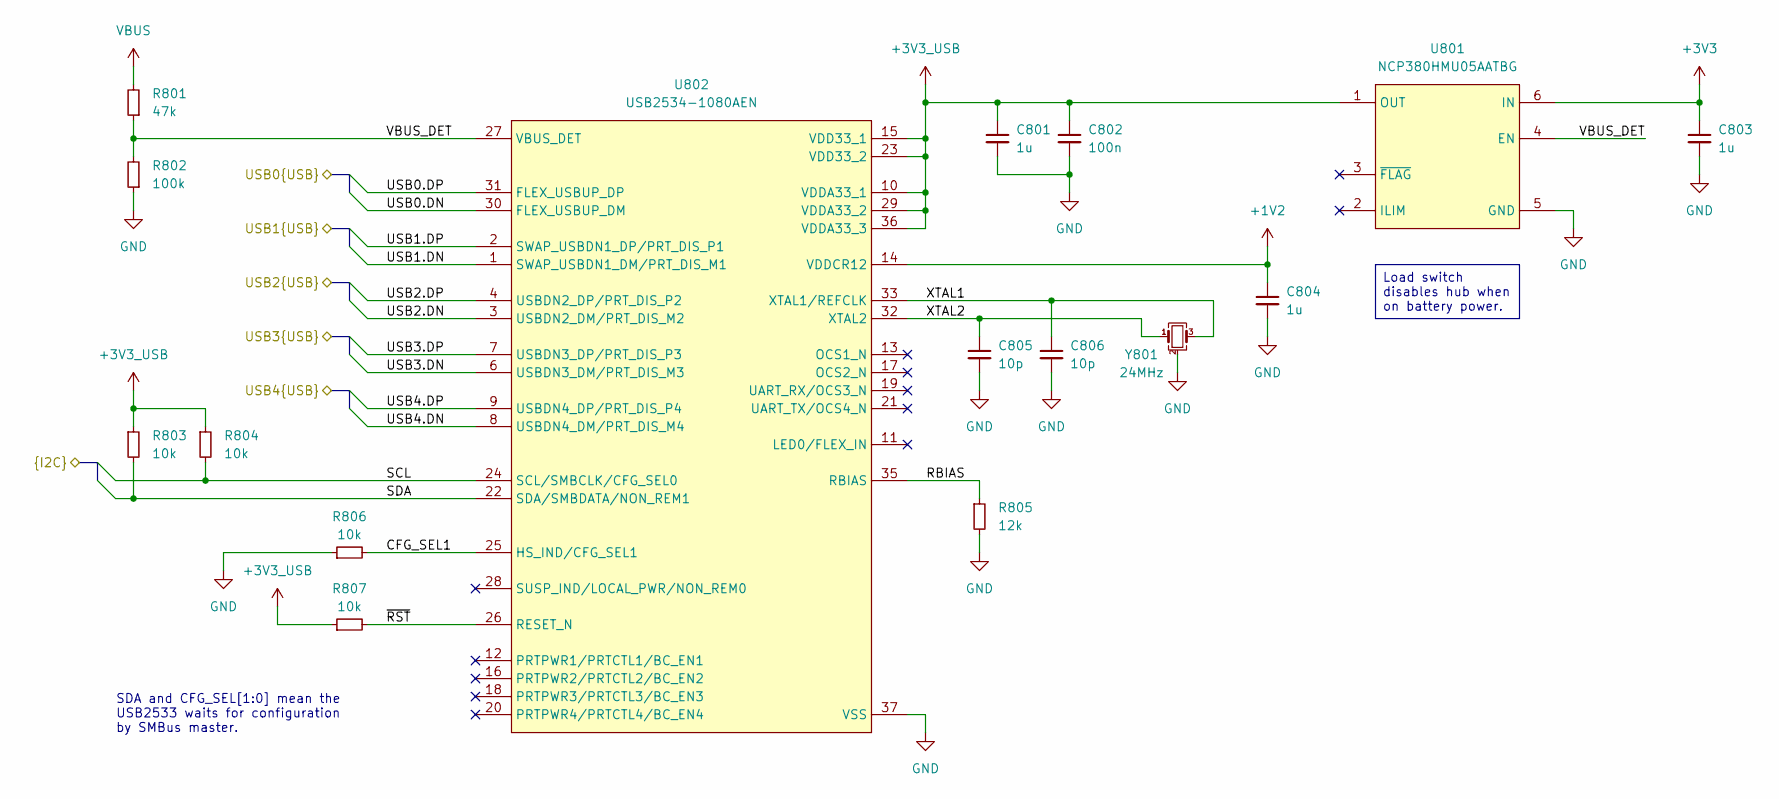
[picture p63: schematic usb-hub.kicad_sch]

Parts:
C801, C803, C804: 1u; C_0402
C802: 100n; C_0402
C805, C806: 10p; C_0402
R801: 47k; R_0402
R802: 100k; R_0402
R803, R804, R806, R807: 10k; R_0402
R805: 12k; R_0402
U801: NCP380HMU05AATBG; SON65P200X200X55-7N
U802: USB2534-1080AEN; QFN50P600X600X100-37N-D
Y801: CX2016SA24000D0HLLG3; Crystal_SMD_2016-4Pin_2.0x1.6mm

Connections:
+1V2: C804.1, U802.14 (VDDCR12)
+3V3: C803.1, U801.6 (IN); also elsewhere on the board
+3V3_USB: C801.1, C802.1, R803.1, R804.1, R807.1, U801.1 (OUT), U802.10 (VDDA33_1), U802.15 (VDD33_1), U802.23 (VDD33_2), U802.29 (VDDA33_2), U802.36 (VDDA33_3); also elsewhere on the board
/MCU/DN: U802.1 (SWAP_USBDN1_DM/PRT_DIS_M1); also elsewhere on the board
/MCU/DP: U802.2 (SWAP_USBDN1_DP/PRT_DIS_P1); also elsewhere on the board
/MCU/SCL: R804.2, U802.24 (SCL/SMBCLK/CFG_SEL0); also elsewhere on the board
/MCU/SDA: R803.2, U802.22 (SDA/SMBDATA/NON_REM1); also elsewhere on the board
/SD Card/DN: U802.8 (USBDN4_DM/PRT_DIS_M4); also elsewhere on the board
/SD Card/DP: U802.9 (USBDN4_DP/PRT_DIS_P4); also elsewhere on the board
/USB Connectors/USB0.DN: U802.30 (FLEX_USBUP_DM); also elsewhere on the board
/USB Connectors/USB0.DP: U802.31 (FLEX_USBUP_DP); also elsewhere on the board
/USB Connectors/USB2.DN: U802.3 (USBDN2_DM/PRT_DIS_M2); also elsewhere on the board
/USB Connectors/USB2.DP: U802.4 (USBDN2_DP/PRT_DIS_P2); also elsewhere on the board
/USB Connectors/USB3.DN: U802.6 (USBDN3_DM/PRT_DIS_M3); also elsewhere on the board
/USB Connectors/USB3.DP: U802.7 (USBDN3_DP/PRT_DIS_P3); also elsewhere on the board
/USB Hub/CFG_SEL1: R806.2, U802.25 (HS_IND/CFG_SEL1)
/USB Hub/RBIAS: R805.1, U802.35 (RBIAS)
/USB Hub/VBUS_DET: R801.1, R802.2, U801.4 (EN), U802.27 (VBUS_DET)
/USB Hub/XTAL1: C806.1, U802.33 (XTAL1/REFCLK), Y801.3
/USB Hub/XTAL2: C805.1, U802.32 (XTAL2), Y801.1
/USB Hub/~RST: R807.2, U802.26 (RESET_N)
GND: C801.2, C802.2, C803.2, C804.2, C805.2, C806.2, R802.1, R805.2, R806.1, U801.5 (GND), U801.7 (GND), U802.37 (VSS), Y801.2 (G), Y801.4 (G); also elsewhere on the board
VBUS: R801.2; also elsewhere on the board

Notes on the sheet:
SDA and CFG_SEL[1:0] mean the USB2533 waits for configuration by SMBus master.
Load switch disables hub when on battery power.

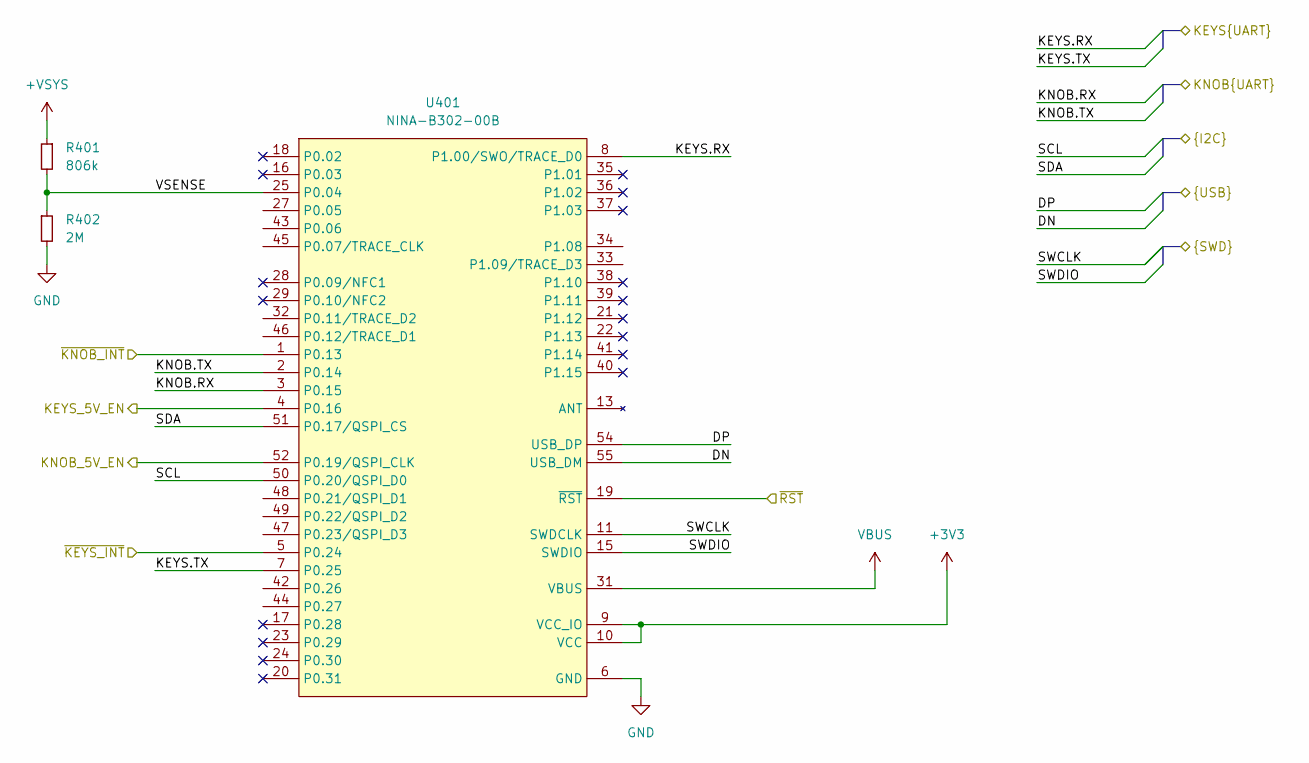
[picture p64: schematic mcu.kicad_sch]

Parts:
R401: 806k; R_0402
R402: 2M; R_0402
U401: NINA-B302-00B; NINAB30200B

Connections:
+3V3: U401.9 (VCC_IO), U401.10 (VCC); also elsewhere on the board
+VSYS: R401.1; also elsewhere on the board
/Daughter Board Connectors/KEYS.RX: U401.8 (P1.00/SWO/TRACE_D0); also elsewhere on the board
/Daughter Board Connectors/KEYS.TX: U401.7 (P0.25); also elsewhere on the board
/Daughter Board Connectors/KEYS_5V_EN: U401.4 (P0.16); also elsewhere on the board
/Daughter Board Connectors/KNOB.RX: U401.3 (P0.15); also elsewhere on the board
/Daughter Board Connectors/KNOB.TX: U401.2 (P0.14); also elsewhere on the board
/Daughter Board Connectors/KNOB_5V_EN: U401.52 (P0.19/QSPI_CLK); also elsewhere on the board
/Daughter Board Connectors/~KEYS_INT: U401.5 (P0.24); also elsewhere on the board
/Daughter Board Connectors/~KEYS_RST: U401.19 (~RST); also elsewhere on the board
/Daughter Board Connectors/~KNOB_INT: U401.1 (P0.13); also elsewhere on the board
/Debug Connector/CTRL.SWCLK: U401.11 (SWDCLK); also elsewhere on the board
/Debug Connector/CTRL.SWDIO: U401.15 (SWDIO); also elsewhere on the board
/MCU/DN: U401.55 (USB_DM); also elsewhere on the board
/MCU/DP: U401.54 (USB_DP); also elsewhere on the board
/MCU/SCL: U401.50 (P0.20/QSPI_D0); also elsewhere on the board
/MCU/SDA: U401.51 (P0.17/QSPI_CS); also elsewhere on the board
/MCU/VSENSE: R401.2, R402.1, U401.25 (P0.04)
GND: R402.2, U401.6 (GND), U401.12 (GND), U401.14 (GND), U401.26 (GND), U401.30 (GND), U401.53 (GND), U401.56 (GND), U401.57 (GND), U401.58 (GND), U401.59 (GND), U401.60 (GND), U401.61 (GND), U401.62 (GND), U401.63 (GND), U401.64 (GND), U401.65 (GND), U401.66 (GND), U401.67 (GND); also elsewhere on the board
VBUS: U401.31 (VBUS); also elsewhere on the board

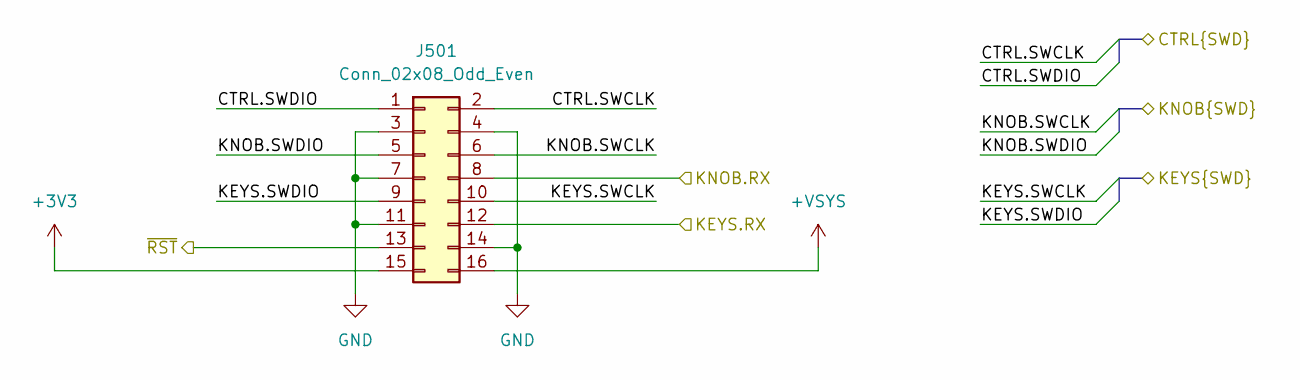
[picture p65: schematic debug-connector.kicad_sch]

Parts:
J501: Conn_02x08_Odd_Even; PinSocket_2x08_P1.27mm_Horizontal

Connections:
+3V3: J501.15; also elsewhere on the board
+VSYS: J501.16; also elsewhere on the board
/Daughter Board Connectors/KEYS.RX: J501.12; also elsewhere on the board
/Daughter Board Connectors/KEYS.SWCLK: J501.10; also elsewhere on the board
/Daughter Board Connectors/KEYS.SWDIO: J501.9; also elsewhere on the board
/Daughter Board Connectors/KNOB.RX: J501.8; also elsewhere on the board
/Daughter Board Connectors/KNOB.SWCLK: J501.6; also elsewhere on the board
/Daughter Board Connectors/KNOB.SWDIO: J501.5; also elsewhere on the board
/Daughter Board Connectors/~KEYS_RST: J501.13; also elsewhere on the board
/Debug Connector/CTRL.SWCLK: J501.2; also elsewhere on the board
/Debug Connector/CTRL.SWDIO: J501.1; also elsewhere on the board
GND: J501.3, J501.4, J501.7, J501.11, J501.14; also elsewhere on the board

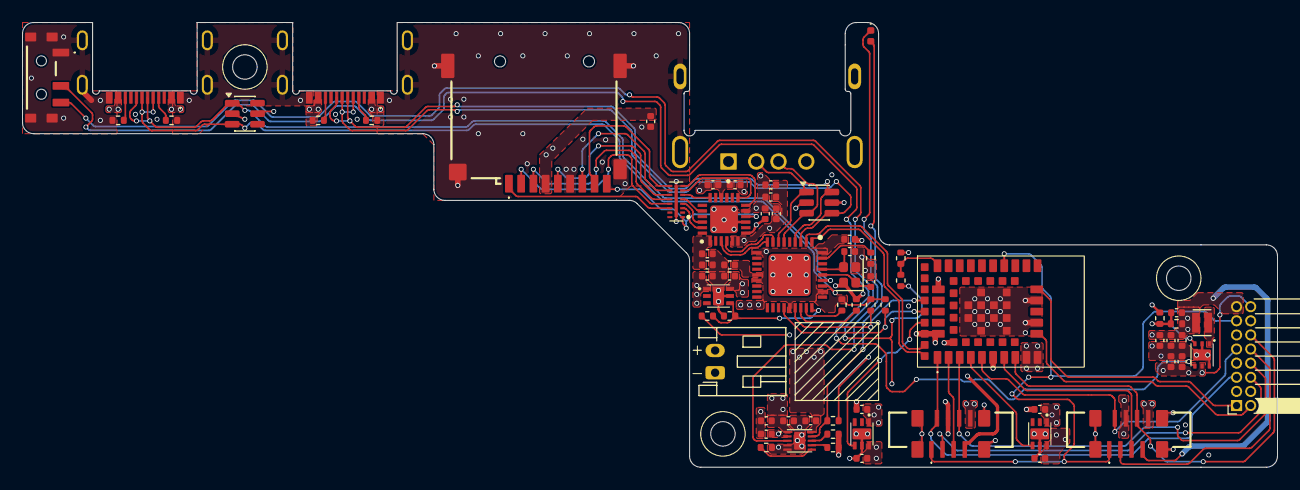
[picture p66: board left-control-board.kicad_pcb from above]

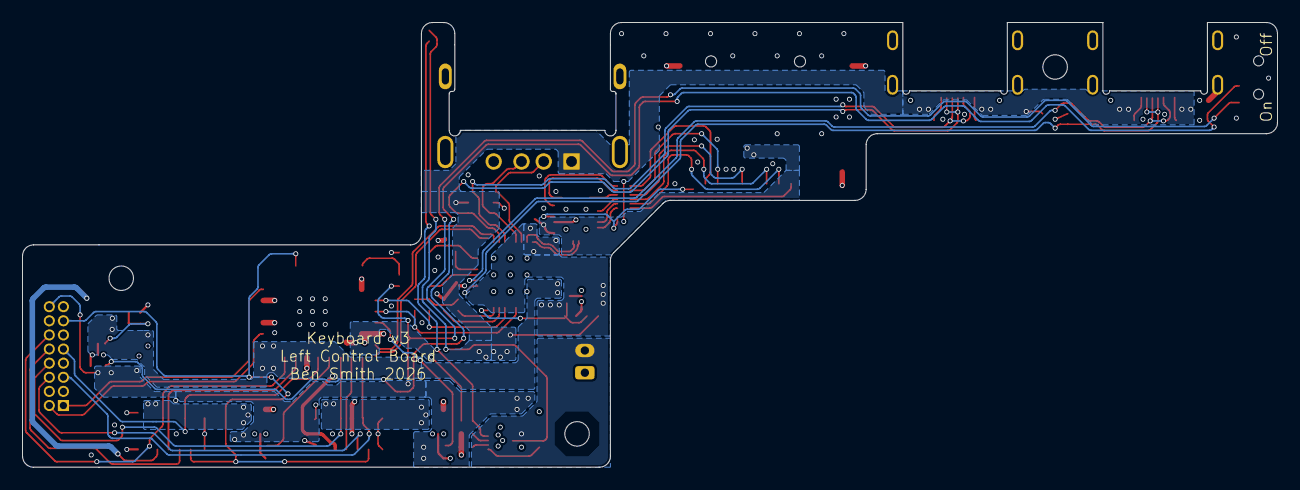
[picture p67: board left-control-board.kicad_pcb from below]

Board: 4 copper layers, 112.9 x 40.0 mm, 78 parts (2 on the bottom side), 73 nets.
