ben5049/Keyboard/PCBs/keyboard-v3/debug-breakout/debug-breakout.kicad_pcb

## KiCad design PCBs/keyboard-v3/debug-breakout/debug-breakout.kicad_pcb (2026-03-02)

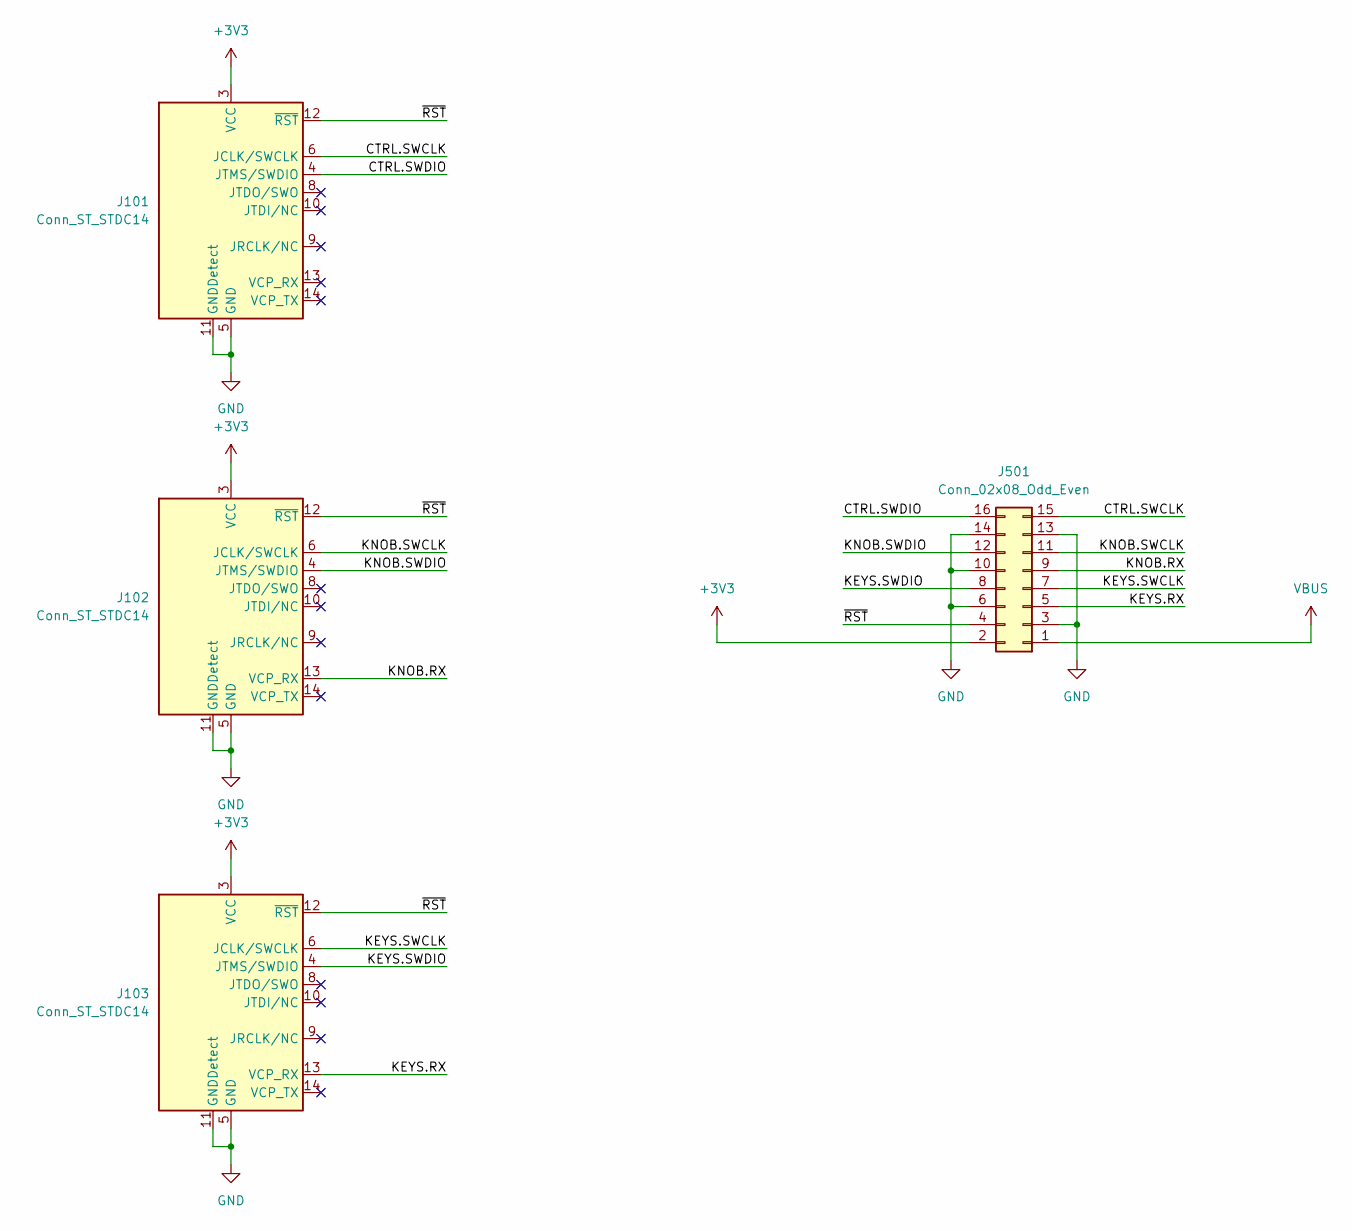
[picture p68: schematic debug-breakout.kicad_sch]

Parts:
J101, J102, J103: Conn_ST_STDC14; STDC14
J501: Conn_02x08_Odd_Even; PinHeader_2x08_P1.27mm_Horizontal

Connections:
+3V3: J101.3 (VCC), J102.3 (VCC), J103.3 (VCC), J501.2
/CTRL.SWCLK: J101.6 (JCLK/SWCLK), J501.15
/CTRL.SWDIO: J101.4 (JTMS/SWDIO), J501.16
/KEYS.RX: J103.13 (VCP_RX), J501.5
/KEYS.SWCLK: J103.6 (JCLK/SWCLK), J501.7
/KEYS.SWDIO: J103.4 (JTMS/SWDIO), J501.8
/KNOB.RX: J102.13 (VCP_RX), J501.9
/KNOB.SWCLK: J102.6 (JCLK/SWCLK), J501.11
/KNOB.SWDIO: J102.4 (JTMS/SWDIO), J501.12
/~RST: J101.12 (~RST), J102.12 (~RST), J103.12 (~RST), J501.4
GND: J101.5 (GND), J101.7 (GND), J101.11 (GNDDetect), J102.5 (GND), J102.7 (GND), J102.11 (GNDDetect), J103.5 (GND), J103.7 (GND), J103.11 (GNDDetect), J501.3, J501.6, J501.10, J501.13, J501.14
VBUS: J501.1

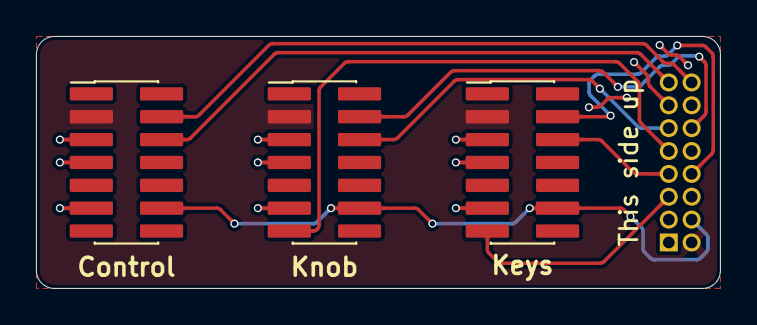
[picture p69: board debug-breakout.kicad_pcb from above]

Board: 2 copper layers, 38.0 x 14.0 mm, 4 parts (1 on the bottom side), 11 nets.
