ben5049/Keyboard/PCBs/keyboard-v3/right-key-board/right-key-board.kicad_pcb

## KiCad design PCBs/keyboard-v3/right-key-board/right-key-board.kicad_pcb (2026-03-02)

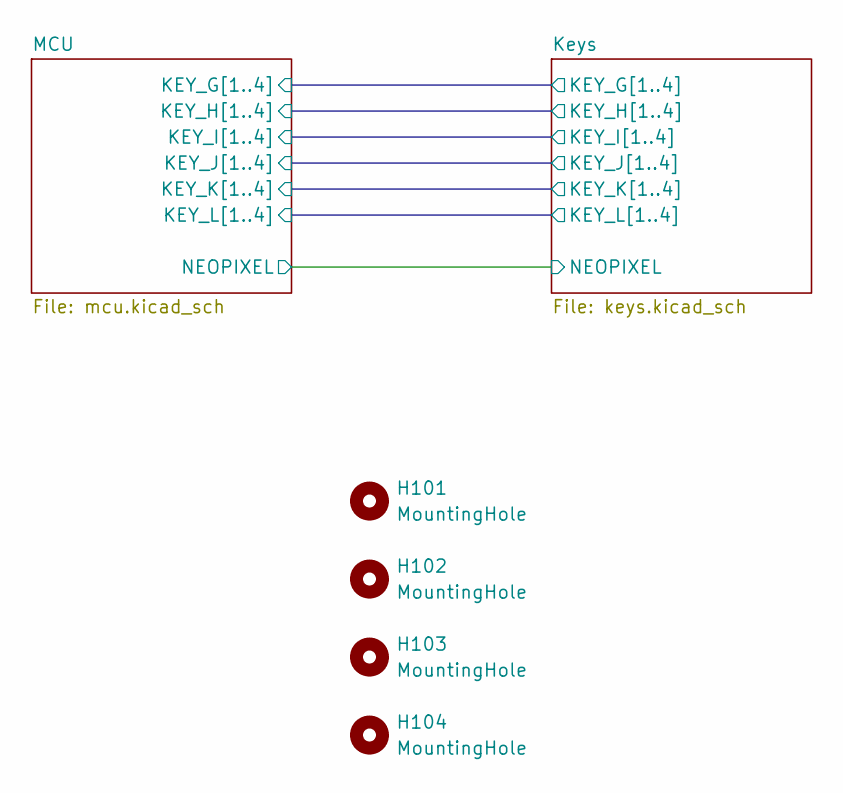
[picture p70: schematic right-key-board.kicad_sch]

Parts:
H101, H102, H103, H104: MountingHole; MountingHole_2.2mm_M2
