ben5049/Keyboard/PCBs/keyboard-v3/right-key-board/right-key-board.kicad_pcb

## KiCad design PCBs/keyboard-v3/right-key-board/right-key-board.kicad_pcb (continued)

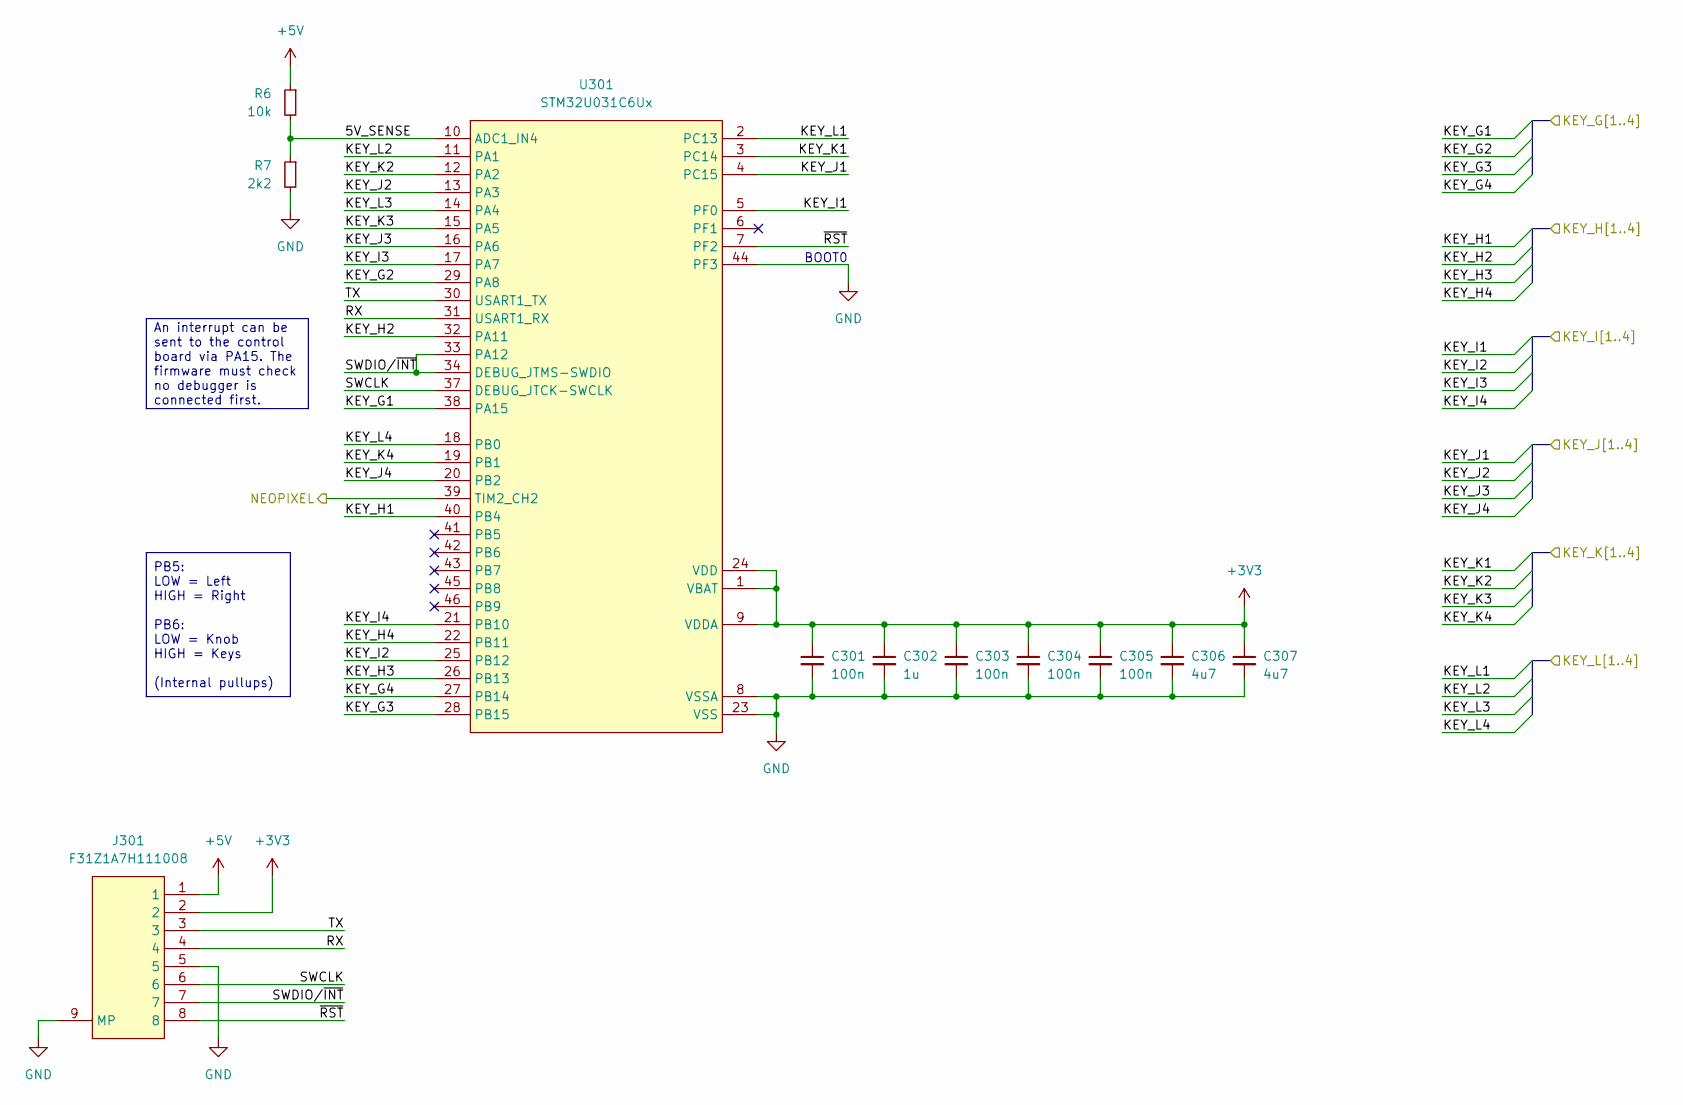
[picture p71: schematic mcu.kicad_sch]

Parts:
C301, C303, C304, C305: 100n; C_0402
C302: 1u; C_0402
C306, C307: 4u7; C_0402
J301: F31Z1A7H111008
R6: 10k; R_0402
R7: 2k2; R_0402
U301: STM32U031C6Ux; QFN50P700X700X60-49N-D

Connections:
+3V3: C301.1, C302.1, C303.1, C304.1, C305.1, C306.1, C307.1, J301.2, U301.1 (VBAT), U301.9 (VDDA), U301.24 (VDD), U301.36 (VDD), U301.48 (VDD)
+5V: J301.1, R6.1; also elsewhere on the board
/Keys/KEY_G1: U301.38 (PA15); also elsewhere on the board
/Keys/KEY_G2: U301.29 (PA8); also elsewhere on the board
/Keys/KEY_G3: U301.28 (PB15); also elsewhere on the board
/Keys/KEY_G4: U301.27 (PB14); also elsewhere on the board
/Keys/KEY_H1: U301.40 (PB4); also elsewhere on the board
/Keys/KEY_H2: U301.32 (PA11); also elsewhere on the board
/Keys/KEY_H3: U301.26 (PB13); also elsewhere on the board
/Keys/KEY_H4: U301.22 (PB11); also elsewhere on the board
/Keys/KEY_I1: U301.5 (PF0); also elsewhere on the board
/Keys/KEY_I2: U301.25 (PB12); also elsewhere on the board
/Keys/KEY_I3: U301.17 (PA7); also elsewhere on the board
/Keys/KEY_I4: U301.21 (PB10); also elsewhere on the board
/Keys/KEY_J1: U301.4 (PC15); also elsewhere on the board
/Keys/KEY_J2: U301.13 (PA3); also elsewhere on the board
/Keys/KEY_J3: U301.16 (PA6); also elsewhere on the board
/Keys/KEY_J4: U301.20 (PB2); also elsewhere on the board
/Keys/KEY_K1: U301.3 (PC14); also elsewhere on the board
/Keys/KEY_K2: U301.12 (PA2); also elsewhere on the board
/Keys/KEY_K3: U301.15 (PA5); also elsewhere on the board
/Keys/KEY_K4: U301.19 (PB1); also elsewhere on the board
/Keys/KEY_L1: U301.2 (PC13); also elsewhere on the board
/Keys/KEY_L2: U301.11 (PA1); also elsewhere on the board
/Keys/KEY_L3: U301.14 (PA4); also elsewhere on the board
/Keys/KEY_L4: U301.18 (PB0); also elsewhere on the board
/Keys/NEOPIXEL: U301.39 (TIM2_CH2); also elsewhere on the board
/MCU/5V_SENSE: R6.2, R7.1, U301.10 (ADC1_IN4)
/MCU/RX: J301.4, U301.31 (USART1_RX)
/MCU/SWCLK: J301.6, U301.37 (DEBUG_JTCK-SWCLK)
/MCU/SWDIO/~INT: J301.7, U301.33 (PA12), U301.34 (DEBUG_JTMS-SWDIO)
/MCU/TX: J301.3, U301.30 (USART1_TX)
/MCU/~RST: J301.8, U301.7 (PF2)
GND: C301.2, C302.2, C303.2, C304.2, C305.2, C306.2, C307.2, J301.5, J301.9 (MP), J301.10 (MP), J301.11 (MP), J301.12 (MP), R7.2, U301.8 (VSSA), U301.23 (VSS), U301.35 (VSS), U301.44 (PF3), U301.47 (VSS), U301.49 (VSS); also elsewhere on the board

Notes on the sheet:
BOOT0
An interrupt can be sent to the control board via PA15. The firmware must check no debugger is connected first.
PB5: LOW = Left HIGH = Right PB6: LOW = Knob HIGH = Keys (Internal pullups)

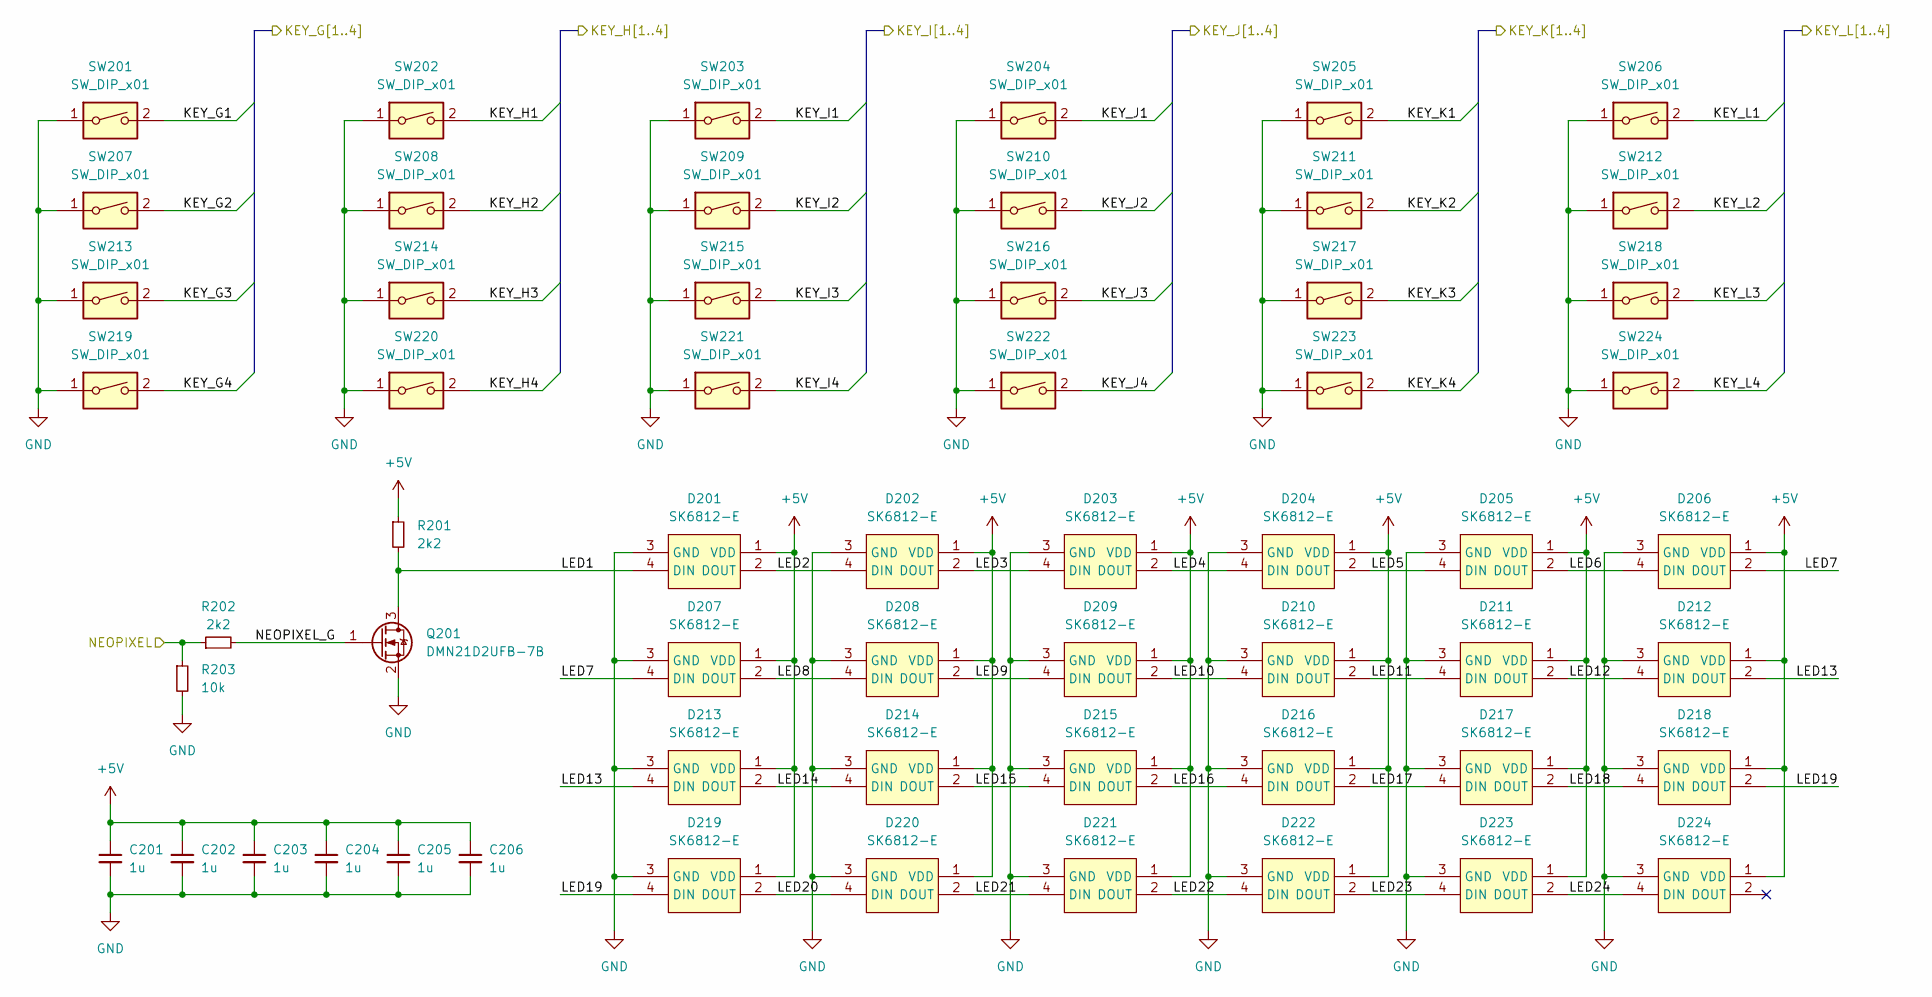
[picture p72: schematic keys.kicad_sch]

Parts:
C201, C202, C203, C204, C205, C206: 1u; C_0402
D201, D202, D203, D204, D205, D206, D207, D208, D209, D210, D211, D212, D213, D214, D215, D216, D217, D218, D219, D220, D221, D222, D223, D224: SK6812-E; sk6812-e; PARTREV 2
Q201: DMN21D2UFB-7B; DMN21D2UFB7B; Mouser Part Number 621-DMN21D2UFB-7B
R201, R202: 2k2; R_0402
R203: 10k; R_0402
SW201, SW202, SW203, SW204, SW205, SW206, SW207, SW208, SW209, SW210, SW211, SW212, SW213, SW214, SW215, SW216, SW217, SW218, SW219, SW220, SW221, SW222, SW223, SW224: SW_DIP_x01; SW_Kailh_Choc_V1_HotSwap

Connections:
+5V: C201.1, C202.1, C203.1, C204.1, C205.1, C206.1, D201.1 (VDD), D202.1 (VDD), D203.1 (VDD), D204.1 (VDD), D205.1 (VDD), D206.1 (VDD), D207.1 (VDD), D208.1 (VDD), D209.1 (VDD), D210.1 (VDD), D211.1 (VDD), D212.1 (VDD), D213.1 (VDD), D214.1 (VDD), D215.1 (VDD), D216.1 (VDD), D217.1 (VDD), D218.1 (VDD), D219.1 (VDD), D220.1 (VDD), D221.1 (VDD), D222.1 (VDD), D223.1 (VDD), D224.1 (VDD), R201.1; also elsewhere on the board
/Keys/KEY_G1: SW201.2; also elsewhere on the board
/Keys/KEY_G2: SW207.2; also elsewhere on the board
/Keys/KEY_G3: SW213.2; also elsewhere on the board
/Keys/KEY_G4: SW219.2; also elsewhere on the board
/Keys/KEY_H1: SW202.2; also elsewhere on the board
/Keys/KEY_H2: SW208.2; also elsewhere on the board
/Keys/KEY_H3: SW214.2; also elsewhere on the board
/Keys/KEY_H4: SW220.2; also elsewhere on the board
/Keys/KEY_I1: SW203.2; also elsewhere on the board
/Keys/KEY_I2: SW209.2; also elsewhere on the board
/Keys/KEY_I3: SW215.2; also elsewhere on the board
/Keys/KEY_I4: SW221.2; also elsewhere on the board
/Keys/KEY_J1: SW204.2; also elsewhere on the board
/Keys/KEY_J2: SW210.2; also elsewhere on the board
/Keys/KEY_J3: SW216.2; also elsewhere on the board
/Keys/KEY_J4: SW222.2; also elsewhere on the board
/Keys/KEY_K1: SW205.2; also elsewhere on the board
/Keys/KEY_K2: SW211.2; also elsewhere on the board
/Keys/KEY_K3: SW217.2; also elsewhere on the board
/Keys/KEY_K4: SW223.2; also elsewhere on the board
/Keys/KEY_L1: SW206.2; also elsewhere on the board
/Keys/KEY_L2: SW212.2; also elsewhere on the board
/Keys/KEY_L3: SW218.2; also elsewhere on the board
/Keys/KEY_L4: SW224.2; also elsewhere on the board
/Keys/LED1: D201.4 (DIN), Q201.3 (D), R201.2
/Keys/LED2: D201.2 (DOUT), D202.4 (DIN)
/Keys/LED3: D202.2 (DOUT), D203.4 (DIN)
/Keys/LED4: D203.2 (DOUT), D204.4 (DIN)
/Keys/LED5: D204.2 (DOUT), D205.4 (DIN)
/Keys/LED6: D205.2 (DOUT), D206.4 (DIN)
/Keys/LED7: D206.2 (DOUT), D207.4 (DIN)
/Keys/LED8: D207.2 (DOUT), D208.4 (DIN)
/Keys/LED9: D208.2 (DOUT), D209.4 (DIN)
/Keys/LED10: D209.2 (DOUT), D210.4 (DIN)
/Keys/LED11: D210.2 (DOUT), D211.4 (DIN)
/Keys/LED12: D211.2 (DOUT), D212.4 (DIN)
/Keys/LED13: D212.2 (DOUT), D213.4 (DIN)
/Keys/LED14: D213.2 (DOUT), D214.4 (DIN)
/Keys/LED15: D214.2 (DOUT), D215.4 (DIN)
/Keys/LED16: D215.2 (DOUT), D216.4 (DIN)
/Keys/LED17: D216.2 (DOUT), D217.4 (DIN)
/Keys/LED18: D217.2 (DOUT), D218.4 (DIN)
/Keys/LED19: D218.2 (DOUT), D219.4 (DIN)
/Keys/LED20: D219.2 (DOUT), D220.4 (DIN)
/Keys/LED21: D220.2 (DOUT), D221.4 (DIN)
/Keys/LED22: D221.2 (DOUT), D222.4 (DIN)
/Keys/LED23: D222.2 (DOUT), D223.4 (DIN)
/Keys/LED24: D223.2 (DOUT), D224.4 (DIN)
/Keys/NEOPIXEL: R202.1, R203.1; also elsewhere on the board
/Keys/NEOPIXEL_G: Q201.1 (G), R202.2
GND: C201.2, C202.2, C203.2, C204.2, C205.2, C206.2, D201.3 (GND), D202.3 (GND), D203.3 (GND), D204.3 (GND), D205.3 (GND), D206.3 (GND), D207.3 (GND), D208.3 (GND), D209.3 (GND), D210.3 (GND), D211.3 (GND), D212.3 (GND), D213.3 (GND), D214.3 (GND), D215.3 (GND), D216.3 (GND), D217.3 (GND), D218.3 (GND), D219.3 (GND), D220.3 (GND), D221.3 (GND), D222.3 (GND), D223.3 (GND), D224.3 (GND), Q201.2 (S), R203.2, SW201.1, SW202.1, SW203.1, SW204.1, SW205.1, SW206.1, SW207.1, SW208.1, SW209.1, SW210.1, SW211.1, SW212.1, SW213.1, SW214.1, SW215.1, SW216.1, SW217.1, SW218.1, SW219.1, SW220.1, SW221.1, SW222.1, SW223.1, SW224.1; also elsewhere on the board

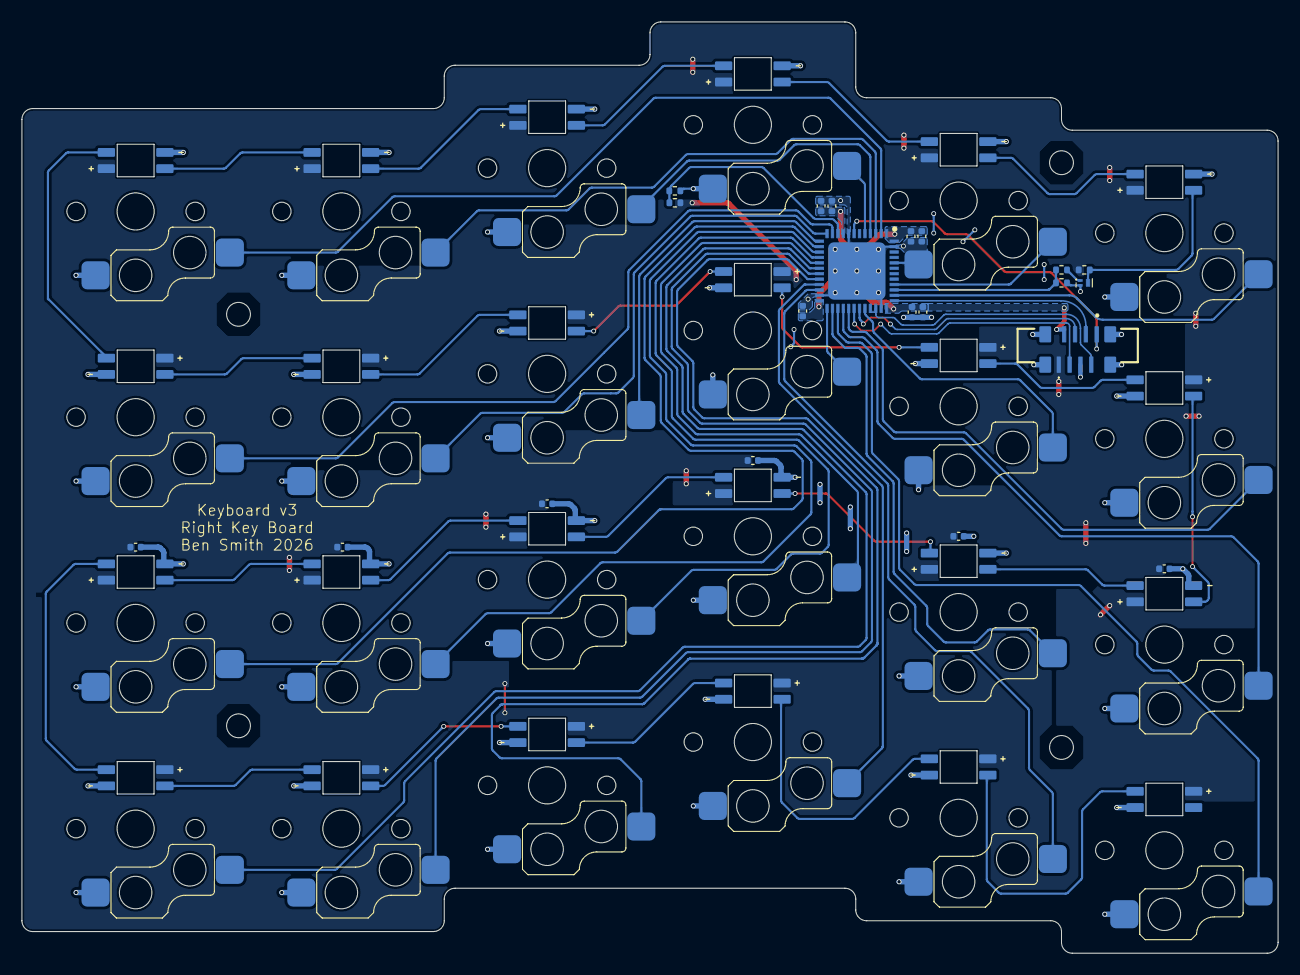
[picture p73: board right-key-board.kicad_pcb from below]

Board: 2 copper layers, 116.0 x 86.0 mm, 73 parts (49 on the bottom side), 59 nets.
