ben5049/Keyboard/PCBs/keyboard-v3/right-knob-board/right-knob-board.kicad_pcb

## KiCad design PCBs/keyboard-v3/right-knob-board/right-knob-board.kicad_pcb (2026-03-02)

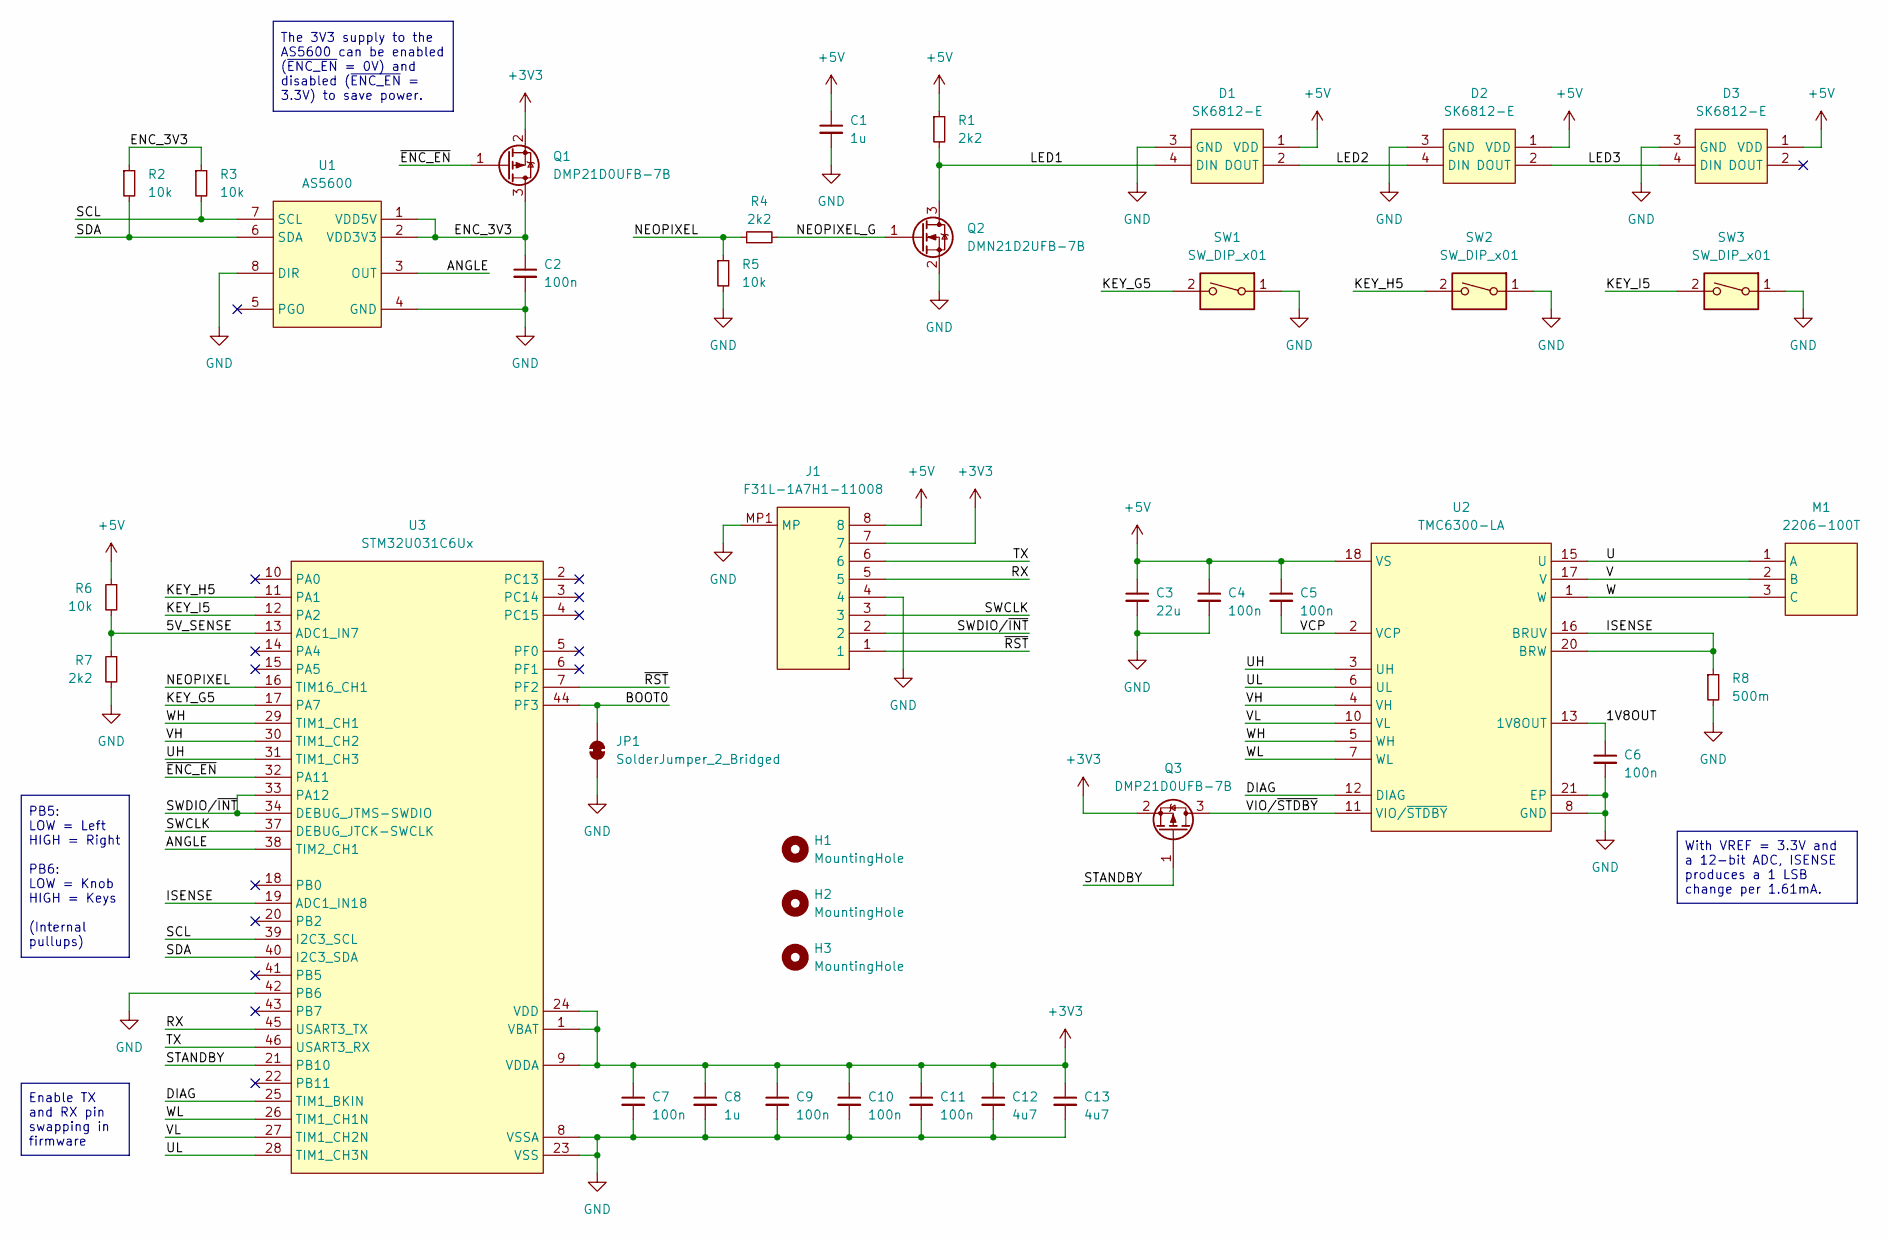
[picture p74: schematic right-knob-board.kicad_sch]

Parts:
C1, C8: 1u; C_0402
C2, C4, C5, C6, C7, C9, C10, C11: 100n; C_0402
C3: 22u; C_0603
C12, C13: 4u7; C_0402
D1, D2, D3: SK6812-E; sk6812-e; PARTREV 2
H1, H2, H3: MountingHole; MountingHole_2.2mm_M2
J1: F31L-1A7H1-11008
JP1: SolderJumper_2_Bridged; SolderJumper-2_P1.3mm_Bridged_RoundedPad1.0x1.5mm
M1: 2206-100T
Q1, Q3: DMP21D0UFB-7B; DMP21D0UFB7B; Mouser Part Number 621-DMP21D0UFB-7B
Q2: DMN21D2UFB-7B; DMN21D2UFB7B; Mouser Part Number 621-DMN21D2UFB-7B
R1, R4, R7: 2k2; R_0402
R2, R3, R5, R6: 10k; R_0402
R8: 500m; R_0402
SW1, SW2, SW3: SW_DIP_x01; SW_Kailh_Choc_V1_HotSwap
U1: AS5600; as5600-rear-magnet
U2: TMC6300-LA; QFN40P300X300X90-21N
U3: STM32U031C6Ux; QFN50P700X700X60-49N-D

Connections:
+3V3: C7.1, C8.1, C9.1, C10.1, C11.1, C12.1, C13.1, J1.7, Q1.2 (S), Q3.2 (S), U3.1 (VBAT), U3.9 (VDDA), U3.24 (VDD), U3.36 (VDD), U3.48 (VDD)
+5V: C1.1, C3.1, C4.1, C5.1, D1.1 (VDD), D2.1 (VDD), D3.1 (VDD), J1.8, R1.1, R6.1, U2.18 (VS)
/1V8OUT: C6.1, U2.13 (1V8OUT)
/5V_SENSE: R6.2, R7.1, U3.13 (ADC1_IN7)
/ANGLE: U1.3 (OUT), U3.38 (TIM2_CH1)
/BOOT0: JP1.2 (B), U3.44 (PF3)
/DIAG: U2.12 (DIAG), U3.25 (TIM1_BKIN)
/ENC_3V3: C2.1, Q1.3 (D), R2.1, R3.1, U1.1 (VDD5V), U1.2 (VDD3V3)
/ISENSE: R8.1, U2.16 (BRUV), U2.20 (BRW), U3.19 (ADC1_IN18)
/KEY_G5: SW1.2, U3.17 (PA7)
/KEY_H5: SW2.2, U3.11 (PA1)
/KEY_I5: SW3.2, U3.12 (PA2)
/LED1: D1.4 (DIN), Q2.3 (D), R1.2
/LED2: D1.2 (DOUT), D2.4 (DIN)
/LED3: D2.2 (DOUT), D3.4 (DIN)
/NEOPIXEL: R4.1, R5.1, U3.16 (TIM16_CH1)
/NEOPIXEL_G: Q2.1 (G), R4.2
/RX: J1.5, U3.45 (USART3_TX)
/SCL: R3.2, U1.7 (SCL), U3.39 (I2C3_SCL)
/SDA: R2.2, U1.6 (SDA), U3.40 (I2C3_SDA)
/STANDBY: Q3.1 (G), U3.21 (PB10)
/SWCLK: J1.3, U3.37 (DEBUG_JTCK-SWCLK)
/SWDIO/~INT: J1.2, U3.33 (PA12), U3.34 (DEBUG_JTMS-SWDIO)
/TX: J1.6, U3.46 (USART3_RX)
/U: M1.1 (A), U2.15 (U)
/UH: U2.3 (UH), U3.31 (TIM1_CH3)
/UL: U2.6 (UL), U3.28 (TIM1_CH3N)
/V: M1.2 (B), U2.17 (V)
/VCP: C5.2, U2.2 (VCP)
/VH: U2.4 (VH), U3.30 (TIM1_CH2)
/VIO/~STDBY: Q3.3 (D), U2.11 (VIO/~STDBY)
/VL: U2.10 (VL), U3.27 (TIM1_CH2N)
/W: M1.3 (C), U2.1 (W)
/WH: U2.5 (WH), U3.29 (TIM1_CH1)
/WL: U2.7 (WL), U3.26 (TIM1_CH1N)
/~ENC_EN: Q1.1 (G), U3.32 (PA11)
/~RST: J1.1, U3.7 (PF2)
GND: C1.2, C2.2, C3.2, C4.2, C6.2, C7.2, C8.2, C9.2, C10.2, C11.2, C12.2, C13.2, D1.3 (GND), D2.3 (GND), D3.3 (GND), J1.4, J1.MP1 (MP), J1.MP2 (MP), JP1.1 (A), Q2.2 (S), R5.2, R7.2, R8.2, SW1.1, SW2.1, SW3.1, U1.4 (GND), U1.8 (DIR), U2.8 (GND), U2.9 (GND), U2.14 (GND), U2.21 (EP), U3.8 (VSSA), U3.23 (VSS), U3.35 (VSS), U3.42 (PB6), U3.47 (VSS), U3.49 (VSS)

Notes on the sheet:
The 3V3 supply to the AS5600 can be enabled (~{ENC_EN} = 0V) and disabled (~{ENC_EN} = 3.3V) to save power.
Enable TX and RX pin swapping in firmware
With VREF = 3.3V and a 12-bit ADC, ISENSE produces a 1 LSB change per 1.61mA.
PB5: LOW = Left HIGH = Right PB6: LOW = Knob HIGH = Keys (Internal pullups)

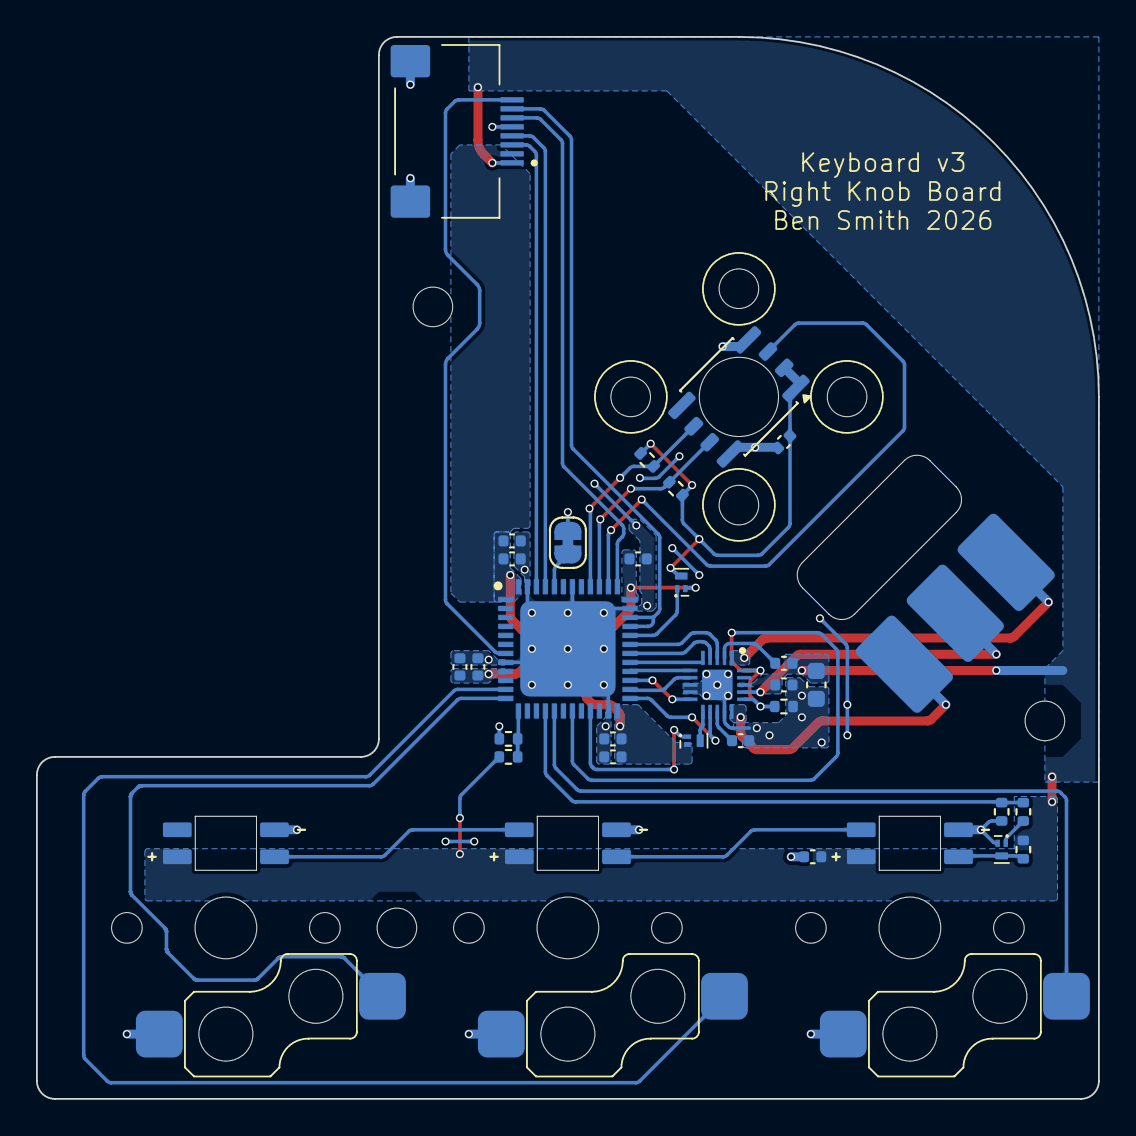
[picture p75: board right-knob-board.kicad_pcb from below]

Board: 2 copper layers, 59.0 x 59.0 mm, 39 parts (33 on the bottom side), 38 nets.
