ben5049/Keyboard/PCBs/keyboard-v1/right_board/right_board.kicad_pcb

## KiCad design PCBs/keyboard-v1/right_board/right_board.kicad_pcb (2024-05-18, an earlier design)

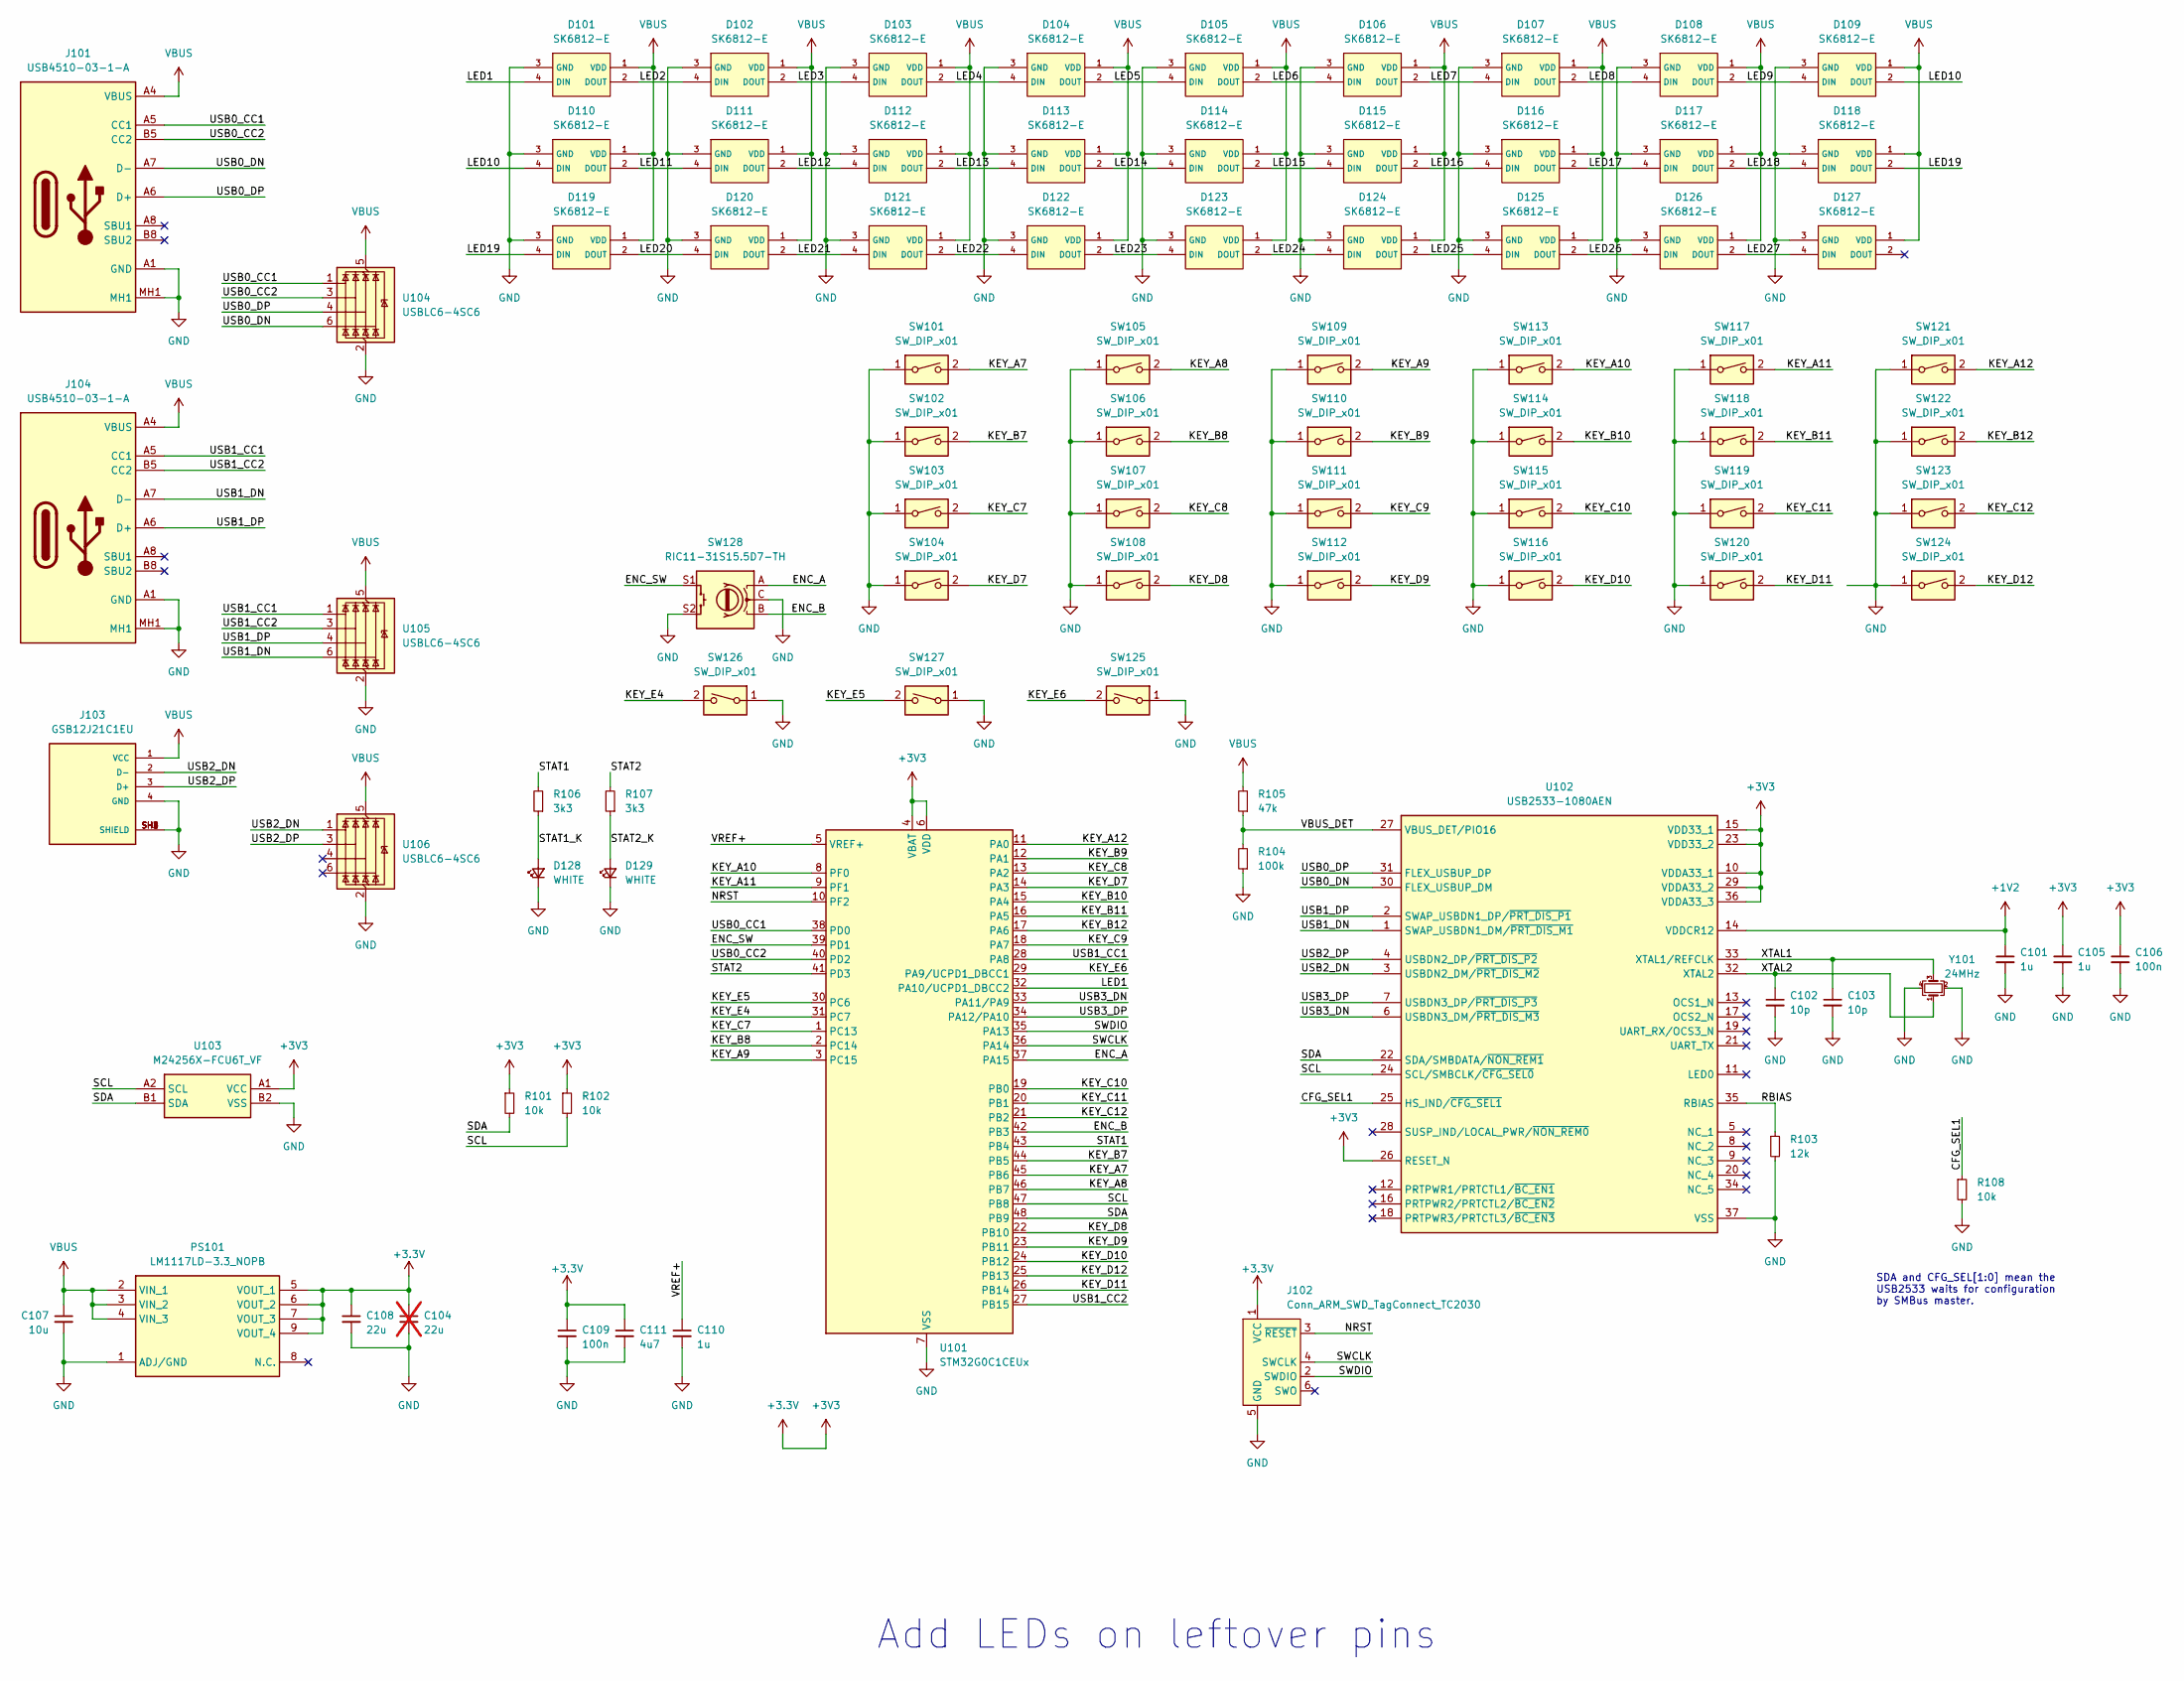
[picture p76: schematic right_board.kicad_sch]

Parts:
C101, C105, C110: 1u; C_0402_1005Metric
C102, C103: 10p; C_0402_1005Metric
C104: 22u; C_0603_1608Metric; not fitted
C106, C109: 100n; C_0402_1005Metric
C107: 10u; C_0603_1608Metric
C108: 22u; C_0603_1608Metric
C111: 4u7; C_0402_1005Metric
D101, D102, D103, D104, D105, D106, D107, D108, D109, D110, D111, D112, D113, D114, D115, D116, D117, D118, D119, D120, D121, D122, D123, D124, D125, D126, D127: SK6812-E; LED_SK6812-E; PARTREV 2
D128, D129: WHITE; LED_0402_1005Metric
J101, J104: USB4510-03-1-A; USB4510031A; Mouser Part Number 640-USB4510031A
J102: Conn_ARM_SWD_TagConnect_TC2030; Tag-Connect_TC2030-IDC-FP_2x03_P1.27mm_Vertical
J103: GSB12J21C1EU; AMPHENOL_GSB12J21C1EU; PARTREV B
PS101: LM1117LD-3.3_NOPB; LP2989AILD33NOPB; Mouser Part Number 926-LM1117LD33NOPB
R101, R102, R108: 10k; R_0402_1005Metric
R103: 12k; R_0402_1005Metric
R104: 100k; R_0402_1005Metric
R105: 47k; R_0402_1005Metric
R106, R107: 3k3; R_0402_1005Metric
SW101, SW102, SW103, SW104, SW105, SW106, SW107, SW108, SW109, SW110, SW111, SW112, SW113, SW114, SW115, SW116, SW117, SW118, SW119, SW120, SW121, SW122, SW123, SW124, SW125, SW126, SW127: SW_DIP_x01; gateron-ks27-hotswap
SW128: RIC11-31S15.5D7-TH; RotaryEncoder_Alps_EC11E-Switch_Vertical_H20mm
U101: STM32G0C1CEUx; QFN-48-1EP_7x7mm_P0.5mm_EP5.6x5.6mm
U102: USB2533-1080AEN; QFN50P600X600X100-37N-D; Mouser Part Number 579-USB2533-1080AEN
U103: M24256X-FCU6T_VF; BGA4C50P2X2_100X100X67; Mouser Part Number 511-M24256X-FCU6T/VF
U104, U105, U106: USBLC6-4SC6; SOT-23-6
Y101: CX2016SA24000D0HLLG3; Crystal_SMD_2016-4Pin_2.0x1.6mm

Connections:
+1V2: C101.1, U102.14 (VDDCR12)
+3.3V: C104.1, C105.1, C106.1, C108.1, C109.1, C111.1, J102.1 (VCC), PS101.5 (VOUT_1), PS101.6 (VOUT_2), PS101.7 (VOUT_3), PS101.9 (VOUT_4), R101.1, R102.1, U101.4 (VBAT), U101.6 (VDD), U102.10 (VDDA33_1), U102.15 (VDD33_1), U102.23 (VDD33_2), U102.26 (RESET_N), U102.29 (VDDA33_2), U102.36 (VDDA33_3), U103.A1 (VCC)
/CFG_SEL1: R108.1, U102.25 (HS_IND/~CFG_SEL1)
/ENC_A: SW128.A, U101.37 (PA15)
/ENC_B: SW128.B, U101.42 (PB3)
/ENC_SW: SW128.S1, U101.39 (PD1)
/KEY_A7: SW101.2, U101.45 (PB6)
/KEY_A8: SW105.2, U101.46 (PB7)
/KEY_A9: SW109.2, U101.3 (PC15)
/KEY_A10: SW113.2, U101.8 (PF0)
/KEY_A11: SW117.2, U101.9 (PF1)
/KEY_A12: SW121.2, U101.11 (PA0)
/KEY_B7: SW102.2, U101.44 (PB5)
/KEY_B8: SW106.2, U101.2 (PC14)
/KEY_B9: SW110.2, U101.12 (PA1)
/KEY_B10: SW114.2, U101.15 (PA4)
/KEY_B11: SW118.2, U101.16 (PA5)
/KEY_B12: SW122.2, U101.17 (PA6)
/KEY_C7: SW103.2, U101.1 (PC13)
/KEY_C8: SW107.2, U101.13 (PA2)
/KEY_C9: SW111.2, U101.18 (PA7)
/KEY_C10: SW115.2, U101.19 (PB0)
/KEY_C11: SW119.2, U101.20 (PB1)
/KEY_C12: SW123.2, U101.21 (PB2)
/KEY_D7: SW104.2, U101.14 (PA3)
/KEY_D8: SW108.2, U101.22 (PB10)
/KEY_D9: SW112.2, U101.23 (PB11)
/KEY_D10: SW116.2, U101.24 (PB12)
/KEY_D11: SW120.2, U101.26 (PB14)
/KEY_D12: SW124.2, U101.25 (PB13)
/KEY_E4: SW126.2, U101.31 (PC7)
/KEY_E5: SW127.2, U101.30 (PC6)
/KEY_E6: SW125.2, U101.29 (PA9/UCPD1_DBCC1)
/LED1: D101.4 (DIN), U101.32 (PA10/UCPD1_DBCC2)
/LED2: D101.2 (DOUT), D102.4 (DIN)
/LED3: D102.2 (DOUT), D103.4 (DIN)
/LED4: D103.2 (DOUT), D104.4 (DIN)
/LED5: D104.2 (DOUT), D105.4 (DIN)
/LED6: D105.2 (DOUT), D106.4 (DIN)
/LED7: D106.2 (DOUT), D107.4 (DIN)
/LED8: D107.2 (DOUT), D108.4 (DIN)
/LED9: D108.2 (DOUT), D109.4 (DIN)
/LED10: D109.2 (DOUT), D110.4 (DIN)
/LED11: D110.2 (DOUT), D111.4 (DIN)
/LED12: D111.2 (DOUT), D112.4 (DIN)
/LED13: D112.2 (DOUT), D113.4 (DIN)
/LED14: D113.2 (DOUT), D114.4 (DIN)
/LED15: D114.2 (DOUT), D115.4 (DIN)
/LED16: D115.2 (DOUT), D116.4 (DIN)
/LED17: D116.2 (DOUT), D117.4 (DIN)
/LED18: D117.2 (DOUT), D118.4 (DIN)
/LED19: D118.2 (DOUT), D119.4 (DIN)
/LED20: D119.2 (DOUT), D120.4 (DIN)
/LED21: D120.2 (DOUT), D121.4 (DIN)
/LED22: D121.2 (DOUT), D122.4 (DIN)
/LED23: D122.2 (DOUT), D123.4 (DIN)
/LED24: D123.2 (DOUT), D124.4 (DIN)
/LED25: D124.2 (DOUT), D125.4 (DIN)
/LED26: D125.2 (DOUT), D126.4 (DIN)
/LED27: D126.2 (DOUT), D127.4 (DIN)
/NRST: J102.3 (~RESET), U101.10 (PF2)
/RBIAS: R103.1, U102.35 (RBIAS)
/SCL: R102.2, U101.47 (PB8), U102.24 (SCL/SMBCLK/~CFG_SEL0), U103.A2 (SCL)
/SDA: R101.2, U101.48 (PB9), U102.22 (SDA/SMBDATA/~NON_REM1), U103.B1 (SDA)
/STAT1: R106.2, U101.43 (PB4)
/STAT1_K: D128.2 (A), R106.1
/STAT2: R107.2, U101.41 (PD3)
/STAT2_K: D129.2 (A), R107.1
/SWCLK: J102.4 (SWCLK), U101.36 (PA14)
/SWDIO: J102.2 (SWDIO), U101.35 (PA13)
/USB0_CC1: J101.A5 (CC1), U101.38 (PD0), U104.1 (I/O1)
/USB0_CC2: J101.B5 (CC2), U101.40 (PD2), U104.3 (I/O2)
/USB0_DN: J101.A7 (D-), J101.B7 (D-), U102.30 (FLEX_USBUP_DM), U104.6 (I/O4)
/USB0_DP: J101.A6 (D+), J101.B6 (D+), U102.31 (FLEX_USBUP_DP), U104.4 (I/O3)
/USB1_CC1: J104.A5 (CC1), U101.28 (PA8), U105.1 (I/O1)
/USB1_CC2: J104.B5 (CC2), U101.27 (PB15), U105.3 (I/O2)
/USB1_DN: J104.A7 (D-), J104.B7 (D-), U102.1 (SWAP_USBDN1_DM/~PRT_DIS_M1), U105.6 (I/O4)
/USB1_DP: J104.A6 (D+), J104.B6 (D+), U102.2 (SWAP_USBDN1_DP/~PRT_DIS_P1), U105.4 (I/O3)
/USB2_DN: J103.2 (D-), U102.3 (USBDN2_DM/~PRT_DIS_M2), U106.1 (I/O1)
/USB2_DP: J103.3 (D+), U102.4 (USBDN2_DP/~PRT_DIS_P2), U106.3 (I/O2)
/USB3_DN: U101.33 (PA11/PA9), U102.6 (USBDN3_DM/~PRT_DIS_M3)
/USB3_DP: U101.34 (PA12/PA10), U102.7 (USBDN3_DP/~PRT_DIS_P3)
/VBUS_DET: R104.2, R105.1, U102.27 (VBUS_DET/PIO16)
/VREF+: C110.1, U101.5 (VREF+)
/XTAL1: C103.1, U102.33 (XTAL1/REFCLK), Y101.3
/XTAL2: C102.1, U102.32 (XTAL2), Y101.1
GND: C101.2, C102.2, C103.2, C104.2, C105.2, C106.2, C107.2, C108.2, C109.2, C110.2, C111.2, D101.3 (GND), D102.3 (GND), D103.3 (GND), D104.3 (GND), D105.3 (GND), D106.3 (GND), D107.3 (GND), D108.3 (GND), D109.3 (GND), D110.3 (GND), D111.3 (GND), D112.3 (GND), D113.3 (GND), D114.3 (GND), D115.3 (GND), D116.3 (GND), D117.3 (GND), D118.3 (GND), D119.3 (GND), D120.3 (GND), D121.3 (GND), D122.3 (GND), D123.3 (GND), D124.3 (GND), D125.3 (GND), D126.3 (GND), D127.3 (GND), D128.1 (K), D129.1 (K), J101.A1 (GND), J101.A12 (GND), J101.MH1, J101.MH2, J101.MH3, J101.MH4, J102.5 (GND), J103.4 (GND), J103.SH1 (SHIELD), J103.SH2 (SHIELD), J103.SH3 (SHIELD), J103.SH4 (SHIELD), J104.A1 (GND), J104.A12 (GND), J104.MH1, J104.MH2, J104.MH3, J104.MH4, PS101.1 (ADJ/GND), R103.2, R104.1, R108.2, SW101.1, SW102.1, SW103.1, SW104.1, SW105.1, SW106.1, SW107.1, SW108.1, SW109.1, SW110.1, SW111.1, SW112.1, SW113.1, SW114.1, SW115.1, SW116.1, SW117.1, SW118.1, SW119.1, SW120.1, SW121.1, SW122.1, SW123.1, SW124.1, SW125.1, SW126.1, SW127.1, SW128.C, SW128.S2, U101.7 (VSS), U101.49 (VSS), U102.37 (VSS), U103.B2 (VSS), U104.2 (GND), U105.2 (GND), U106.2 (GND), Y101.2, Y101.4
VBUS: C107.1, D101.1 (VDD), D102.1 (VDD), D103.1 (VDD), D104.1 (VDD), D105.1 (VDD), D106.1 (VDD), D107.1 (VDD), D108.1 (VDD), D109.1 (VDD), D110.1 (VDD), D111.1 (VDD), D112.1 (VDD), D113.1 (VDD), D114.1 (VDD), D115.1 (VDD), D116.1 (VDD), D117.1 (VDD), D118.1 (VDD), D119.1 (VDD), D120.1 (VDD), D121.1 (VDD), D122.1 (VDD), D123.1 (VDD), D124.1 (VDD), D125.1 (VDD), D126.1 (VDD), D127.1 (VDD), J101.A4 (VBUS), J101.A9 (VBUS), J103.1 (VCC), J104.A4 (VBUS), J104.A9 (VBUS), PS101.2 (VIN_1), PS101.3 (VIN_2), PS101.4 (VIN_3), R105.2, U104.5 (VBUS), U105.5 (VBUS), U106.5 (VBUS)

Notes on the sheet:
SDA and CFG_SEL[1:0] mean the USB2533 waits for configuration by SMBus master.
Add LEDs on leftover pins
