ben5049/Keyboard/PCBs/keyboard-v1/right_board/right_board.kicad_pcb

## KiCad design PCBs/keyboard-v1/right_board/right_board.kicad_pcb (continued)

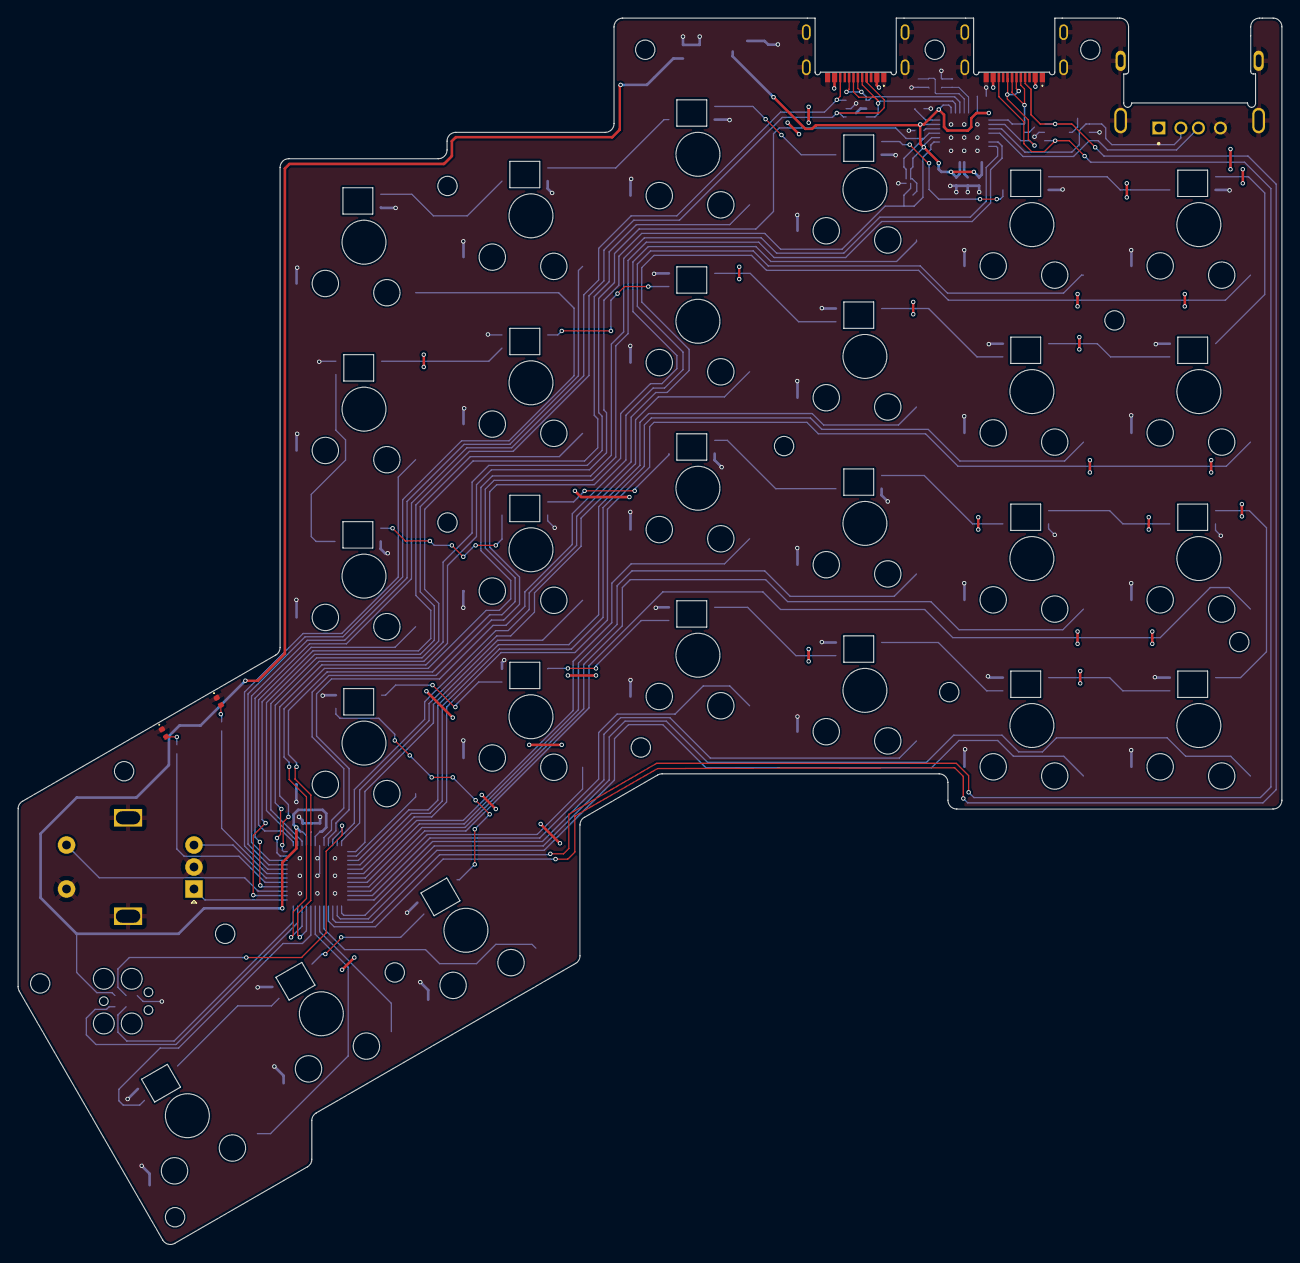
[picture p77: board right_board.kicad_pcb from above]

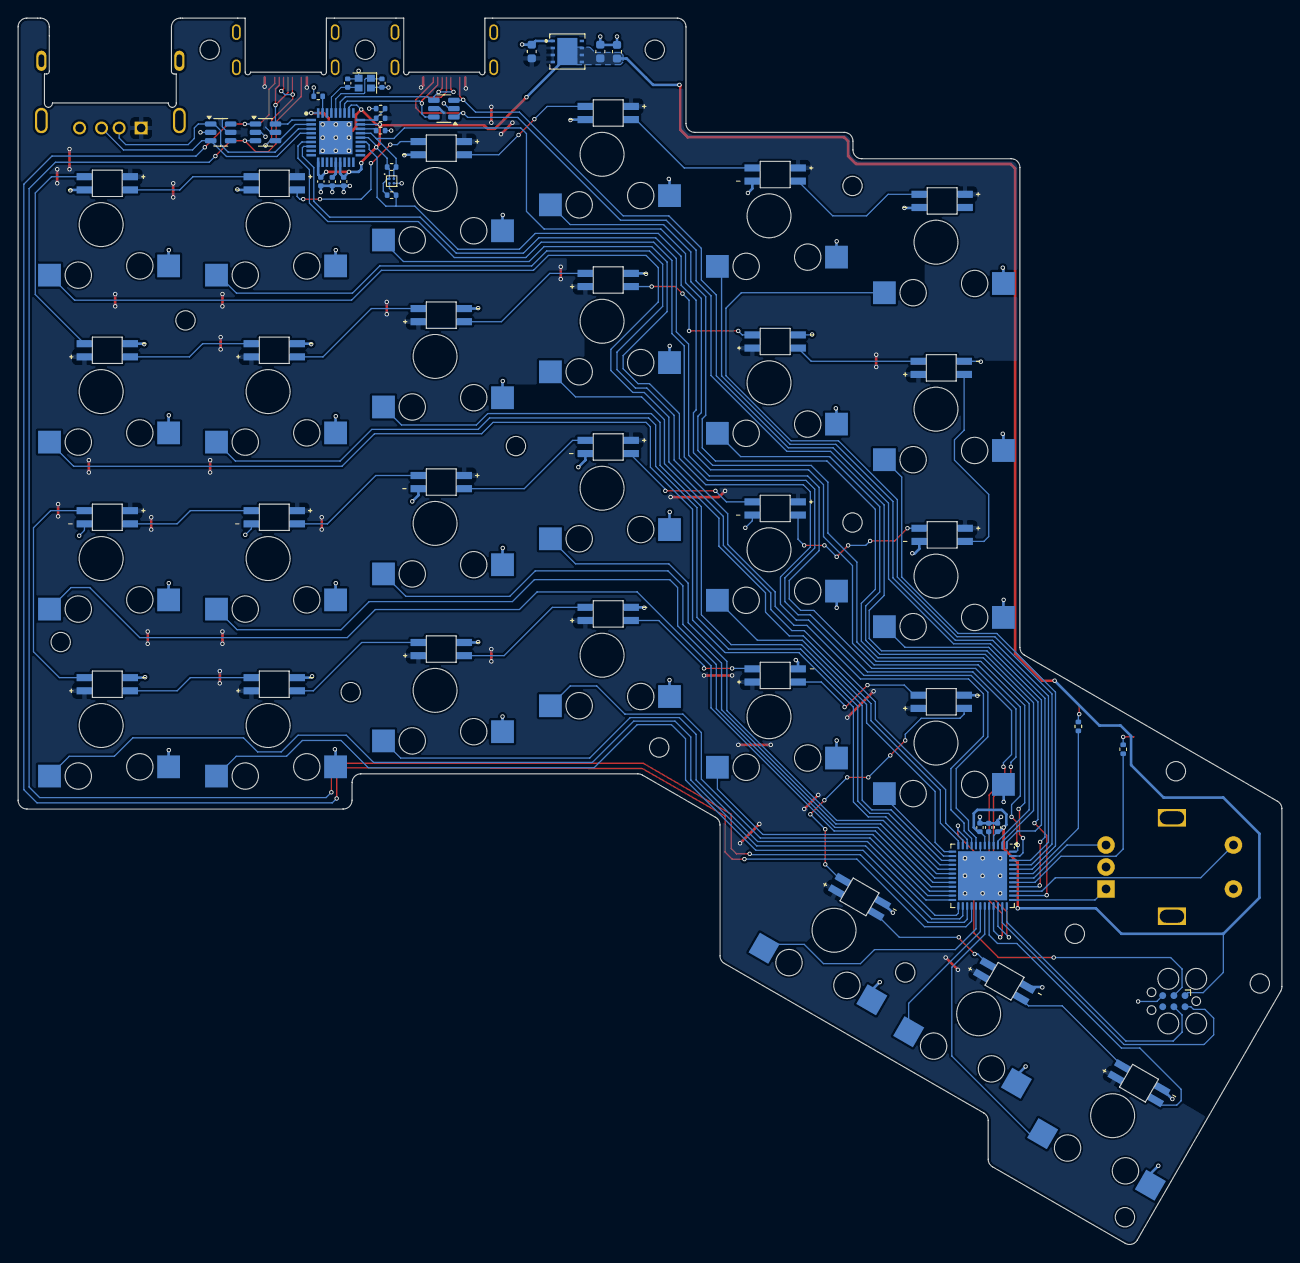
[picture p78: board right_board.kicad_pcb from below]

Board: 2 copper layers, 143.8 x 139.6 mm, 88 parts (55 on the bottom side), 88 nets.
