ben5049/Keyboard/PCBs/keyboard_v2/keyboard_v2.kicad_pcb

## KiCad design PCBs/keyboard_v2/keyboard_v2.kicad_pcb (2024-07-13, an earlier design)

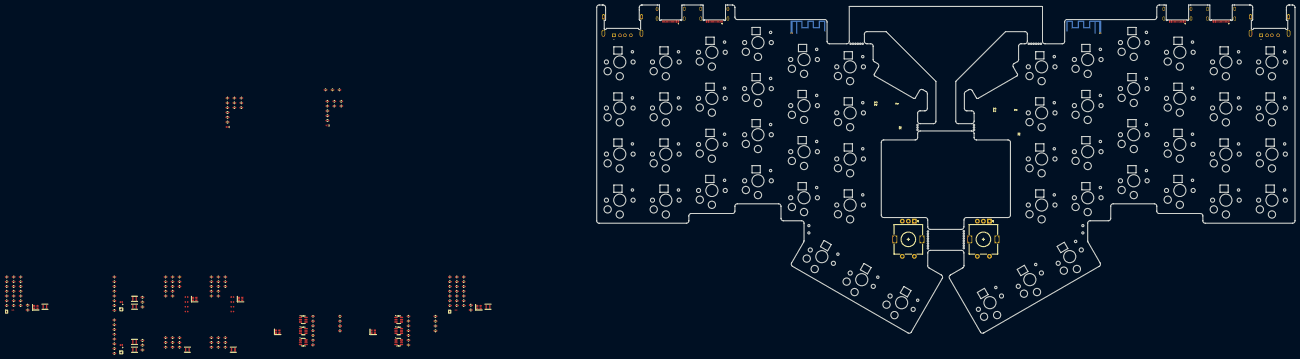
[picture p79: board keyboard_v2.kicad_pcb from above]

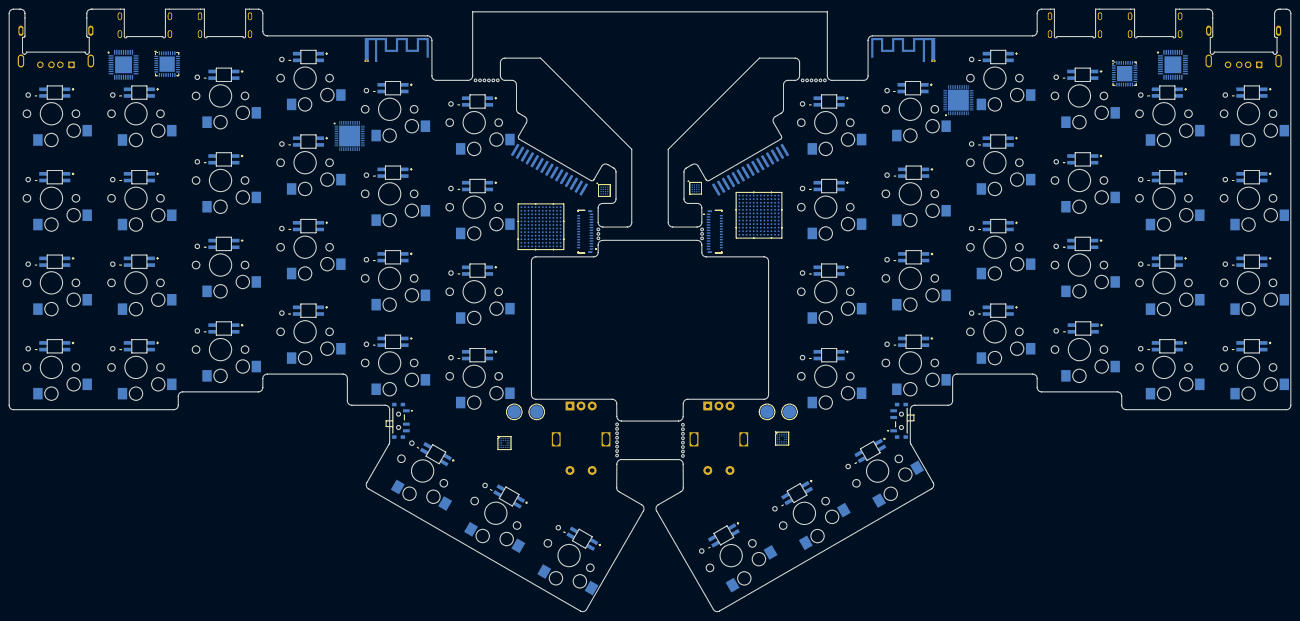
[picture p80: board keyboard_v2.kicad_pcb from below]

Board: 2 copper layers, 288.0 x 135.4 mm, 336 parts (78 on the bottom side), 197 nets, no tracks yet.

Parts:
AE202: Antenna_Shield; Texas_SWRA117D_2.4GHz_Left
AE302: Antenna_Shield; Texas_SWRA117D_2.4GHz_Right
C401, C404, C407, C503, C504, C505, C506, C507, C508, C808, C819, C1101, C1104, C1107, C1308, C1319, C1403, C1404, C1405, C1406, C1407, C1408: 10u; C_0402_1005Metric
C402, C405, C406, C602, C815, C1102, C1105, C1106, C1315, C1502: 4u7; C_0402_1005Metric
C403, C502, C606, C607, C812, C912, C915, C1012, C1015, C1103, C1312, C1402, C1506, C1507: 1u; C_0402_1005Metric
C408, C409, C1108, C1109: 22u; C_0402_1005Metric
C501, C821, C822, C1321, C1322, C1401: 2u2; C_0402_1005Metric
C601, C608, C701, C702, C703, C704, C705, C706, C707, C708, C709, C801, C802, C803, C804, C805, C806, C809, C810, C811, C813, C814, C816, C817, C907, C908, C909, C910, C911, C1007, C1008, C1009, C1010, C1011, C1201, C1202, C1203, C1204, C1205, C1206, C1207, C1208, C1209, C1301, C1302, C1303, C1304, C1305, C1306, C1309, C1310, C1311, C1313, C1314, C1316, C1317, C1501, C1508: 100n; C_0402_1005Metric
C604, C605, C1504, C1505: 10p; C_0402_1005Metric
C807, C1307: 1u; C_0201_0603Metric
C823, C824, C903, C904, C1003, C1004, C1323, C1324: 12p; C_0402_1005Metric
C905, C1005: 1p; C_0402_1005Metric
C906, C1006: 1p2; C_0402_1005Metric
C913, C1013: 100p; C_0402_1005Metric
C914, C1014: 47n; C_0402_1005Metric
D701, D702, D703, D704, D705, D706, D707, D708, D709, D710, D711, D712, D713, D714, D715, D716, D717, D718, D719, D720, D721, D722, D723, D724, D725, D726, D727, D1201, D1202, D1203, D1204, D1205, D1206, D1207, D1208, D1209, D1210, D1211, D1212, D1213, D1214, D1215, D1216, D1217, D1218, D1219, D1220, D1221, D1222, D1223, D1224, D1225, D1226, D1227: SK6812-E; LED_SK6812-E
IC501, IC1401: ADP5360ACBZ-2-R7; ADP5360ACBZ1R7
J201, J301: TMS-115-01-G-S; debug_header
J401, J1101: FH26W-27S-0.3SHW_60_; FH26W27S03SHW60
J601, J602, J1501, J1502: USB4510-03-1-A; USB4510031A
J603, J1503: GSB12J21C1EU; AMPHENOL_GSB12J21C1EU
L401, L801, L1101, L1301: 2u2; L_Murata_DFE201610P
L501, L502, L1401, L1402: 4u7; L_Murata_DFE201610P
L901, L1001: 10u; L_0402_1005Metric
L902, L1002: 4n7; L_0402_1005Metric
L905, L1005: 2n2; L_0402_1005Metric
L906, L1006: 15n; L_0402_1005Metric
Q501, Q1401: DMP2104LP-7; DMP2104LP7
Q701, Q1201: DMN21D2UFB-7B; DMN21D2UFB7B
R501, R606, R801, R802, R1301, R1302, R1401, R1506: 10k; R_0402_1005Metric
R502, R604, R708, R709, R1204, R1208, R1402, R1504: 100k; R_0402_1005Metric
R503, R1403: 50m; R_0402_1005Metric
R603, R1503: 47k; R_0402_1005Metric
R605, R1505: 12k; R_0402_1005Metric
R701, R1201: 4k7; R_0402_1005Metric
SW502, SW1402: PCM12SMTBR
SW701, SW1227: RIC11-31S15.5D7-TH; RotaryEncoder_Alps_EC11E-Switch_Vertical_H20mm
SW702, SW703, SW704, SW705, SW706, SW707, SW708, SW709, SW710, SW711, SW712, SW713, SW714, SW715, SW716, SW717, SW718, SW719, SW720, SW721, SW722, SW723, SW724, SW725, SW726, SW727, SW728, SW1201, SW1202, SW1203, SW1204, SW1205, SW1206, SW1207, SW1208, SW1209, SW1210, SW1211, SW1212, SW1213, SW1214, SW1215, SW1216, SW1217, SW1218, SW1219, SW1220, SW1221, SW1222, SW1223, SW1224, SW1225, SW1226, SW1228: SW_DIP_x01; choc-v1-hotswap
TP501, TP502, TP1401, TP1402: 3mm; TestPoint_Pad_D3.0mm
U401, U1101: 16B-WLCSP_2p34X2p43_RIT; RT4730WSC
U501, U1401: MAX9938TEBS+TG45; BGA4C50P2X2_100X100X67
U601, U602, U603, U1501, U1502, U1503: USBLC6-4SC6; SOT-23-6
U604, U1504: STM32G0B1KBUx; QFN-32-1EP_5x5mm_P0.5mm_EP3.45x3.45mm
U605, U1505: USB2533-1080AEN; QFN50P600X600X100-37N-D
U801, U1301: STM32U5G9ZJJ6Q; UFBGA144_STM
U802, U1302: M24256X-FCU6T_VF; BGA4C50P2X2_70X98X33
U901, U1001: nRF52840-QFAA-F-R7; QFN40P600X600X95-49N-D
Y601, Y1501: CX2016SA24000D0HLLG3; Crystal_SMD_2016-4Pin_2.0x1.6mm
Y802, Y902, Y1002, Y1302: 32MHz; Crystal_SMD_2016-4Pin_2.0x1.6mm

Connections:
+1V2: C606.1, C1506.1, U605.14 (VDDCR12), U1505.14 (VDDCR12)
+1V8: C506.1, C801.1, C802.1, C803.1, C804.1, C805.1, C806.1, C807.1, C808.1, C809.1, C810.1, C811.1, C813.1, C814.1, C819.1, C907.1, C908.1, C909.1, C910.1, C912.1, C1007.1, C1008.1, C1009.1, C1010.1, C1012.1, C1301.1, C1302.1, C1303.1, C1304.1, C1305.1, C1306.1, C1307.1, C1308.1, C1309.1, C1310.1, C1314.1, C1316.1, C1317.1, C1319.1, C1406.1, IC501.D1 (FB1), IC1401.D1 (FB1), J201.5, J201.15, J301.1, J301.11, J401.5, J401.17, J1101.5, J1101.17, L501.2, L1401.2, Q701.1 (G), Q1201.1 (G), R801.1, R802.1, R1301.1, R1302.1, U801.C2 (VBAT), U801.E3 (VDDDSI), U801.E8 (VDD), U801.E10 (VDD), U801.F5 (VDD), U801.G8 (VDD), U801.G10 (VDD), U801.H5 (VDD), U801.H7 (VDD), U801.J4 (VDDA), U801.J10 (VDD), U801.M8 (VDDSMPS), U802.A1 (VCC), U901.12 (VDD_1), U901.17 (VDD_2), U901.25 (VDD_3), U901.37 (VDD_4), U901.48 (VDD_5), U1001.12 (VDD_1), U1001.17 (VDD_2), U1001.25 (VDD_3), U1001.37 (VDD_4), U1001.48 (VDD_5), U1301.C2 (VBAT), U1301.E3 (VDDDSI), U1301.E8 (VDD), U1301.E10 (VDD), U1301.F5 (VDD), U1301.G8 (VDD), U1301.G10 (VDD), U1301.H5 (VDD), U1301.H7 (VDD), U1301.J4 (VDDA), U1301.J10 (VDD), U1301.M8 (VDDSMPS), U1302.A1 (VCC)
+3V3: C507.1, C601.1, C602.1, C607.1, C608.1, C815.1, C816.1, C817.1, C1311.1, C1313.1, C1315.1, C1407.1, C1501.1, C1502.1, C1507.1, C1508.1, IC501.A3 (VOUT2), IC1401.A3 (VOUT2), J201.10, J301.6, J401.23, J1101.23, U604.4 (VDD), U605.10 (VDDA33_1), U605.15 (VDD33_1), U605.23 (VDD33_2), U605.26 (RESET_N), U605.29 (VDDA33_2), U605.36 (VDDA33_3), U801.D10 (VDDUSB), U801.E6 (VDDIO2), U1301.D10 (VDDUSB), U1301.E6 (VDDIO2), U1504.4 (VDD), U1505.10 (VDDA33_1), U1505.15 (VDD33_1), U1505.23 (VDD33_2), U1505.26 (RESET_N), U1505.29 (VDDA33_2), U1505.36 (VDDA33_3)
+VBAT: C503.1, C1403.1, IC501.C6 (BSNS), IC501.D6 (ISOB), IC1401.C6 (BSNS), IC1401.D6 (ISOB), Q501.2 (D), Q1401.2 (D)
+VSYS: C401.1, C402.1, C505.1, C508.1, C1101.1, C1102.1, C1405.1, C1408.1, IC501.C1 (VIN2), IC501.D2 (VID1), IC501.E2 (EN1), IC501.F2 (VIN1), IC1401.C1 (VIN2), IC1401.D2 (VID1), IC1401.E2 (EN1), IC1401.F2 (VIN1), R503.2, R708.1, R709.1, R1204.1, R1208.1, R1403.2, U401.A1 (PVIN), U401.A2 (AVIN), U501.A2 (RS-), U1101.A1 (PVIN), U1101.A2 (AVIN), U1401.A2 (RS-)
/Left/Bluetooth/ANT: AE202.1 (A), C1006.1, L1005.2
/Left/Bluetooth/DCC1: L1001.1, U1001.47 (DCC)
/Left/Bluetooth/DCC2: L1001.2, L1006.1
/Left/Bluetooth/DEC1: C1011.1, U1001.1 (DEC1)
/Left/Bluetooth/DEC3: C1013.1, U1001.34 (DEC3)
/Left/Bluetooth/DEC4_6: C1014.1, C1015.1, L1006.2, U1001.33 (DEC6), U1001.46 (DEC4)
/Left/Bluetooth/RF1: L1002.1, U1001.31 (ANT)
/Left/Bluetooth/RF2: C1005.1, L1002.2, L1005.1
/Left/Bluetooth/RST: J201.11, U1001.16 (P0.18/NRESET)
/Left/Bluetooth/SWCLK: J201.13, U1001.27 (SWDCLK)
/Left/Bluetooth/SWDIO: J201.12, U1001.26 (SWDIO)
/Left/Bluetooth/XC1: C1003.2, U1001.35 (XC1), Y1002.3
/Left/Bluetooth/XC2: C1004.2, U1001.36 (XC2), Y1002.1
/Left/Display/AVDD: C1106.1, J1101.4, U1101.D2 (AVDD)
/Left/Display/C1N: C1103.2, U1101.B4 (C1N)
/Left/Display/C1P: C1103.1, U1101.A4 (C1P)
/Left/Display/DSI_CKN: J1101.11, U1301.F1 (DSI_CKN)
/Left/Display/DSI_CKP: J1101.10, U1301.F2 (DSI_CKP)
/Left/Display/DSI_D0N: J1101.8, U1301.E1 (DSI_D0N)
/Left/Display/DSI_D0P: J1101.7, U1301.E2 (DSI_D0P)
/Left/Display/DSI_TE: J1101.20, U1301.C5 (PB7)
/Left/Display/ELVDD: C1107.1, J1101.2, U1101.D3 (OVDD)
/Left/Display/ELVSS: C1108.1, C1109.1, J1101.1, U1101.D4 (OVSS)
/Left/Display/LX1: L1101.1, U1101.B1 (LX1)
/Left/Display/LX2: L1101.2, U1101.C1 (LX2)
/Left/Display/SWIRE: J1101.21, U1101.C3 (SWIRE)
/Left/Display/VON: C1105.1, U1101.C4 (VON)
/Left/Display/VOUT: C1104.1, U1101.D1 (VOUT)
/Left/Keys Left/ENC_A: R1204.2, SW1227.A
/Left/Keys Left/ENC_B: R1208.2, SW1227.B
/Left/Keys Left/LED1: D1201.4 (DIN), Q1201.3 (D), R1201.2
/Left/Keys Left/LED2: D1201.2 (DOUT), D1204.4 (DIN)
/Left/Keys Left/LED3: D1204.2 (DOUT), D1207.4 (DIN)
/Left/Keys Left/LED4: D1207.2 (DOUT), D1210.4 (DIN)
/Left/Keys Left/LED5: D1210.2 (DOUT), D1213.4 (DIN)
/Left/Keys Left/LED6: D1213.2 (DOUT), D1216.4 (DIN)
/Left/Keys Left/LED7: D1216.2 (DOUT), D1219.4 (DIN)
/Left/Keys Left/LED8: D1219.2 (DOUT), D1222.4 (DIN)
/Left/Keys Left/LED9: D1222.2 (DOUT), D1225.4 (DIN)
/Left/Keys Left/LED10: D1202.4 (DIN), D1225.2 (DOUT)
/Left/Keys Left/LED11: D1202.2 (DOUT), D1205.4 (DIN)
/Left/Keys Left/LED12: D1205.2 (DOUT), D1208.4 (DIN)
/Left/Keys Left/LED13: D1208.2 (DOUT), D1211.4 (DIN)
/Left/Keys Left/LED14: D1211.2 (DOUT), D1214.4 (DIN)
/Left/Keys Left/LED15: D1214.2 (DOUT), D1217.4 (DIN)
/Left/Keys Left/LED16: D1217.2 (DOUT), D1220.4 (DIN)
/Left/Keys Left/LED17: D1220.2 (DOUT), D1223.4 (DIN)
/Left/Keys Left/LED18: D1223.2 (DOUT), D1226.4 (DIN)
/Left/Keys Left/LED19: D1203.4 (DIN), D1226.2 (DOUT)
/Left/Keys Left/LED20: D1203.2 (DOUT), D1206.4 (DIN)
/Left/Keys Left/LED21: D1206.2 (DOUT), D1209.4 (DIN)
/Left/Keys Left/LED22: D1209.2 (DOUT), D1212.4 (DIN)
/Left/Keys Left/LED23: D1212.2 (DOUT), D1215.4 (DIN)
/Left/Keys Left/LED24: D1215.2 (DOUT), D1218.4 (DIN)
/Left/Keys Left/LED25: D1218.2 (DOUT), D1221.4 (DIN)
/Left/Keys Left/LED26: D1221.2 (DOUT), D1224.4 (DIN)
/Left/Keys Left/LED27: D1224.2 (DOUT), D1227.4 (DIN)
/Left/Main MCU Left/OSC_IN: C1323.2, U1301.H2 (PH0-OSC_IN), Y1302.3
/Left/Main MCU Left/OSC_OUT: C1324.2, U1301.J1 (PH1-OSC_OUT), Y1302.1
/Left/Main MCU Left/PWR_MR: IC1401.E4 (~MR), R1401.2
/Left/Main MCU Left/RST: J201.1, U1301.J2 (NRST)
/Left/Main MCU Left/SCL: R1302.2, U1302.A2 (SCL)
/Left/Main MCU Left/SDA: R1301.2, U1302.B1 (SDA)
/Left/Main MCU Left/SWCLK: J201.3, U1301.B11 (PA14)
/Left/Main MCU Left/SWDIO: J201.2, U1301.C10 (PA13)
/Left/Main MCU Left/USB_RST: J201.6, U1504.6 (PF2)
/Left/Main MCU Left/VDD11: C1321.1, C1322.1, L1301.1, U1301.D4 (VDD11), U1301.G3 (VDD11DSI), U1301.J9 (VDD11)
/Left/Main MCU Left/VLXSMPS: L1301.2, U1301.M7 (VLXSMPS)
/Left/Main MCU Left/VREF+: C1312.1, U1301.H3 (VREF+)
/Left/Power/BAT: Q1401.3 (S), SW1402.1 (A), TP1401.1
/Left/Power/BAT_SW: Q1401.1 (G), SW1402.2 (B)
/Left/Power/SWA_3V3: IC1401.B1 (SW2A), L1402.1
/Left/Power/SWB_3V3: IC1401.A2 (SW2B), L1402.2
/Left/Power/SW_1V8: IC1401.E1 (SW1), L1401.1
/Left/Power/THR: IC1401.B6 (THR), R1402.1
/Left/Power/VSYS_MON: C1404.1, IC1401.E6 (VSYS), R1403.1, U1401.A1 (RS+)
/Left/USB/CFG_SEL1: R1506.1, U1505.25 (HS_IND/~CFG_SEL1)
/Left/USB/RBIAS: R1505.1, U1505.35 (RBIAS)
/Left/USB/SWCLK: J201.8, U1504.25 (PA14)
/Left/USB/SWDIO: J201.7, U1504.24 (PA13)
/Left/USB/USB0_CC1: J1501.A5 (CC1), U1501.1 (I/O1), U1504.18 (PA8)
/Left/USB/USB0_CC2: J1501.B5 (CC2), U1501.3 (I/O2), U1504.17 (PB2)
/Left/USB/USB0_DN: J1501.A7 (D-), J1501.B7 (D-), U1501.6 (I/O4), U1505.30 (FLEX_USBUP_DM)
/Left/USB/USB0_DP: J1501.A6 (D+), J1501.B6 (D+), U1501.4 (I/O3), U1505.31 (FLEX_USBUP_DP)
/Left/USB/USB1_CC1: J1502.A5 (CC1), U1502.1 (I/O1), U1504.26 (PA15)
/Left/USB/USB1_CC2: J1502.B5 (CC2), U1502.3 (I/O2), U1504.28 (PB4)
/Left/USB/USB1_DN: J1502.A7 (D-), J1502.B7 (D-), U1502.6 (I/O4), U1505.1 (SWAP_USBDN1_DM/~PRT_DIS_M1)
/Left/USB/USB1_DP: J1502.A6 (D+), J1502.B6 (D+), U1502.4 (I/O3), U1505.2 (SWAP_USBDN1_DP/~PRT_DIS_P1)
/Left/USB/USB2_DN: J1503.2 (D-), U1503.1 (I/O1), U1505.3 (USBDN2_DM/~PRT_DIS_M2)
/Left/USB/USB2_DP: J1503.3 (D+), U1503.3 (I/O2), U1505.4 (USBDN2_DP/~PRT_DIS_P2)
/Left/USB/USB3_DN: U1301.C12 (PA11), U1505.6 (USBDN3_DM/~PRT_DIS_M3)
/Left/USB/USB3_DP: U1301.C11 (PA12), U1505.7 (USBDN3_DP/~PRT_DIS_P3)
/Left/USB/VBUS_DET: R1503.1, R1504.2, U1505.27 (VBUS_DET/PIO16)
/Left/USB/XTAL1: C1505.1, U1505.33 (XTAL1/REFCLK), Y1501.3
/Left/USB/XTAL2: C1504.1, U1505.32 (XTAL2), Y1501.1
/Right/Bluetooth/ANT: AE302.1 (A), C906.1, L905.2
/Right/Bluetooth/DCC1: L901.1, U901.47 (DCC)
/Right/Bluetooth/DCC2: L901.2, L906.1
/Right/Bluetooth/DEC1: C911.1, U901.1 (DEC1)
/Right/Bluetooth/DEC3: C913.1, U901.34 (DEC3)
/Right/Bluetooth/DEC4_6: C914.1, C915.1, L906.2, U901.33 (DEC6), U901.46 (DEC4)
/Right/Bluetooth/RF1: L902.1, U901.31 (ANT)
/Right/Bluetooth/RF2: C905.1, L902.2, L905.1
/Right/Bluetooth/RST: J301.5, U901.16 (P0.18/NRESET)
/Right/Bluetooth/SWCLK: J301.3, U901.27 (SWDCLK)
/Right/Bluetooth/SWDIO: J301.4, U901.26 (SWDIO)
/Right/Bluetooth/XC1: C903.2, U901.35 (XC1), Y902.3
/Right/Bluetooth/XC2: C904.2, U901.36 (XC2), Y902.1
/Right/Display/AVDD: C406.1, J401.4, U401.D2 (AVDD)
/Right/Display/C1N: C403.2, U401.B4 (C1N)
/Right/Display/C1P: C403.1, U401.A4 (C1P)
/Right/Display/DSI_CKN: J401.11, U801.F1 (DSI_CKN)
/Right/Display/DSI_CKP: J401.10, U801.F2 (DSI_CKP)
/Right/Display/DSI_D0N: J401.8, U801.E1 (DSI_D0N)
/Right/Display/DSI_D0P: J401.7, U801.E2 (DSI_D0P)
/Right/Display/DSI_TE: J401.20, U801.C5 (PB7)
/Right/Display/ELVDD: C407.1, J401.2, U401.D3 (OVDD)
/Right/Display/ELVSS: C408.1, C409.1, J401.1, U401.D4 (OVSS)
/Right/Display/LX1: L401.1, U401.B1 (LX1)
/Right/Display/LX2: L401.2, U401.C1 (LX2)
/Right/Display/SWIRE: J401.21, U401.C3 (SWIRE)
/Right/Display/VON: C405.1, U401.C4 (VON)
/Right/Display/VOUT: C404.1, U401.D1 (VOUT)
/Right/Keys Right/ENC_B: R709.2, SW701.A, SW701.B
/Right/Keys Right/LED1: D701.4 (DIN), Q701.3 (D), R701.2
/Right/Keys Right/LED2: D701.2 (DOUT), D704.4 (DIN)
/Right/Keys Right/LED3: D704.2 (DOUT), D707.4 (DIN)
/Right/Keys Right/LED4: D707.2 (DOUT), D710.4 (DIN)
/Right/Keys Right/LED5: D710.2 (DOUT), D713.4 (DIN)
/Right/Keys Right/LED6: D713.2 (DOUT), D716.4 (DIN)
/Right/Keys Right/LED7: D716.2 (DOUT), D719.4 (DIN)
/Right/Keys Right/LED8: D719.2 (DOUT), D722.4 (DIN)
/Right/Keys Right/LED9: D722.2 (DOUT), D725.4 (DIN)
/Right/Keys Right/LED10: D702.4 (DIN), D725.2 (DOUT)
/Right/Keys Right/LED11: D702.2 (DOUT), D705.4 (DIN)
/Right/Keys Right/LED12: D705.2 (DOUT), D708.4 (DIN)
/Right/Keys Right/LED13: D708.2 (DOUT), D711.4 (DIN)
/Right/Keys Right/LED14: D711.2 (DOUT), D714.4 (DIN)
/Right/Keys Right/LED15: D714.2 (DOUT), D717.4 (DIN)
/Right/Keys Right/LED16: D717.2 (DOUT), D720.4 (DIN)
/Right/Keys Right/LED17: D720.2 (DOUT), D723.4 (DIN)
/Right/Keys Right/LED18: D723.2 (DOUT), D726.4 (DIN)
/Right/Keys Right/LED19: D703.4 (DIN), D726.2 (DOUT)
/Right/Keys Right/LED20: D703.2 (DOUT), D706.4 (DIN)
/Right/Keys Right/LED21: D706.2 (DOUT), D709.4 (DIN)
/Right/Keys Right/LED22: D709.2 (DOUT), D712.4 (DIN)
/Right/Keys Right/LED23: D712.2 (DOUT), D715.4 (DIN)
/Right/Keys Right/LED24: D715.2 (DOUT), D718.4 (DIN)
/Right/Keys Right/LED25: D718.2 (DOUT), D721.4 (DIN)
/Right/Keys Right/LED26: D721.2 (DOUT), D724.4 (DIN)
/Right/Keys Right/LED27: D724.2 (DOUT), D727.4 (DIN)
/Right/Main MCU Right/OSC_IN: C823.2, U801.H2 (PH0-OSC_IN), Y802.3
/Right/Main MCU Right/OSC_OUT: C824.2, U801.J1 (PH1-OSC_OUT), Y802.1
/Right/Main MCU Right/PWR_MR: IC501.E4 (~MR), R501.2
/Right/Main MCU Right/RST: J301.15, U801.J2 (NRST)
/Right/Main MCU Right/SCL: R802.2, U802.A2 (SCL)
/Right/Main MCU Right/SDA: R801.2, U802.B1 (SDA)
/Right/Main MCU Right/SWCLK: J301.13, U801.B11 (PA14)
/Right/Main MCU Right/SWDIO: J301.14, U801.C10 (PA13)
/Right/Main MCU Right/USB_RST: J301.10, U604.6 (PF2)
/Right/Main MCU Right/VDD11: C821.1, C822.1, L801.1, U801.D4 (VDD11), U801.G3 (VDD11DSI), U801.J9 (VDD11)
/Right/Main MCU Right/VLXSMPS: L801.2, U801.M7 (VLXSMPS)
/Right/Main MCU Right/VREF+: C812.1, U801.H3 (VREF+)
/Right/Power/BAT: Q501.3 (S), SW502.1 (A), TP501.1
/Right/Power/BAT_SW: Q501.1 (G), SW502.2 (B)
/Right/Power/SWA_3V3: IC501.B1 (SW2A), L502.1
/Right/Power/SWB_3V3: IC501.A2 (SW2B), L502.2
/Right/Power/SW_1V8: IC501.E1 (SW1), L501.1
/Right/Power/THR: IC501.B6 (THR), R502.1
/Right/Power/VSYS_MON: C504.1, IC501.E6 (VSYS), R503.1, U501.A1 (RS+)
/Right/USB/CFG_SEL1: R606.1, U605.25 (HS_IND/~CFG_SEL1)
/Right/USB/RBIAS: R605.1, U605.35 (RBIAS)
/Right/USB/SWCLK: J301.8, U604.25 (PA14)
/Right/USB/SWDIO: J301.9, U604.24 (PA13)
/Right/USB/USB0_CC1: J601.A5 (CC1), U601.1 (I/O1), U604.18 (PA8)
/Right/USB/USB0_CC2: J601.B5 (CC2), U601.3 (I/O2), U604.17 (PB2)
/Right/USB/USB0_DN: J601.A7 (D-), J601.B7 (D-), U601.6 (I/O4), U605.30 (FLEX_USBUP_DM)
/Right/USB/USB0_DP: J601.A6 (D+), J601.B6 (D+), U601.4 (I/O3), U605.31 (FLEX_USBUP_DP)
/Right/USB/USB1_CC1: J602.A5 (CC1), U602.1 (I/O1), U604.26 (PA15)
/Right/USB/USB1_CC2: J602.B5 (CC2), U602.3 (I/O2), U604.28 (PB4)
/Right/USB/USB1_DN: J602.A7 (D-), J602.B7 (D-), U602.6 (I/O4), U605.1 (SWAP_USBDN1_DM/~PRT_DIS_M1)
/Right/USB/USB1_DP: J602.A6 (D+), J602.B6 (D+), U602.4 (I/O3), U605.2 (SWAP_USBDN1_DP/~PRT_DIS_P1)
/Right/USB/USB2_DN: J603.2 (D-), U603.1 (I/O1), U605.3 (USBDN2_DM/~PRT_DIS_M2)
/Right/USB/USB2_DP: J603.3 (D+), U603.3 (I/O2), U605.4 (USBDN2_DP/~PRT_DIS_P2)
/Right/USB/USB3_DN: U605.6 (USBDN3_DM/~PRT_DIS_M3), U801.C12 (PA11)
/Right/USB/USB3_DP: U605.7 (USBDN3_DP/~PRT_DIS_P3), U801.C11 (PA12)
/Right/USB/VBUS_DET: R603.1, R604.2, U605.27 (VBUS_DET/PIO16)
/Right/USB/XTAL1: C605.1, U605.33 (XTAL1/REFCLK), Y601.3
/Right/USB/XTAL2: C604.1, U605.32 (XTAL2), Y601.1
GND: AE202.2 (Shield), AE302.2 (Shield), C401.2, C402.2, C404.2, C405.2, C406.2, C407.2, C408.2, C409.2, C501.2, C502.2, C503.2, C504.2, C505.2, C506.2, C507.2, C508.2, C601.2, C602.2, C604.2, C605.2, C606.2, C607.2, C608.2, C701.2, C702.2, C703.2, C704.2, C705.2, C706.2, C707.2, C708.2, C709.2, C801.2, C802.2, C803.2, C804.2, C805.2, C806.2, C807.2, C808.2, C809.2, C810.2, C811.2, C812.2, C813.2, C814.2, C815.2, C816.2, C817.2, C819.2, C821.2, C822.2, C823.1, C824.1, C903.1, C904.1, C905.2, C906.2, C907.2, C908.2, C909.2, C910.2, C911.2, C912.2, C913.2, C914.2, C915.2, C1003.1, C1004.1, C1005.2, C1006.2, C1007.2, C1008.2, C1009.2, C1010.2, C1011.2, C1012.2, C1013.2, C1014.2, C1015.2, C1101.2, C1102.2, C1104.2, C1105.2, C1106.2, C1107.2, C1108.2, C1109.2, C1201.2, C1202.2, C1203.2, C1204.2, C1205.2, C1206.2, C1207.2, C1208.2, C1209.2, C1301.2, C1302.2, C1303.2, C1304.2, C1305.2, C1306.2, C1307.2, C1308.2, C1309.2, C1310.2, C1311.2, C1312.2, C1313.2, C1314.2, C1315.2, C1316.2, C1317.2, C1319.2, C1321.2, C1322.2, C1323.1, C1324.1, C1401.2, C1402.2, C1403.2, C1404.2, C1405.2, C1406.2, C1407.2, C1408.2, C1501.2, C1502.2, C1504.2, C1505.2, C1506.2, C1507.2, C1508.2, D701.3 (GND), D702.3 (GND), D703.3 (GND), D704.3 (GND), D705.3 (GND), D706.3 (GND), D707.3 (GND), D708.3 (GND), D709.3 (GND), D710.3 (GND), D711.3 (GND), D712.3 (GND), D713.3 (GND), D714.3 (GND), D715.3 (GND), D716.3 (GND), D717.3 (GND), D718.3 (GND), D719.3 (GND), D720.3 (GND), D721.3 (GND), D722.3 (GND), D723.3 (GND), D724.3 (GND), D725.3 (GND), D726.3 (GND), D727.3 (GND), D1201.3 (GND), D1202.3 (GND), D1203.3 (GND), D1204.3 (GND), D1205.3 (GND), D1206.3 (GND), D1207.3 (GND), D1208.3 (GND), D1209.3 (GND), D1210.3 (GND), D1211.3 (GND), D1212.3 (GND), D1213.3 (GND), D1214.3 (GND), D1215.3 (GND), D1216.3 (GND), D1217.3 (GND), D1218.3 (GND), D1219.3 (GND), D1220.3 (GND), D1221.3 (GND), D1222.3 (GND), D1223.3 (GND), D1224.3 (GND), D1225.3 (GND), D1226.3 (GND), D1227.3 (GND), IC501.A1 (PGND2), IC501.B2 (AGND2), IC501.B3 (ENSD), IC501.B4 (EN2), IC501.F1 (PGND1), IC501.F4 (AGND1), IC1401.A1 (PGND2), IC1401.B2 (AGND2), IC1401.B3 (ENSD), IC1401.B4 (EN2), IC1401.F1 (PGND1), IC1401.F4 (AGND1), J201.4, J201.9, J201.14, J301.2, J301.7, J301.12, J401.6, J401.9, J401.12, J401.14, J401.15, J401.18, J401.22, J401.MP1, J401.MP2, J601.A1 (GND), J601.A12 (GND), J601.MH1, J601.MH2, J601.MH3, J601.MH4, J602.A1 (GND), J602.A12 (GND), J602.MH1, J602.MH2, J602.MH3, J602.MH4, J603.4 (GND), J603.SH1 (SHIELD), J603.SH2 (SHIELD), J603.SH3 (SHIELD), J603.SH4 (SHIELD), J1101.6, J1101.9, J1101.12, J1101.14, J1101.15, J1101.18, J1101.22, J1101.MP1, J1101.MP2, J1501.A1 (GND), J1501.A12 (GND), J1501.MH1, J1501.MH2, J1501.MH3, J1501.MH4, J1502.A1 (GND), J1502.A12 (GND), J1502.MH1, J1502.MH2, J1502.MH3, J1502.MH4, J1503.4 (GND), J1503.SH1 (SHIELD), J1503.SH2 (SHIELD), J1503.SH3 (SHIELD), J1503.SH4 (SHIELD), R502.2, R604.1, R605.2, R606.2, R1402.2, R1504.1, R1505.2, R1506.2, SW502.3 (C), SW502.MP1, SW502.MP2, SW502.MP3, SW502.MP4, SW701.C, SW701.S2, SW702.1, SW703.1, SW704.1, SW705.1, SW706.1, SW707.1, SW708.1, SW709.1, SW710.1, SW711.1, SW712.1, SW713.1, SW714.1, SW715.1, SW716.1, SW717.1, SW718.1, SW719.1, SW720.1, SW721.1, SW722.1, SW723.1, SW724.1, SW725.1, SW726.1, SW727.1, SW728.1, SW1201.1, SW1202.1, SW1203.1, SW1204.1, SW1205.1, SW1206.1, SW1207.1, SW1208.1, SW1209.1, SW1210.1, SW1211.1, SW1212.1, SW1213.1, SW1214.1, SW1215.1, SW1216.1, SW1217.1, SW1218.1, SW1219.1, SW1220.1, SW1221.1, SW1222.1, SW1223.1, SW1224.1, SW1225.1, SW1226.1, SW1227.C, SW1227.S2, SW1228.1, SW1402.3 (C), SW1402.MP1, SW1402.MP2, SW1402.MP3, SW1402.MP4, TP502.1, TP1402.1, U401.A3 (AGND), U401.B2 (PGND), U401.B3 (CPGND), U501.B1 (GND), U601.2 (GND), U602.2 (GND), U603.2 (GND), U604.5 (VSS), U604.33 (VSS), U605.37 (VSS), U801.A1 (VSS), U801.A12 (VSS), U801.D1 (VSSDSI), U801.D5 (VSS), U801.D9 (VSS), U801.F3 (VSSDSI), U801.F6 (VSS), U801.F7 (VSS), U801.F10 (VSS), U801.G6 (VSS), U801.G7 (VSS), U801.H1 (VSSDSI), U801.H10 (VSS), U801.J3 (VSSA), U801.L8 (VSSSMPS), U801.M1 (VSS), U801.M12 (VSS), U802.B2 (VSS), U901.32 (VSS_PA), U901.45 (VSS_1), U901.49 (VSS_2), U1001.32 (VSS_PA), U1001.45 (VSS_1), U1001.49 (VSS_2), U1101.A3 (AGND), U1101.B2 (PGND), U1101.B3 (CPGND), U1301.A1 (VSS), U1301.A12 (VSS), U1301.D1 (VSSDSI), U1301.D5 (VSS), U1301.D9 (VSS), U1301.F3 (VSSDSI), U1301.F6 (VSS), U1301.F7 (VSS), U1301.F10 (VSS), U1301.G6 (VSS), U1301.G7 (VSS), U1301.H1 (VSSDSI), U1301.H10 (VSS), U1301.J3 (VSSA), U1301.L8 (VSSSMPS), U1301.M1 (VSS), U1301.M12 (VSS), U1302.B2 (VSS), U1401.B1 (GND), U1501.2 (GND), U1502.2 (GND), U1503.2 (GND), U1504.5 (VSS), U1504.33 (VSS), U1505.37 (VSS), Y601.2, Y601.4, Y802.2, Y802.4, Y902.2, Y902.4, Y1002.2, Y1002.4, Y1302.2, Y1302.4, Y1501.2, Y1501.4
VBUS: C501.1, C701.1, C702.1, C703.1, C704.1, C705.1, C706.1, C707.1, C708.1, C709.1, C1201.1, C1202.1, C1203.1, C1204.1, C1205.1, C1206.1, C1207.1, C1208.1, C1209.1, C1401.1, D701.1 (VDD), D702.1 (VDD), D703.1 (VDD), D704.1 (VDD), D705.1 (VDD), D706.1 (VDD), D707.1 (VDD), D708.1 (VDD), D709.1 (VDD), D710.1 (VDD), D711.1 (VDD), D712.1 (VDD), D713.1 (VDD), D714.1 (VDD), D715.1 (VDD), D716.1 (VDD), D717.1 (VDD), D718.1 (VDD), D719.1 (VDD), D720.1 (VDD), D721.1 (VDD), D722.1 (VDD), D723.1 (VDD), D724.1 (VDD), D725.1 (VDD), D726.1 (VDD), D727.1 (VDD), D1201.1 (VDD), D1202.1 (VDD), D1203.1 (VDD), D1204.1 (VDD), D1205.1 (VDD), D1206.1 (VDD), D1207.1 (VDD), D1208.1 (VDD), D1209.1 (VDD), D1210.1 (VDD), D1211.1 (VDD), D1212.1 (VDD), D1213.1 (VDD), D1214.1 (VDD), D1215.1 (VDD), D1216.1 (VDD), D1217.1 (VDD), D1218.1 (VDD), D1219.1 (VDD), D1220.1 (VDD), D1221.1 (VDD), D1222.1 (VDD), D1223.1 (VDD), D1224.1 (VDD), D1225.1 (VDD), D1226.1 (VDD), D1227.1 (VDD), IC501.F6 (VBUS), IC1401.F6 (VBUS), J601.A4 (VBUS), J601.A9 (VBUS), J602.A4 (VBUS), J602.A9 (VBUS), J603.1 (VCC), J1501.A4 (VBUS), J1501.A9 (VBUS), J1502.A4 (VBUS), J1502.A9 (VBUS), J1503.1 (VCC), R603.2, R701.1, R1201.1, R1503.2, U601.5 (VBUS), U602.5 (VBUS), U603.5 (VBUS), U1501.5 (VBUS), U1502.5 (VBUS), U1503.5 (VBUS)
VDD: C502.1, C1402.1, IC501.F5 (VDD), IC1401.F5 (VDD), R501.1, R1401.1
