ben5049/Keyboard/(commit log)

2024-05-12 Layout done, need to route.
    [left_board.kicad_pcb, left_board.kicad_sch, right_board.kicad_pcb, right_board.kicad_sch]
2024-05-13 Left board routing half done
    [left_board.kicad_pcb, left_board.kicad_sch]
2024-05-13 Left board done
    [BOM.xlsx, left_board.kicad_pcb, left_board.kicad_sch]
2024-05-14 Right board done, all components ordered
    [BOM.xlsx, left_board.kicad_pcb, left_board.kicad_sch, right_board.kicad_pcb, right_board.kicad_sch]
2024-05-16 BOM and README updates
    [BOM.xlsx]
2024-05-17 Pinout updates
    [right_board.kicad_pcb, right_board.kicad_sch]
2024-05-18 Enclosure v1 finished
    [Left bottom.stl, Left frame.stl, Right bottom.stl, Right frame.stl]
2024-05-18 Created PCB BOMs & LED covers
    [LED Cover x8.stl, LED Cover.stl, left_board.kicad_pcb, right_board.kicad_pcb]
2024-05-19 Added USBX examples to /Examples
    [Left bottom no holes.stl, Right bottom no holes.stl]
2024-05-20 USB Progress, need to rewrite device descriptors.
2024-05-20 USB Device descriptor wrangling done
2024-05-27 USB Hub working and keyboard device class working
2024-05-28 Key struct updated to include modifier keys and layer switching.
2024-06-10 Knobs work properly
    [left_board.kicad_sch, right_board.kicad_sch]
2024-07-08 V2 Started
    [bluetooth.kicad_sch, display.kicad_sch, keyboard_v2.kicad_pcb, keyboard_v2.kicad_sch, keys_left.kicad_sch, keys_right.kicad_sch, left.kicad_sch, main_mcu_left.kicad_sch]
2024-07-08 V2 progress
    [bluetooth.kicad_sch, display.kicad_sch, keyboard_v2.kicad_pcb, keyboard_v2.kicad_sch, keys_left.kicad_sch, keys_right.kicad_sch, left.kicad_sch, main_mcu_left.kicad_sch]
2024-07-10 Display schematic done
    [bluetooth.kicad_sch, display.kicad_sch, keys_left.kicad_sch, keys_right.kicad_sch, left.kicad_sch, main_mcu_right.kicad_sch, right.kicad_sch, usb.kicad_sch]
2024-07-11 V2 Schematic mostly done
    [bluetooth.kicad_sch, display.kicad_sch, keyboard_v2.kicad_pcb, keyboard_v2.kicad_sch, keys_left.kicad_sch, keys_right.kicad_sch, left.kicad_sch, main_mcu_left.kicad_sch]
2024-07-11 Added debug header footprint
    [left.kicad_sch, power.kicad_sch, right.kicad_sch]
2024-07-13 Schematic mostly done, moving onto PCB
    [keyboard_v2.kicad_pcb, keys_left.kicad_sch, keys_right.kicad_sch, main_mcu_left.kicad_sch, main_mcu_right.kicad_sch]
2024-07-13 Started routing
    [keyboard_v2.kicad_pcb]
2024-07-14 Layout in progress
    [bluetooth.kicad_sch, left.kicad_sch, right.kicad_sch, usb.kicad_sch, usb_left.kicad_sch, usb_right.kicad_sch]
2024-07-15 Layout progress
    [usb_left.kicad_sch, usb_right.kicad_sch]
2024-07-15 Placement done
    [bluetooth.kicad_sch, display.kicad_sch, keyboard_v2.kicad_sch, keys_left.kicad_sch, keys_right.kicad_sch, left.kicad_sch, main_mcu_left.kicad_sch, main_mcu_right.kicad_sch]
2024-07-19 339 Unrouted
    [bluetooth.kicad_sch, display.kicad_sch, keyboard_v2.kicad_sch, keys_left.kicad_sch, keys_right.kicad_sch, left.kicad_sch, main_mcu_left.kicad_sch, main_mcu_right.kicad_sch]
2024-07-20 279 Unrouted
    [bluetooth.kicad_sch, main_mcu_left.kicad_sch, main_mcu_right.kicad_sch]
2024-07-21 249 Unrouted
    [main_mcu_right.kicad_sch, usb_left.kicad_sch, usb_right.kicad_sch]
2026-02-08 Moved v1 & v2 and started v3
    [bluetooth.kicad_sch, display.kicad_sch, keyboard_v2.kicad_sch, keys_left.kicad_sch, keys_right.kicad_sch, left.kicad_sch, left_board.kicad_pcb, left_board.kicad_sch]
2026-02-09 Deleted delmes
    [right-control-board.kicad_sch]
2026-02-10 Updated right-control-board layout
    [right-control-board.kicad_pcb, right-control-board.kicad_sch, right-key-board-components.dxf, right-key-board.kicad_pcb]
2026-02-10 Added allowed component area to right-key-board
    [right-key-board-layout.dxf, right-key-board-outline.dxf, right-key-board.kicad_pcb]
2026-02-11 Right control board schematic almost done
    [daughter-board-connectors.kicad_sch, debug-connector.kicad_sch, mcu.kicad_sch, power.kicad_sch, right-control-board-outline.dxf, right-control-board.kicad_pcb, right-control-board.kicad_sch, right-knob-board-outline.dxf]
2026-02-12 Key board schematic done and layout half done
    [daughter-board-connectors.kicad_sch, keys.kicad_sch, knob-fpc-outline.dxf, mcu.kicad_sch, right-control-board-layout.dxf, right-control-board.kicad_pcb, right-key-board.kicad_pcb, right-key-board.kicad_sch]
2026-02-13 Added FPC panel
    [fpc.kicad_pcb, fpc.kicad_sch, key-fpc-outline.dxf, knob-fpc-mask.dxf, knob-fpc-stiffener.dxf, knob-fpc-traces.dxf]
2026-02-14 Right daughter boards finished
    [keys.kicad_sch, mcu.kicad_sch, right-key-board.kicad_pcb, right-knob-board.kicad_pcb, right-knob-board.kicad_sch]
2026-02-15 Updated control-board firmware repo
2026-02-16 Added debug-breakout board, progress on right side schematics & layout
    [daughter-board-connectors.kicad_sch, debug-breakout.kicad_pcb, debug-breakout.kicad_sch, debug-connector.kicad_sch, left-control-board.kicad_pcb, left-control-board.kicad_sch, mcu.kicad_sch, power.kicad_sch]
2026-02-16 Added power gate to AS5600 to reduce its sleep current
    [left-control-board.kicad_sch, right-knob-board.kicad_pcb, right-knob-board.kicad_sch, sd-card.kicad_sch]
2026-02-17 Right control board placement and schematic done
    [daughter-board-connectors.kicad_sch, debug-breakout.kicad_sch, debug-connector.kicad_sch, mcu.kicad_sch, power.kicad_sch, right-control-board.kicad_pcb, right-control-board.kicad_sch, right-key-board.kicad_pcb]
2026-02-18 Right control board ~50 unrouted
    [right-control-board.kicad_pcb, right-control-board.kicad_sch, usb-connectors.kicad_sch]
2026-02-19 Right control board routing finished
    [debug-connector.kicad_sch, right-control-board.kicad_pcb, usb-connectors.kicad_sch]
2026-02-21 Added mounting holes
    [daughter-board-connectors.kicad_sch, debug-connector.kicad_sch, keys.kicad_sch, mcu.kicad_sch, power.kicad_sch, right-control-board.kicad_pcb, right-control-board.kicad_sch, right-key-board.kicad_pcb]
2026-02-22 Moved charging LED
    [right-control-board.kicad_pcb]
2026-02-23 Finished debug breakout board and added 5V voltage sensing to key board
    [debug-breakout.kicad_pcb, debug-breakout.kicad_sch, mcu.kicad_sch, right-key-board.kicad_pcb]
2026-02-28 Left key board done
    [keys.kicad_sch, left-key-board.kicad_pcb, left-key-board.kicad_sch, mcu.kicad_sch, right-control-board.kicad_pcb, right-key-board.kicad_pcb, right-knob-board.kicad_pcb, right-knob-board.kicad_sch]
2026-03-01 Left knob board done
    [daughter-board-connectors.kicad_sch, debug-connector.kicad_sch, left-control-board.kicad_pcb, left-control-board.kicad_sch, left-knob-board.kicad_pcb, left-knob-board.kicad_sch, left-knob-board.step, mcu.kicad_sch]
2026-03-01 Left control board done
    [left-control-board.kicad_pcb, left-key-board.kicad_pcb, mcu.kicad_sch, right-control-board.kicad_pcb]
2026-03-02 Keyboard v3 hardware done
    [LED Cover x8.stl, LED Cover.stl, Left bottom no holes.stl, Left bottom.stl, Left frame.stl, Right bottom no holes.stl, Right bottom.stl, Right frame.stl]
2026-03-15 Added v3 left BOMs and updated buck inductor
    [left-control-board.csv, left-control-board.kicad_pcb, left-key-board.csv, left-knob-board.csv, power.kicad_sch, right-control-board.kicad_pcb]
