ben5049/Keyboard/(notices)

Notices in the files:
firmware/firmware-v1/v1_left_keyboard_firmware/Core/Inc/main.h:
Copyright (c) 2026 STMicroelectronics.
All rights reserved.
This software is licensed under terms that can be found in the LICENSE file
